sabrehagen/oberheim-dx-timeshift/PROJECT_BRIEF.md

# Oberheim DX "Snare TimeShift" modification — shared project brief

This file is the single source of truth for everyone (human or agent) working on this
project. If you discover that something here is wrong, fix it HERE first, then fix your
own deliverable, and say so in your final report.

## 1. Goal (the user's words, condensed)

Add a potentiometer to the rear panel of an Oberheim DX drum machine, next to the existing
snare tuning pot, that delays the trigger of the snare voice. Turning it up pushes the snare
later ("lays the groove back"). Range: 0 to 1 beat. 0 = unmodified behaviour.

The result is handed to an electronics technician via a GitHub repo. Documentation must be
clear enough for a high-school student to follow, while being precise enough for a skilled
technician to trust.

## 2. Why "one beat" forces a digital, tempo-aware design

A beat is a musical unit, not a time unit. One beat at 120 BPM is 500 ms; at 90 BPM it is
667 ms. A purely analog delay (RC timer / monostable) can only give a fixed number of
milliseconds, so it would be "one beat" at only one tempo. To make the pot read 0–1 beat at
any tempo the module must know the tempo. The DX exposes its tempo as a 96 PPQN
(pulses per quarter note) clock. So: delay in clock ticks = round(pot_fraction × 96).
This gives 1/96-beat resolution (5.2 ms at 120 BPM), which is finer than any human ear needs.

## 3. Chosen architecture (CHANGED BY RESEARCH, 2026-11-06; see docs/research/dx-findings.md)

> **CHANGED BY RESEARCH:** the original baseline assumed the DX had plug-in voice cards
> on card-edge slots, so the interposer would be a riser card under the snare card.
> **That is wrong.** The Oberheim DX has **no voice cards, no slots and no backplane**.
> All six voices are built on the single "DX Processor Board" (drawing 1721A). VERIFIED by
> the DX parts-layout drawing, the Electrongate DMX/DX comparison ("Removable voice cards:
> DX No") and photos of the board. The snare is triggered by **three latched logic levels**
> (`RST2`, `FFA2`, `FFB2`) coming from **U701**, a 16-pin DIP hex D flip-flop
> (MC14174B / 74C174). The interposer therefore moves from "riser under a voice card" to
> **"adapter in the U701 IC socket"**. Everything below is the corrected baseline. The
> original card-edge text was removed so that nobody builds it by mistake.

```
   DX Processor Board (one big PCB, all voices on it)
   ┌──────────────────────────────────────────────────────────────────┐
   │  Z80 ──OUT (10h)──► U701 socket (DIP-16)        snare circuit      │
   │                      pins 10/12/15 ─── traces ──► U204/U207/U208    │
   │                      (FFB2/FFA2/RST2)             (4013, 4040)      │
   └──────────────────────┬───────────────────────────────────────────┘
                          │ DIP-16 plug (Option B: 10–15 cm ribbon with DIP-16 IDC plug;
                          │              Option A: stacked machined-pin adapter, only if
                          │              the lid clearance allows, see findings Q3)
                 ┌────────┴──────────────────────────────┐
                 │ DX TIMESHIFT board                    │
                 │  [DIP-16 socket: original U701 chip]  │  13 pins straight through
                 │   pins 10,12,15 ──► MCU inputs (RST2→INT0)
                 │                └──► 74HC157 mux "A" (bypass)
                 │  [MCU: Nano] ──► 74HC157 mux "B" (delayed)
                 │  74HC157 Y ──► plug pins 10,12,15 ──► back to the DX snare circuit
                 └────────────────────────────────────────┘
   Rear panel: [DELAY pot 10k lin]──3-wire lead──► J_POT
   Clock tap:  CLOCK OUT node (Q709 collector / R791 lead) ──10 kΩ──► J_CLK (Schmitt input)
```

Design principles, in priority order:
1. **Reversible.** No cuts to original Oberheim PCBs. Unplug the TimeShift plug, put the
   original U701 chip back in its socket, unclip the clock lead, and the DX is stock. The only
   permanent change is one hole in the rear panel for the pot. **CHANGED BY RESEARCH:** this
   needs U701 to be socketed. Photos of two DX units indicate it is, but this is TO BE
   CONFIRMED (findings Q1). If it is soldered, the only option is to desolder it and fit a
   socket, which is a permanent but restorable change. Tell the owner before doing it.
2. **Transparent at zero.** With the pot at 0 the module passes the snare lines through with
   no added logic delay worth mentioning. **CHANGED BY RESEARCH:** do this with a hardware
   2:1 mux (74HC157) whose select line is pulled to "bypass" by a resistor. Pot = 0, MCU in
   reset, MCU unprogrammed → the DX behaves stock, with about 10 ns added. Level (soft/medium/loud)
   information must be preserved exactly.
3. **Technician-friendly.** Through-hole parts, 2.54 mm headers, a socketed Arduino Nano
   (ATmega328P, 5 V, 16 MHz) programmed over USB with the Arduino IDE. No SMD soldering required.
4. **Honest documentation.** Every pin number, signal name and connector type is labelled either
   VERIFIED (with a citation to the service manual page / schematic sheet) or
   TO BE CONFIRMED ON THE BENCH (with the exact measurement the technician should make).
5. **Model check first (CHANGED BY RESEARCH).** The pin numbers are for the plain **DX
   (board 1721A)**. On the **DXa** (factory MIDI, board 1906) the snare lines are on **U715
   pins 7/5/2**, not U701 pins 15/12/10. The PCB must be marked with the model it fits.

### 3.1 Signal capture/replay detail (CHANGED BY RESEARCH)

* **What the Z80 actually does (VERIFIED, schematic + firmware disassembly):** `OUT (10h),A`
  with D3 = RST2, D4 = FFA2, D5 = FFB2 (D0–D2 are the BASS voice: leave them alone). The write
  strobe GEN0* clocks U701 on its rising edge, and U701's outputs then **hold** those levels
  until the next write. A snare hit is **three writes**: (1) new FFA2/FFB2 level with RST2 = 0,
  (2) RST2 = 1, (3) RST2 = 0. RST2 high resets the snare sample address counter (level-sensitive
  CD4040 reset). The RST2 rising edge also clocks the DX's level flip-flops. **The sound starts
  on the RST2 falling edge.** RST2 is high for about **9 µs** (firmware 1.5) up to about
  **0.2 ms** (firmware 1.20). TO BE CONFIRMED with a logic analyser (findings Q2).
* **Capture:** U701 itself is the capture latch, so no 74HC574 is needed. Wire U701 pin 15
  (RST2) to the Nano's **INT0 (D2), rising edge**. The AVR latches the edge flag in hardware,
  so a 9 µs pulse is never lost. In the ISR read FFA2 (pin 12) and FFB2 (pin 10); they are
  stable for ≥ 1 ms. Push (FFA2, FFB2, timestamp) into the FIFO. A 74HC74 edge flag is
  optional.
* **Replay:** when an event is due, drive `FFA2_OUT`/`FFB2_OUT` to the captured levels, wait
  ≥ 1 µs, drive `RST2_OUT` high for ≥ 10 µs, then low. Keep FFA2/FFB2 held until the next
  replayed event (they are level-sensitive on the snare circuit for the whole sound).
* **Isolation:** U701 pins 10/12/15 on the chip side go ONLY to the TimeShift inputs. The
  matching pins of the plug that goes into the DX socket are driven ONLY by the 74HC157
  output. There is no straight-through connection for those three pins. All other 13 pins
  are straight through.
* **Bypass:** pot exactly 0, or MCU not running → 74HC157 selects the U701 outputs directly
  (hardware path, no firmware latency). Change the mux select only while RST2 is low on
  both sides.
* Edge case: a new snare hit arriving while one is queued → both are queued; FIFO depth ≥ 32.
  Hits queued before STOP still play after STOP. Optionally flush the queue if no clock pulse
  has been seen for > 125 ms (the DX's own auto-stop timeout).

### 3.2 Tempo reference

* Count rising edges of the DX clock. **VERIFIED:** the DX's internal tempo timer interrupts
  96 times per quarter note, and the firmware pulses CLOCK OUT once per interrupt (96 PPQN).
  delay_ticks = round(pot_fraction × PPQN). Fire the queued event on the tick when
  (ticks_since_capture ≥ delay_ticks), with sub-tick interpolation using the measured tick
  period so the pot feels continuous rather than stepped.
* **CHANGED BY RESEARCH:** on a DXa, Stretch DX or Electrongate-MIDI DX, CLOCK OUT can be set
  to 24, 48 or 96 PPQN (edit parameter 03; when slaved to MIDI it is forced to 24). Add a
  **PPQN jumper (96 default / 48 / 24)** read by the firmware.
* No clock present (sequencer stopped, pads played by hand): use the last measured tick period;
  if none ever seen, assume 120 BPM. Document this behaviour. (Whether the DX keeps sending
  CLOCK OUT while stopped is TO BE CONFIRMED, findings Q5.)
* **Where to tap (CHANGED BY RESEARCH):** the rear jacks are soldered onto the main board, so
  the "jumper to the jack tip" fallback would mean soldering under the board. Instead tap the
  CLOCK OUT node on the top of the board. Use the lead of **R791 (1 kΩ)** on the Q709-collector
  side: same signal as the jack tip, 0/5 V, idles low, **rising edge = tick**. Use a clip-on
  mini-grabber, or tack-solder to the resistor lead. Alternative: R792's U710 side (= COUT,
  opposite polarity). Feed it through 10 kΩ series into a Schmitt input (74HC14 or equivalent)
  on the TimeShift.

### 3.3 Power (CHANGED BY RESEARCH)

+5 V and GND from U701 socket pins 16 and 8 through the plug (no extra wires). Budget < 60 mA
total. Add 100 nF decoupling per IC and a 10 µF bulk cap. **There are no ±12 V rails on this
socket.** Never use the battery-backed "+5M" rail. If the measured drop between the "+5 TEST
PAD" and U701 pin 16 exceeds 50 mV with the module running, add a separate 2-wire lead to the
+5 test pad (findings Q7). The DX PSU is linear: µA723 + 2N3055, current limit about 2.6 A
(inferred); the unit is rated 19 W from the mains.

### 3.4 Panel pot

10 kΩ linear, 1/4" (6.35 mm) or 6 mm shaft, panel-mount, solder lugs. Wiring: CW end → +5 V,
CCW end → GND, wiper → MCU ADC input via 1 kΩ series + 100 nF to ground (RC filter). 3-pin
JST-XH on the TimeShift board. Label the panel "SNARE DELAY  0 ◄──► 1 BEAT".
**CHANGED BY RESEARCH:** the DX's six DRUM TUNING pots have short bare shafts with **no knobs**.
SNARE is second from the right when you look at the rear panel. Either match that (short shaft,
no knob) or use a small knob. Candidate hole: directly below the SNARE tuning pot, in the
blank band above the output-jack labels. The space behind the panel must be confirmed first,
because the tuning-pot PCB is mounted there (findings Q6).

### 3.5 Definitive board interface (LOCKED by orchestrator — every agent uses exactly this)

**Arduino Nano (ATmega328P, 5 V) pin assignment**

| Nano pin | Direction | Net name  | Purpose |
|---|---|---|---|
| D2 (INT0) | in  | RST2_IN  | from U701 pin 15 (chip side). Rising edge = snare hit captured |
| D3 (INT1) | in  | CLK_IN | DX clock tick after Schmitt buffer. Rising edge = 1 tick |
| D4 | in  | FFA2_IN  | from U701 pin 12 (chip side), level bit A |
| D5 | in  | FFB2_IN  | from U701 pin 10 (chip side), level bit B |
| D6 | out | RST2_OUT | replayed trigger → 74HC157 input 1B |
| D7 | out | FFA2_OUT | replayed level A → 74HC157 input 2B |
| D8 | out | FFB2_OUT | replayed level B → 74HC157 input 3B |
| D9 | out | MUX_SEL  | 74HC157 S (pin 1). LOW = A = bypass (10 kΩ pull-down to GND), HIGH = B = delayed |
| D10 | in | PPQN_J1  | jumper to GND, internal pull-up. open/open = 96, JP1 1-2 closed = 48, JP1 3-4 closed = 24 |
| D11 | in | PPQN_J2  | see above |
| D12 | out | TP_REPLAY | test point: pulses high whenever a delayed hit is replayed |
| D13 | out | LED_ACT  | on-board LED: flashes on each captured hit; steady when in bypass |
| A0 | in | POT_W | pot wiper, via 1 kΩ series + 100 nF to GND |

**74HC157 (U3, quad 2:1 mux)**: pin 1 S = MUX_SEL; pin 15 /E = GND (always enabled);
channel 1: 1A = RST2 chip side (U701 pin 15), 1B = RST2_OUT, 1Y → plug pin 15;
channel 2: 2A = FFA2 chip side (U701 pin 12), 2B = FFA2_OUT, 2Y → plug pin 12;
channel 3: 3A = FFB2 chip side (U701 pin 10), 3B = FFB2_OUT, 3Y → plug pin 10;
channel 4 unused: 4A, 4B to GND, 4Y n/c.

**74HC14 (U4, hex Schmitt inverter)**: clock conditioning. J_CLK pin 1 → 10 kΩ series (R_CLK1)
→ node with 100 kΩ pull-down (R_CLK2) and 1 nF to GND → U4 gate 1 → gate 2 → CLK_IN (two
inversions = non-inverting, so rising edge at R791 = rising edge at D3). Unused inputs to GND.

**U1**: DIP-16 socket that receives the ORIGINAL U701 chip removed from the DX (MC14174B / 74C174).
Pins 1–9, 11, 13, 14, 16 of U1 connect straight to the same-numbered pin of the plug J1.
U1 pins 10, 12, 15 connect ONLY to the Nano inputs and the 74HC157 "A" inputs. J1 pins 10, 12,
15 are driven ONLY by the 74HC157 "Y" outputs. Add 1 kΩ series resistors between U1 pins
10/12/15 and the Nano inputs D5/D4/D2 for protection; the mux A inputs connect directly.

**J1 "DX PLUG"**: 2×8 2.54 mm shrouded box header (pin 1 marked). A 16-way ribbon with a
DIP-16 IDC plug on the far end goes into the DX's U701 socket. Standard DIP IDC plug mapping
(ribbon conductor n → header pin n): header 1→DIP 1, 2→DIP 16, 3→DIP 2, 4→DIP 15, 5→DIP 3,
6→DIP 14, 7→DIP 4, 8→DIP 13, 9→DIP 5, 10→DIP 12, 11→DIP 6, 12→DIP 11, 13→DIP 7, 14→DIP 10,
15→DIP 8, 16→DIP 9. The schematic nets on J1 MUST already use DIP pin numbers after this
mapping (i.e. label the box header pins with the DIP pin they end up on). This mapping is TO BE
CONFIRMED with a continuity meter before first power-up (documented as a mandatory step).
Ribbon length 10–15 cm. Option A (stacked machined-pin header plug directly into the socket)
is a documented alternative only if lid clearance allows.

**J2 "POT"**: 3-pin JST-XH, pin 1 = GND (CCW lug), pin 2 = wiper, pin 3 = +5 V (CW lug).
**J3 "CLK"**: 2-pin JST-XH, pin 1 = CLK signal (to R791 lead, Q709 collector side), pin 2 = GND.
**JP1**: 2×2 pin header for PPQN_J1 / PPQN_J2 to GND (use a jumper shunt).
**TP1** = TP_REPLAY, **TP2** = RST2 chip side, **TP3** = RST2 plug side, **TP4** = GND, **TP5** = CLK_IN.
**Power**: C_bulk 10 µF electrolytic across +5/GND at J1; 100 nF ceramic next to U1, U3, U4 and Nano.
**Board** (as built, rev A): 2-layer, 84.0 × 63.0 mm (grew from the planned 65 × 40 mm because the through-hole parts did not fit), 4 × M3 mounting holes (3.2 mm) on 77 × 56 mm centres, all
through-hole. Silkscreen: "DX TIMESHIFT rev A — SNARE — fits Oberheim DX board 1721A (U701).
NOT for DXa (U715)". Nano on two 1×15 female headers so it is removable.
**USB warning (added after firmware review):** the Nano's 5 V pin sits on the DX logic rail, so
plugging a USB cable into the Nano while it is installed in a switched-off DX would try to power
the whole DX logic board from the USB port. Silkscreen must say "UNPLUG NANO BEFORE USB" next to
the Nano, and every document that mentions flashing must say: flash the Nano OUT of the board,
or only with the DX switched on.

### 3.6 Firmware behaviour (LOCKED)

* Boot: all outputs low, MUX_SEL low (bypass), read PPQN jumpers once, LED steady on.
* Pot read at ~100 Hz, 16-sample average, with hysteresis so the delay doesn't jitter.
  pot ≤ 1 % → BYPASS mode (MUX_SEL low). Otherwise DELAY mode: delay_beats = pot_fraction
  (1 % … 100 %), clamp to 1.00 beat.
* Entering DELAY mode: copy the current chip-side FFA2/FFB2 levels to FFA2_OUT/FFB2_OUT, set
  RST2_OUT low, then raise MUX_SEL. Leaving DELAY mode: wait until no replay is in progress,
  drop MUX_SEL. Never change MUX_SEL while either RST2 is high.
* INT0 ISR (RST2_IN rising): read FFA2_IN/FFB2_IN, push {levelA, levelB, t_us = micros(),
  ticks_at_capture} into a 32-deep ring buffer. Toggle LED.
* INT1 ISR (CLK_IN rising): tick_count++, measure tick period (µs) with a 4-tick moving average.
  Clock timeout: if no tick for > 2 s treat as "stopped" but keep the last period.
* Scheduler (main loop): a captured event is due when elapsed_us ≥ delay_beats × PPQN ×
  tick_period_us (tempo-aware, continuous). Default tick_period when never clocked =
  60e6 / (120 × PPQN) µs. Replay = set level outputs, delayMicroseconds(2), RST2_OUT high for
  20 µs, low. Pulse TP_REPLAY alongside.
* Multiple queued events are all replayed in order. Events older than 4 s are dropped.
* Serial (115200 baud) prints a one-line status every second for debugging: mode, pot %, PPQN,
  BPM estimate, queue depth, hits captured/replayed. Serial must never block or delay replay.

## 4. Repository layout (all agents write into these paths)

```
PROJECT_BRIEF.md              this file
README.md                     front page for the technician (docs agent)
docs/
  00-start-here.md            plain-language overview, what to buy, how long it takes
  01-theory-of-operation.md   how the DX triggers voices, how the mod works, timing diagrams
  02-build-the-board.md       assembly steps with photos/renders, checklist
  03-install-in-the-dx.md     step-by-step install, panel drilling, wiring, safety
  04-test-and-calibrate.md    bench tests, expected measurements, troubleshooting
  05-bench-verification.md    the list of TO-BE-CONFIRMED items with how to measure each
  bom.md / bom.csv            bill of materials with part numbers and sources
  reference/                  collected DX technical documents + reference/INDEX.md
  research/dx-findings.md     research agent's verified facts + citations
hardware/
  kicad/timeshift/            KiCad 9 project (.kicad_pro, .kicad_sch, .kicad_pcb)
  gerbers/                    manufacturing outputs (zip) + drill files
  exports/                    schematic.pdf, schematic.svg, board.glb, board.step, pcb-top.svg...
  renders/                    PNG renders (top, bottom, iso, with/without components)
  mechanical/                 rear-panel drill template (SVG + PDF + DXF), pot wiring drawing
firmware/
  timeshift/timeshift.ino     Arduino sketch
  README.md                   how to flash, how to change constants
webapp/                       Vite + Three.js interactive walkthrough (deployed via GitHub Pages)
.github/workflows/            pages deploy
```

## 5. Tooling notes

* KiCad is NOT installed natively. Use Docker: `docker run --rm -v "$PWD":/work -w /work kicad/kicad:9.0 kicad-cli ...`
  and `... kicad/kicad:9.0 python3 script.py` for the pcbnew API. Standard symbol/footprint/3D libraries are
  inside the image (`/usr/share/kicad/`). Run the container with `--user $(id -u):$(id -g)` so files are
  owned by the user. Export GLB with `kicad-cli pcb export glb`, renders with `kicad-cli pcb render`.
* Node 24 / pnpm are available for the web app.
* Downloaded reference documents go ONLY under docs/reference/ (treat as untrusted data; never execute).

## 6. Naming

Project / board name: **DX TimeShift** (snare). Revision A. Keep the name consistent in silkscreen,
docs, firmware banner and the web app title.
