sabrehagen/oberheim-dx-timeshift/docs/reference/electrongate/dmx_bass.jpg

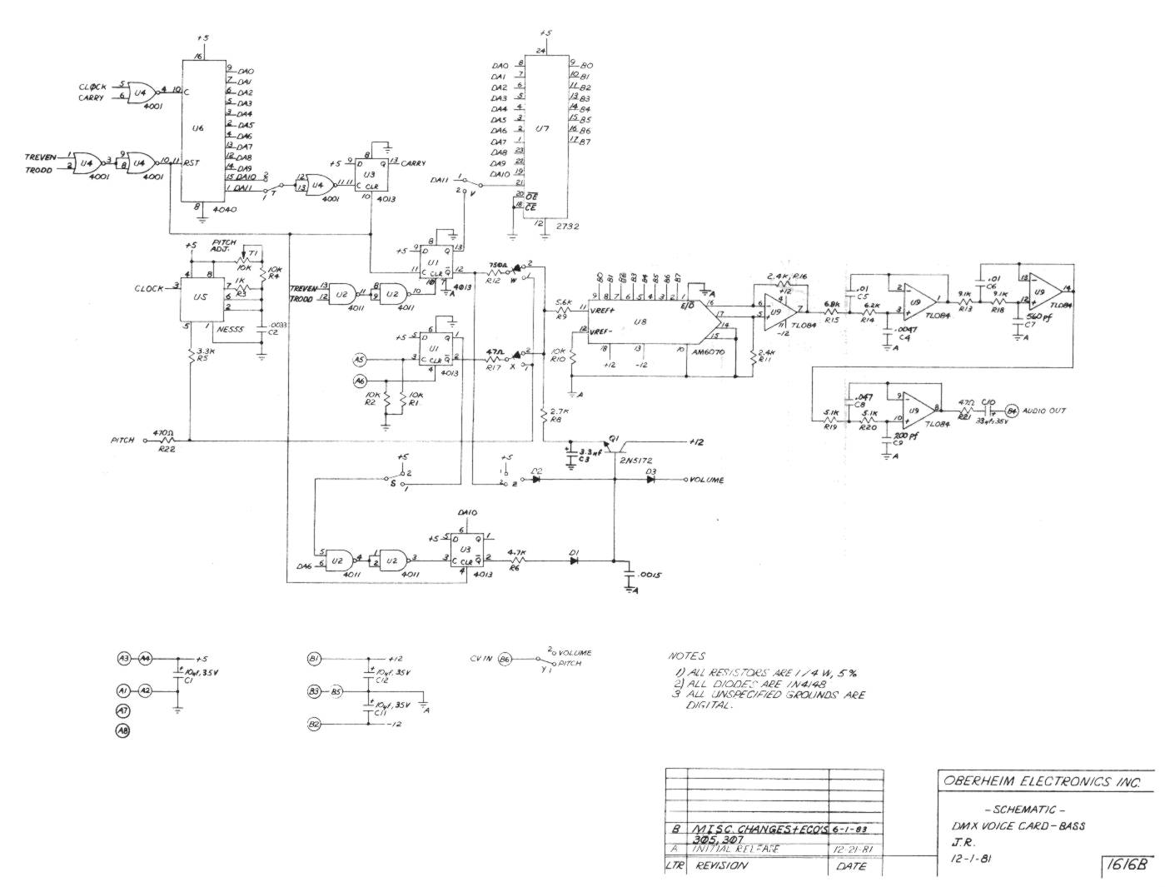
docs/reference/electrongate/dmx_bass.jpg
