sabrehagen/oberheim-dx-timeshift/docs/reference/electrongate/dmx_mkii.jpg

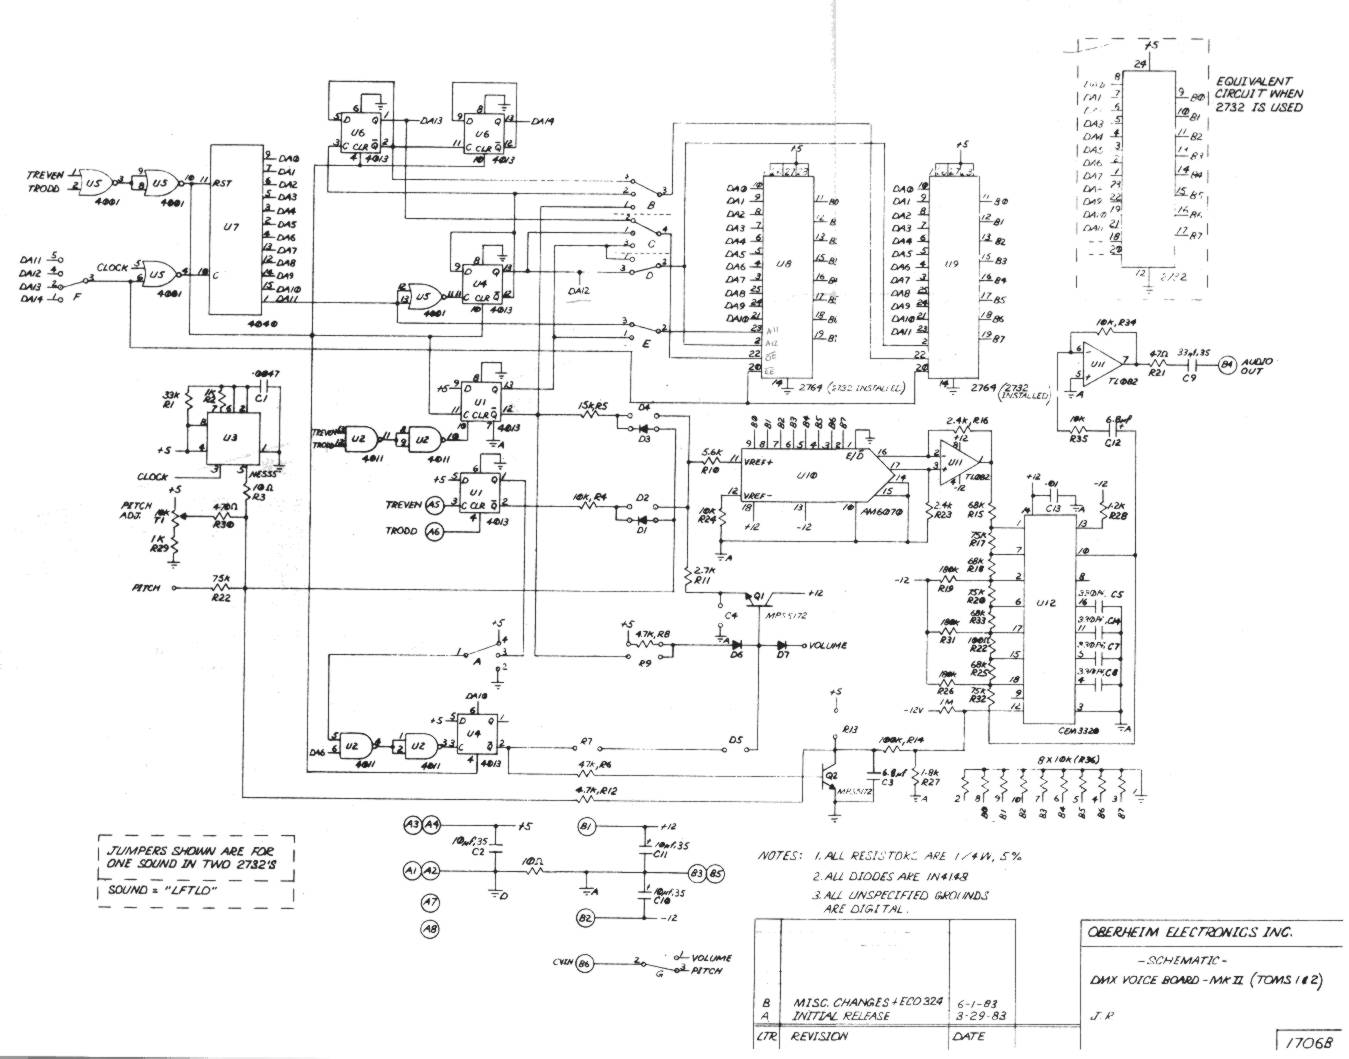
docs/reference/electrongate/dmx_mkii.jpg
