sabrehagen/oberheim-dx-timeshift/docs/reference/electrongate/dmx_proc_1of3.jpg

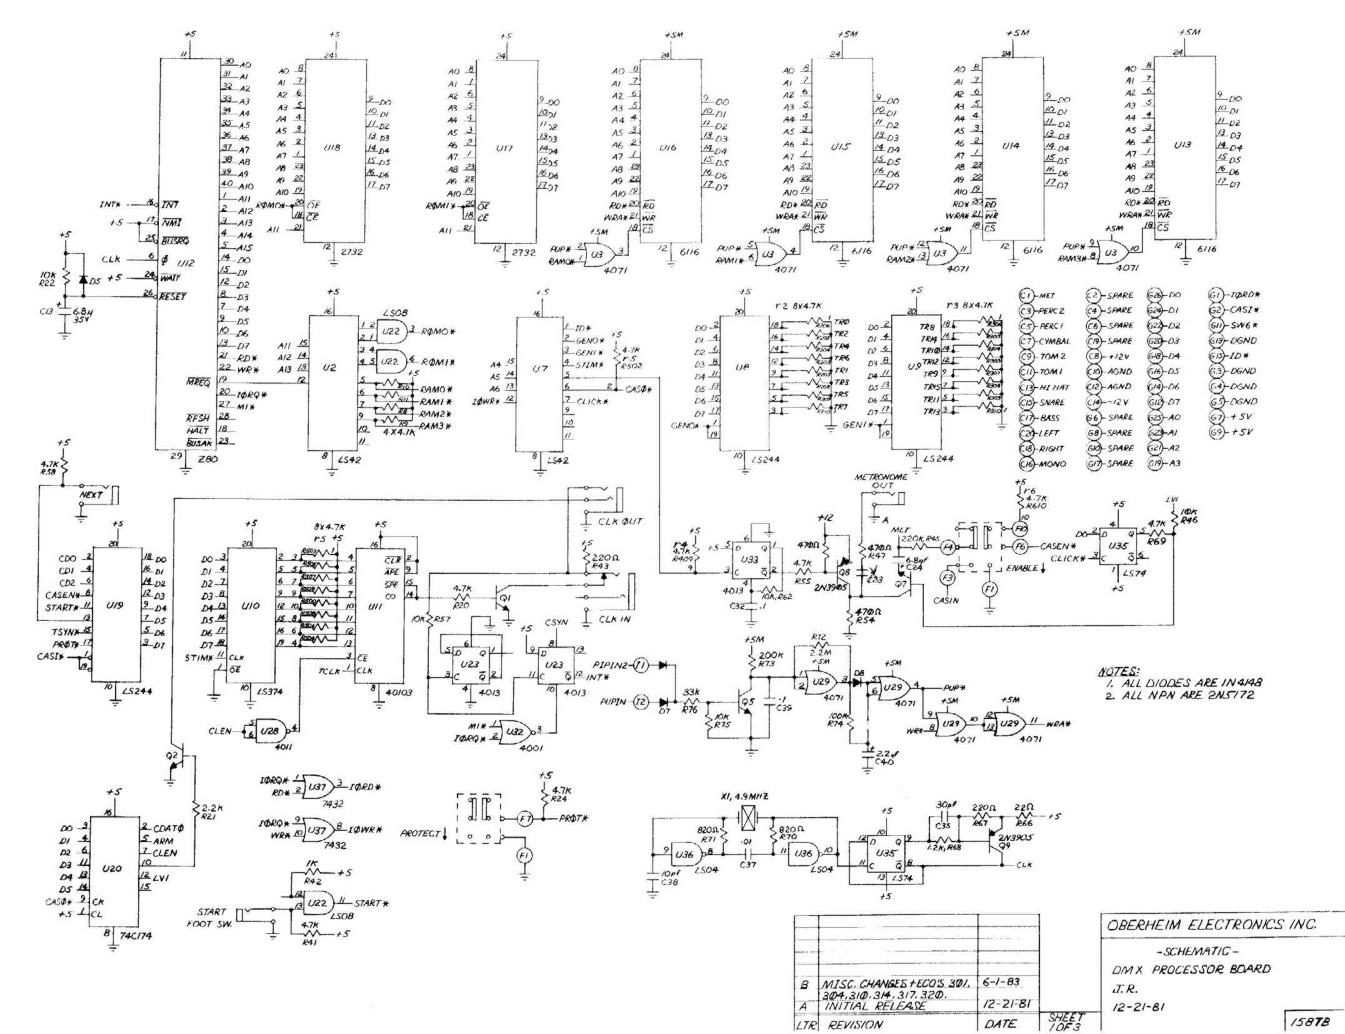
docs/reference/electrongate/dmx_proc_1of3.jpg
