sabrehagen/oberheim-dx-timeshift/docs/reference/electrongate/dmx_proc_2of3.jpg

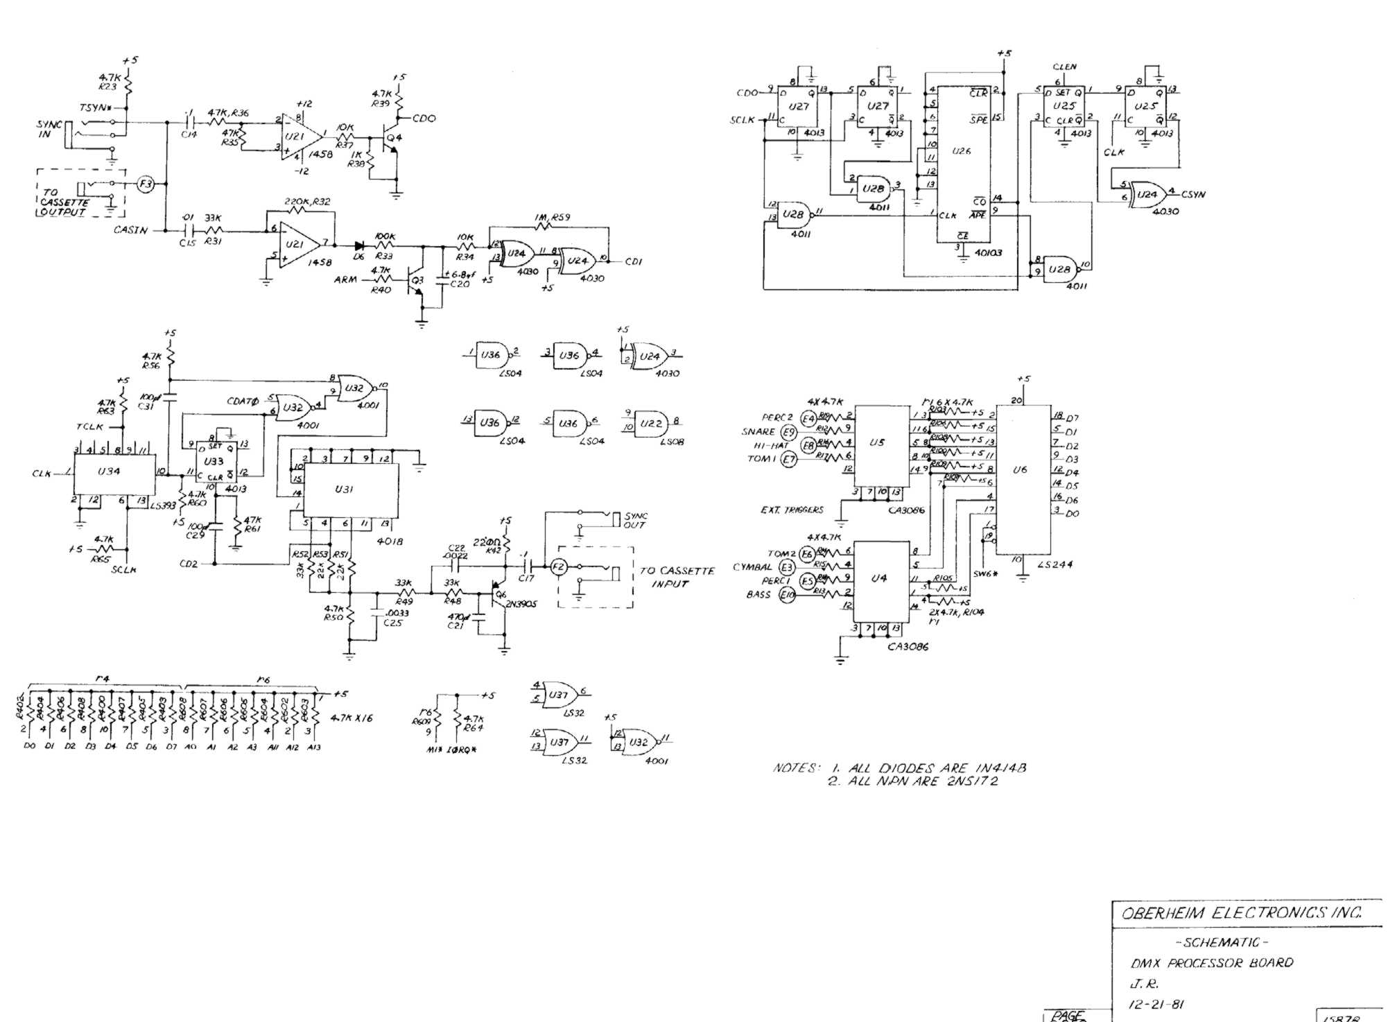
docs/reference/electrongate/dmx_proc_2of3.jpg
