sabrehagen/oberheim-dx-timeshift/docs/reference/electrongate/dmx_proc_3of3.jpg

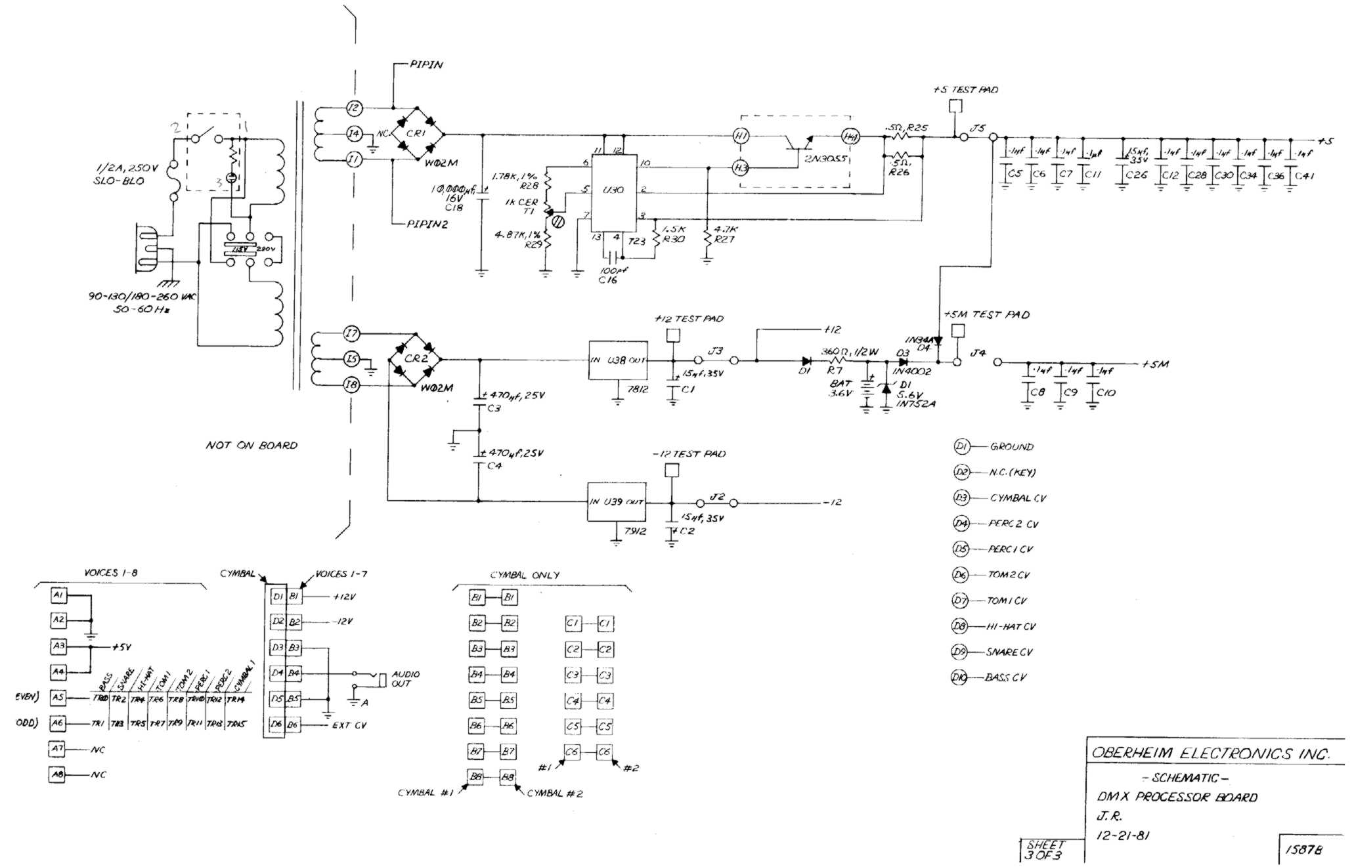
docs/reference/electrongate/dmx_proc_3of3.jpg
