sabrehagen/oberheim-dx-timeshift/docs/reference/electrongate/dmx_proc_fab.jpg

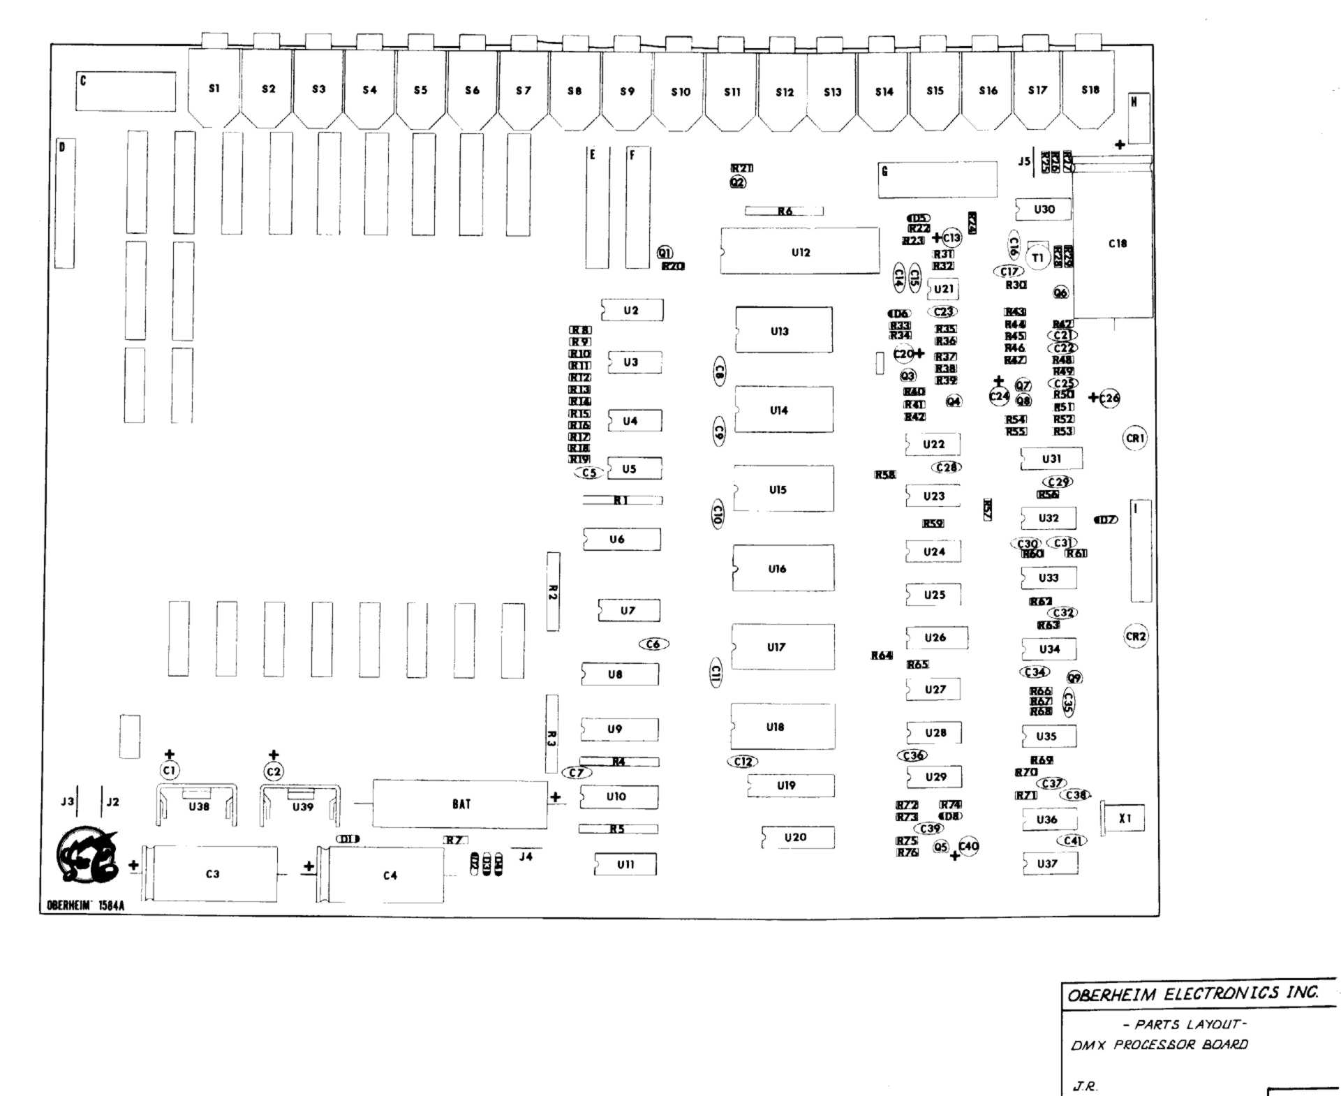
docs/reference/electrongate/dmx_proc_fab.jpg
