sabrehagen/oberheim-dx-timeshift/docs/reference/electrongate/dsx_sch4.png

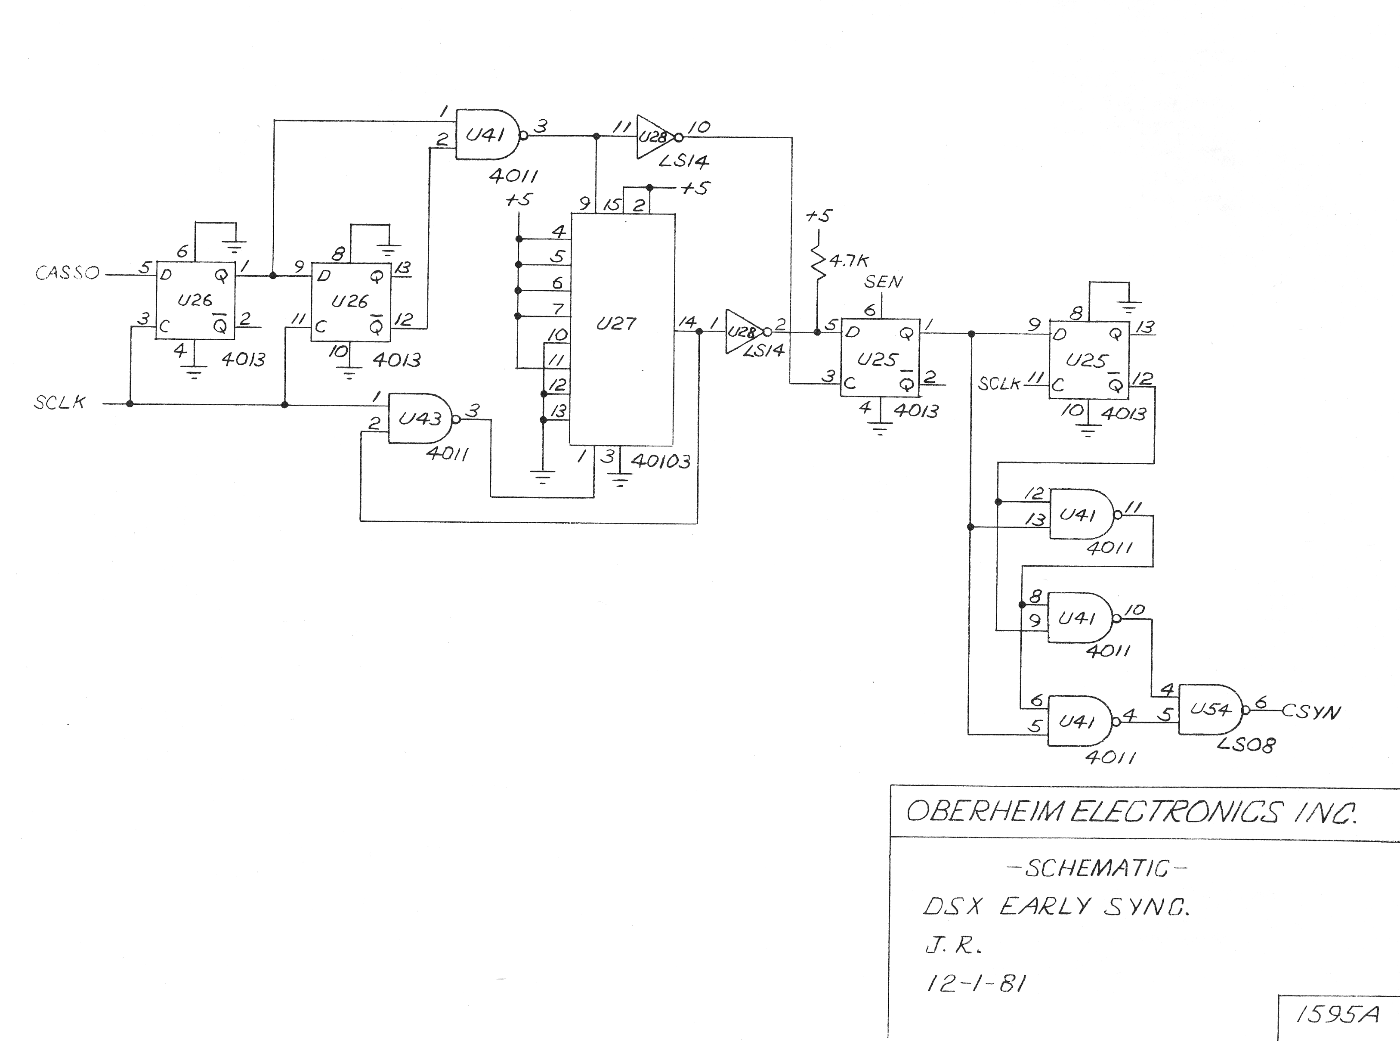
docs/reference/electrongate/dsx_sch4.png
