sabrehagen/oberheim-dx-timeshift/docs/reference/electrongate/dsx_sch6.png

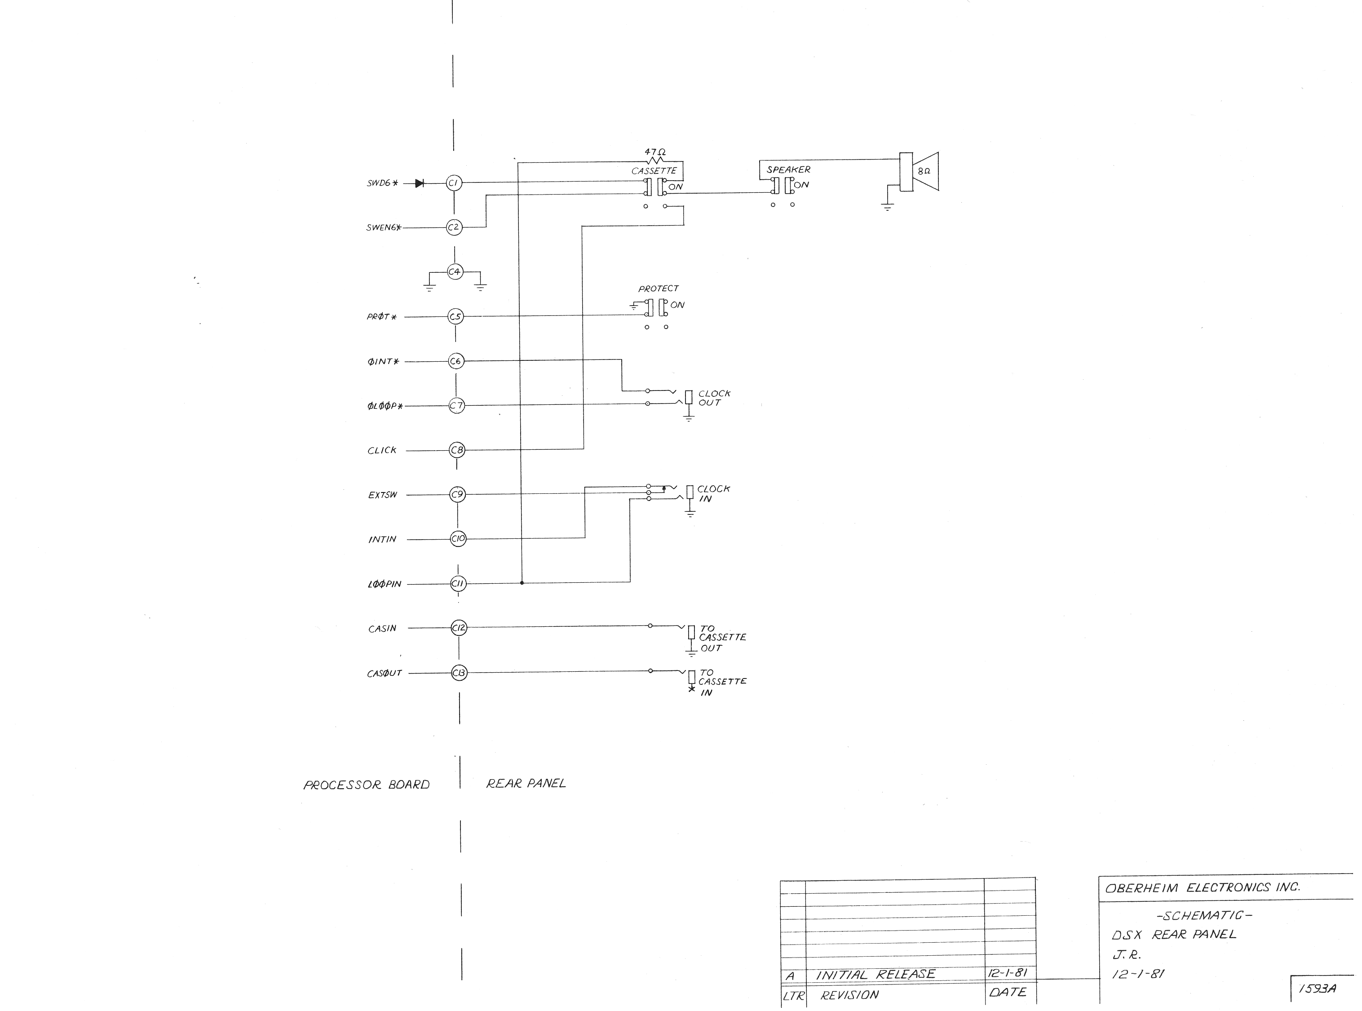
docs/reference/electrongate/dsx_sch6.png
