sabrehagen/oberheim-dx-timeshift/docs/reference/electrongate/dx_pot_board.jpg

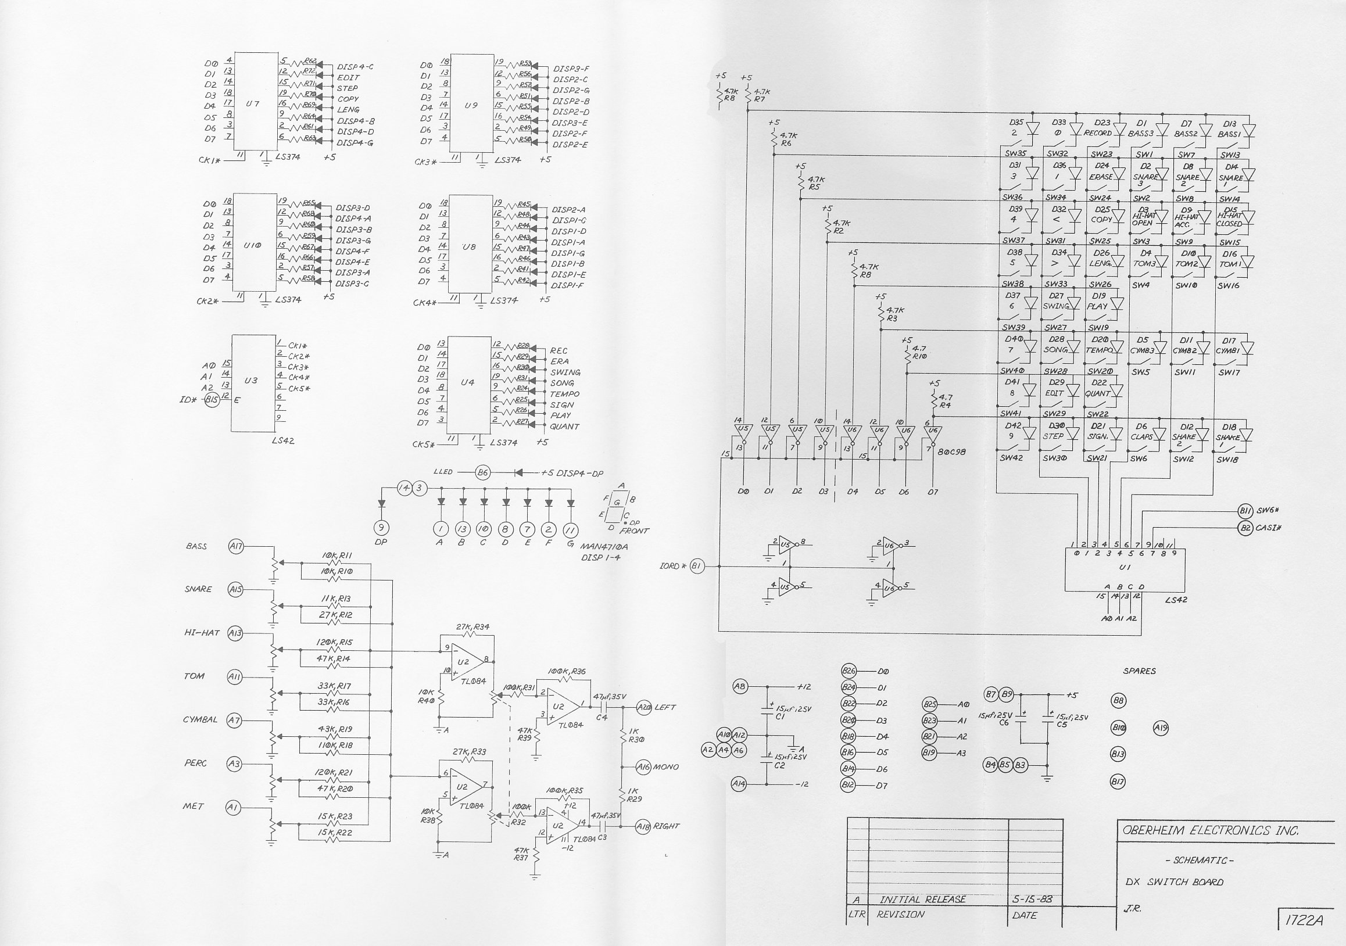
docs/reference/electrongate/dx_pot_board.jpg
