sabrehagen/oberheim-dx-timeshift/docs/reference/electrongate/dx_pot_board_layout.jpg

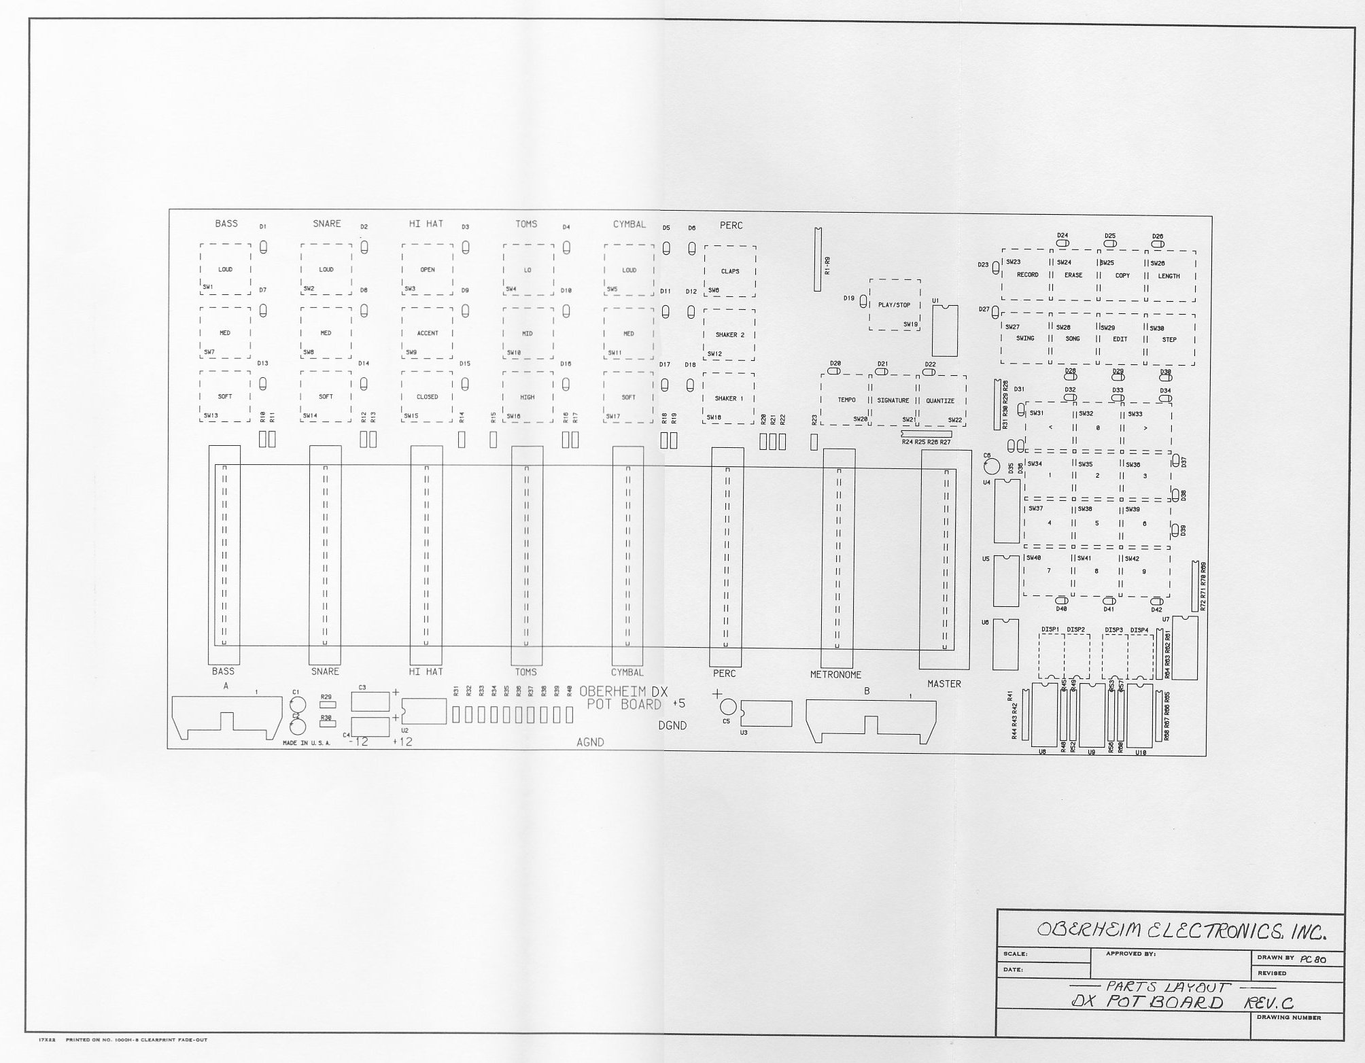
docs/reference/electrongate/dx_pot_board_layout.jpg
