sabrehagen/oberheim-dx-timeshift/docs/reference/electrongate/dx_proc_6_of_7.jpg

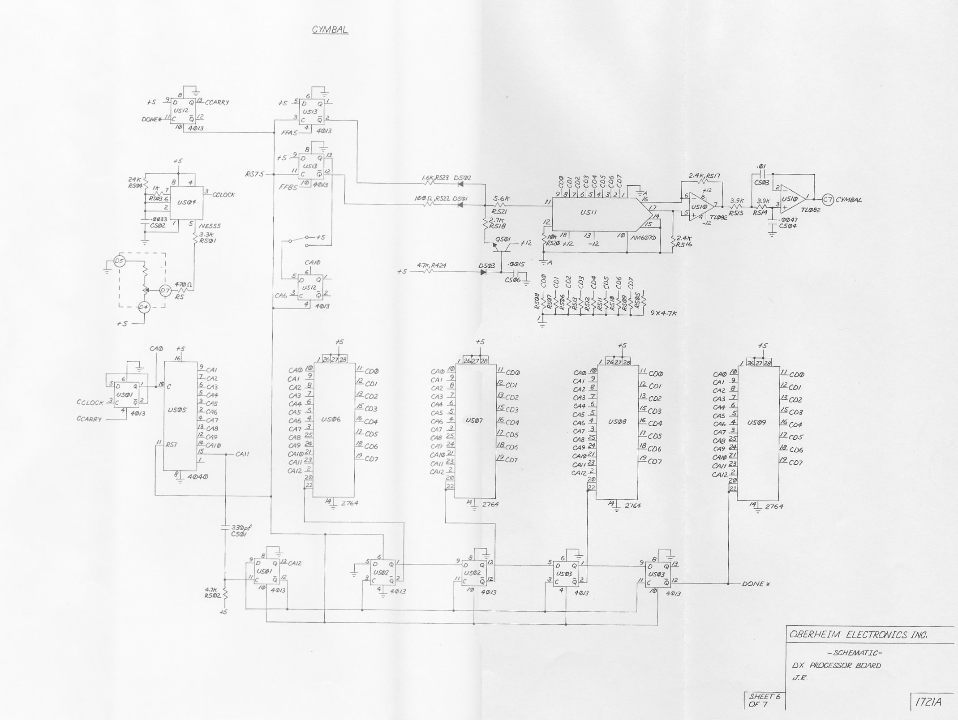
docs/reference/electrongate/dx_proc_6_of_7.jpg
