sabrehagen/oberheim-dx-timeshift/docs/reference/electrongate/dx_proc_board_layout.jpg

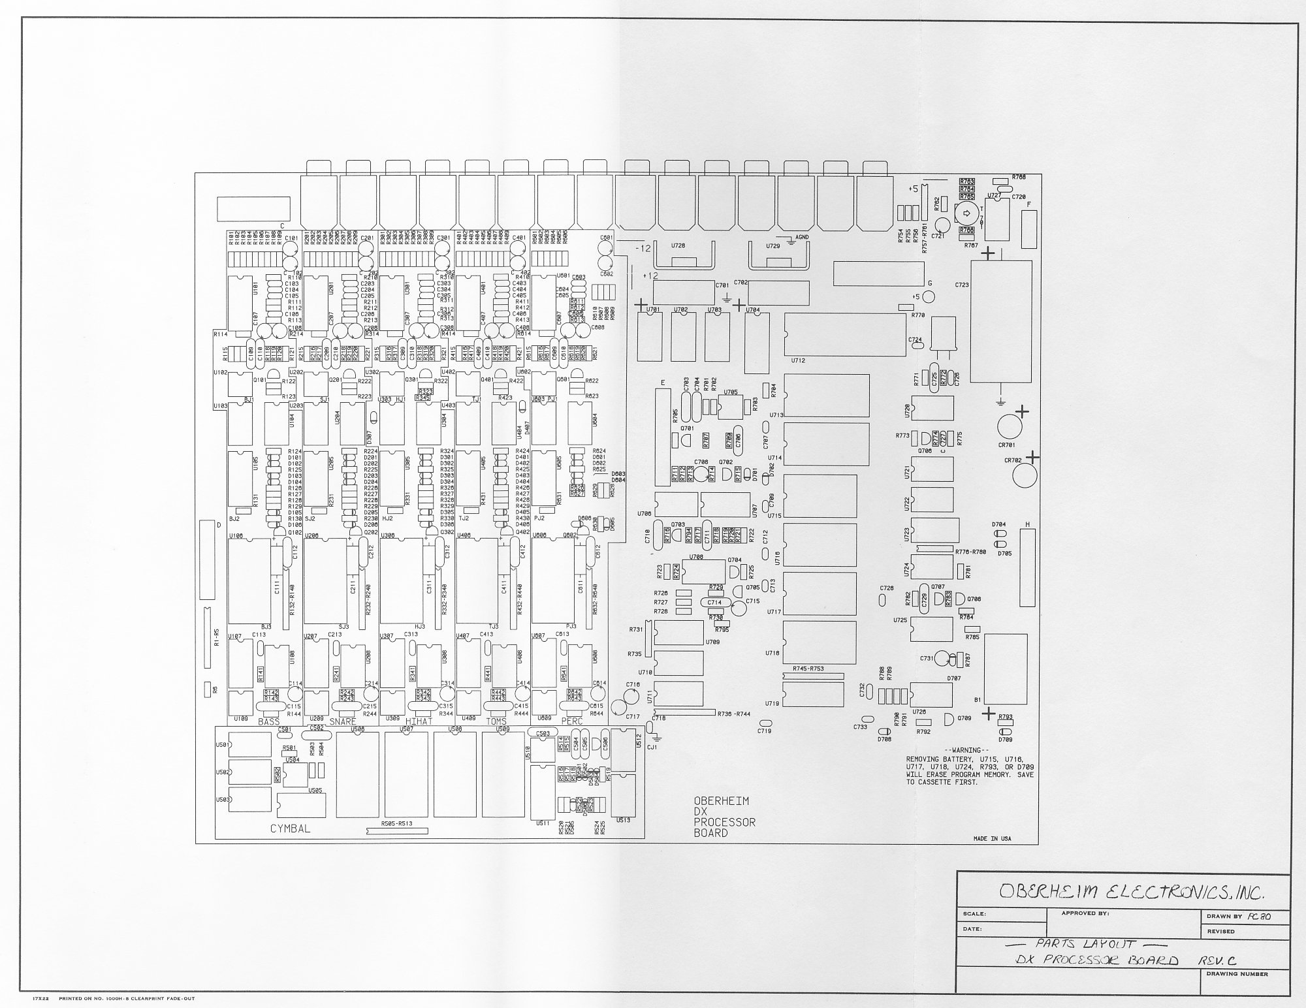
docs/reference/electrongate/dx_proc_board_layout.jpg
