sabrehagen/oberheim-dx-timeshift/docs/reference/electrongate/dxa_p1.jpg

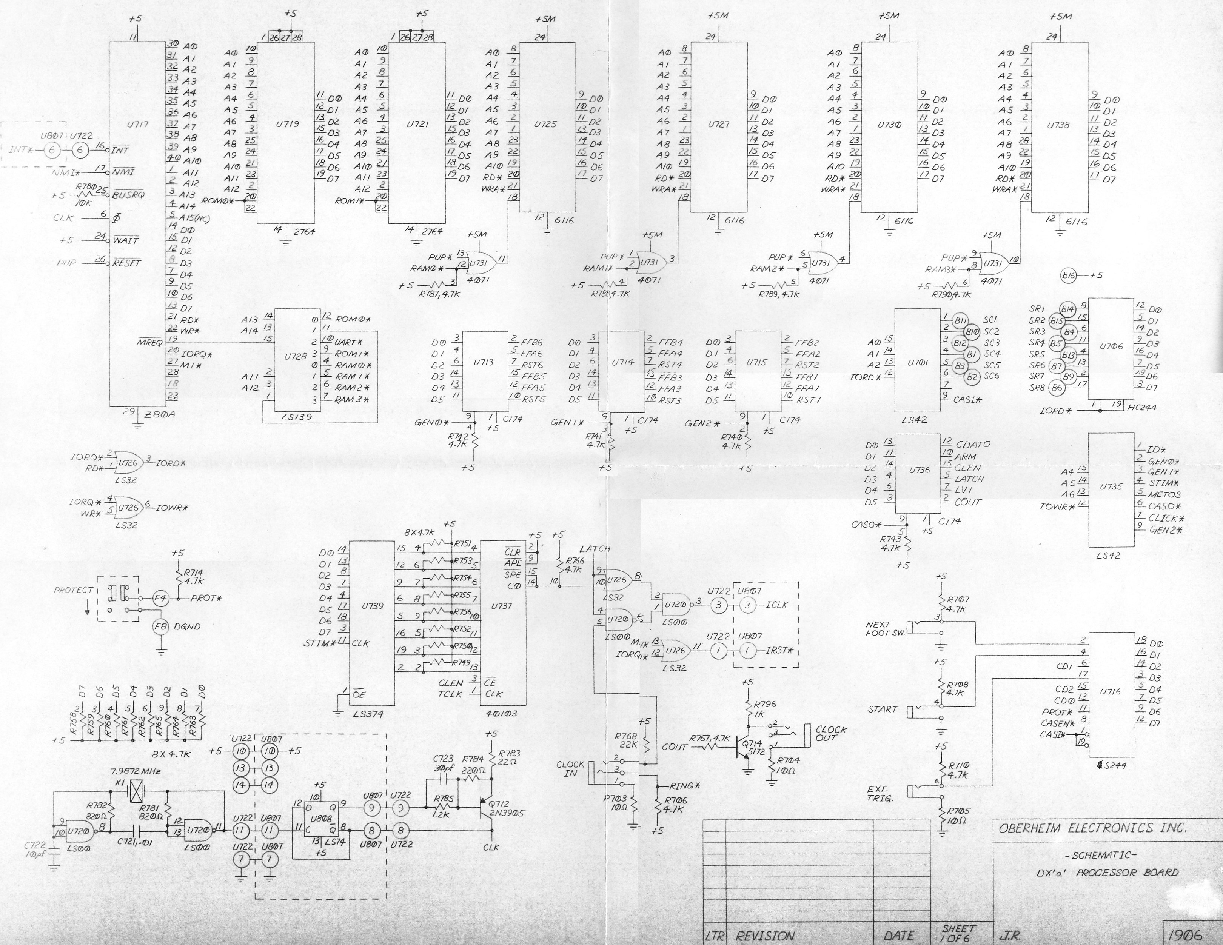
docs/reference/electrongate/dxa_p1.jpg
