sabrehagen/oberheim-dx-timeshift/docs/reference/electrongate/dxa_p2.jpg

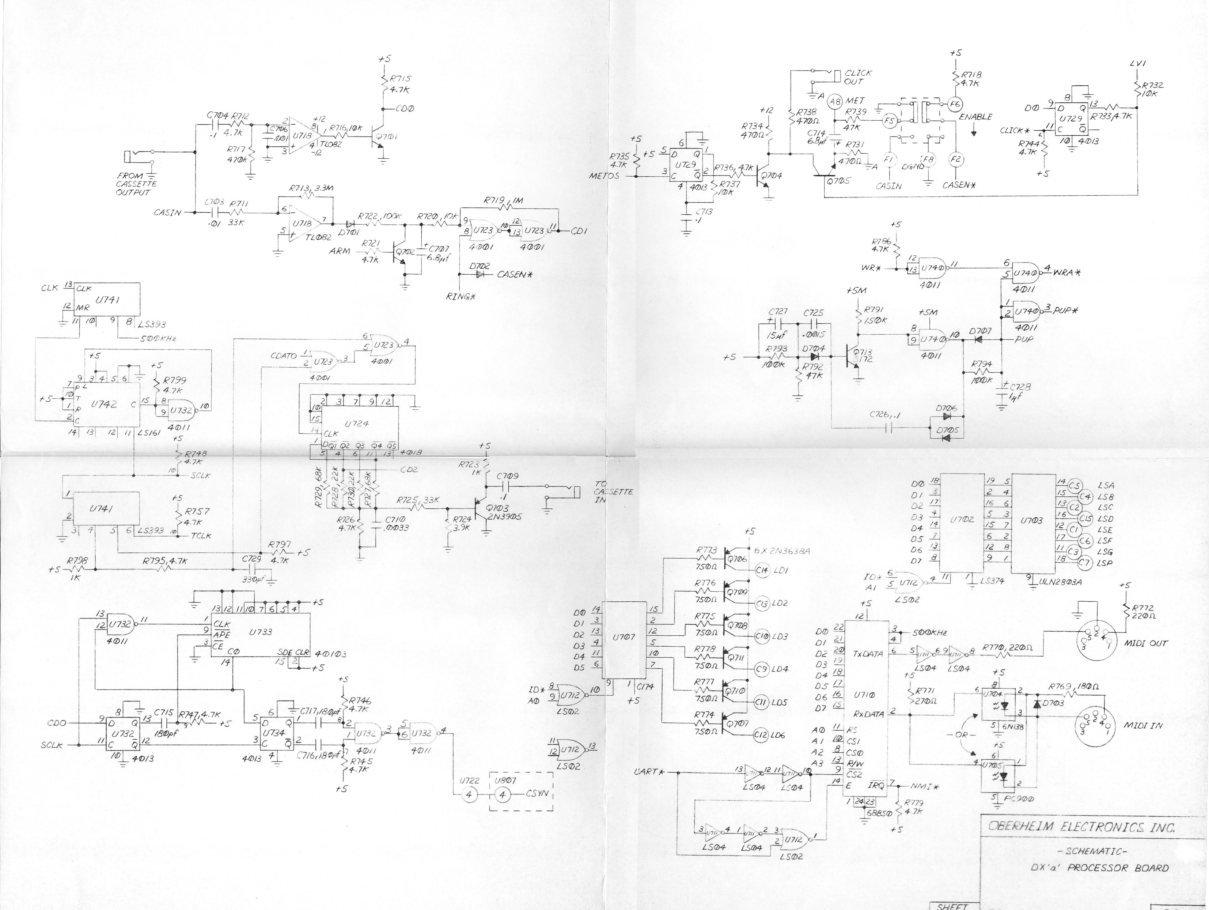
docs/reference/electrongate/dxa_p2.jpg
