sabrehagen/oberheim-dx-timeshift/docs/reference/electrongate/dxa_p3.jpg

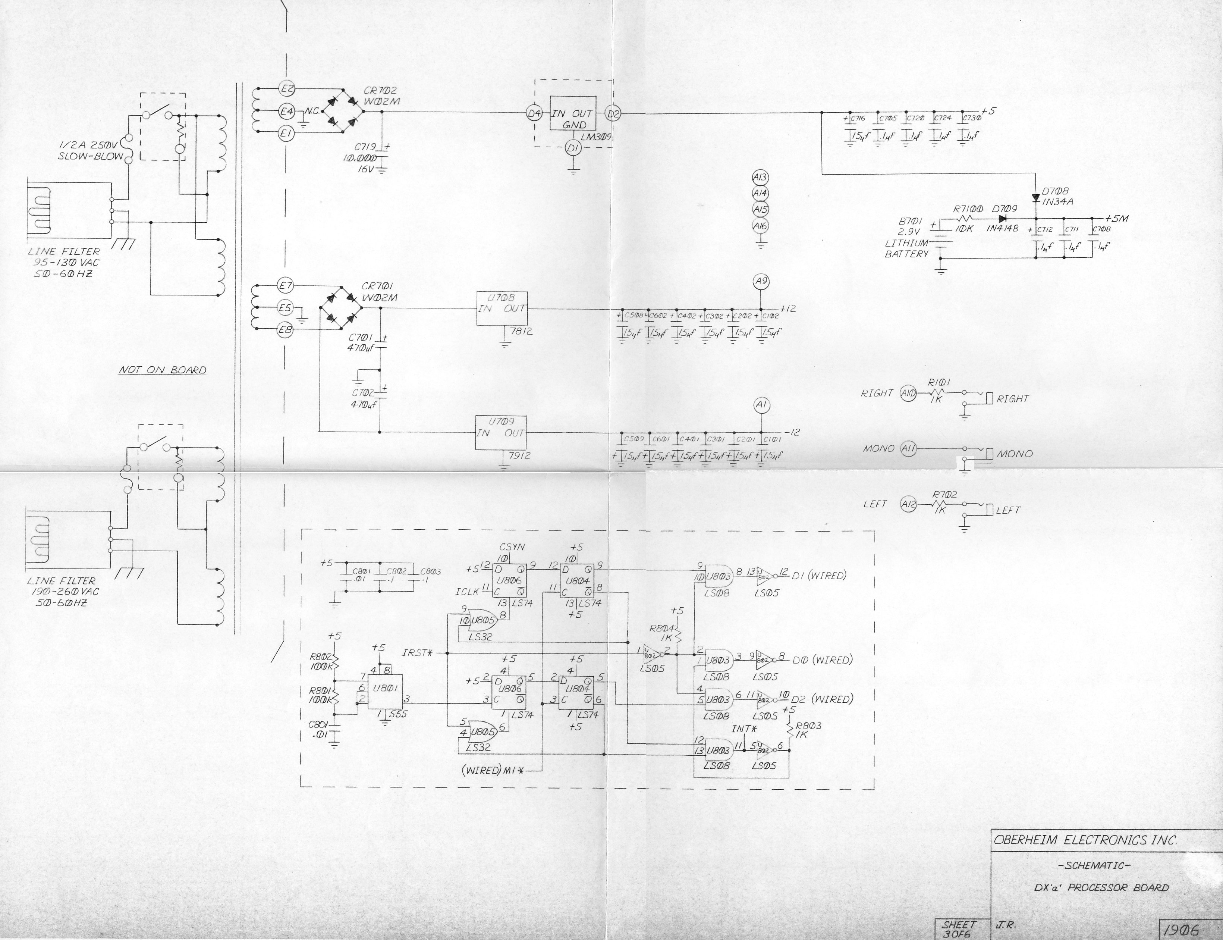
docs/reference/electrongate/dxa_p3.jpg
