sabrehagen/oberheim-dx-timeshift/docs/reference/electrongate/dxa_p4.jpg

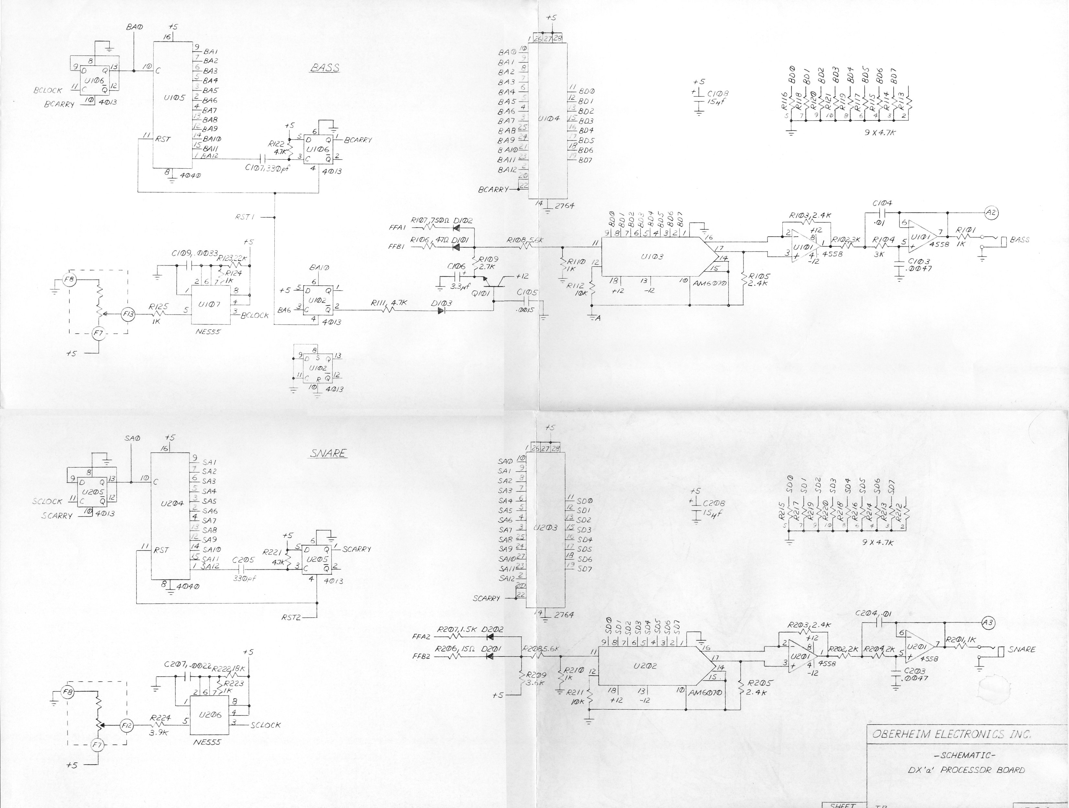
docs/reference/electrongate/dxa_p4.jpg
