sabrehagen/oberheim-dx-timeshift/docs/reference/electrongate/dxa_p5.jpg

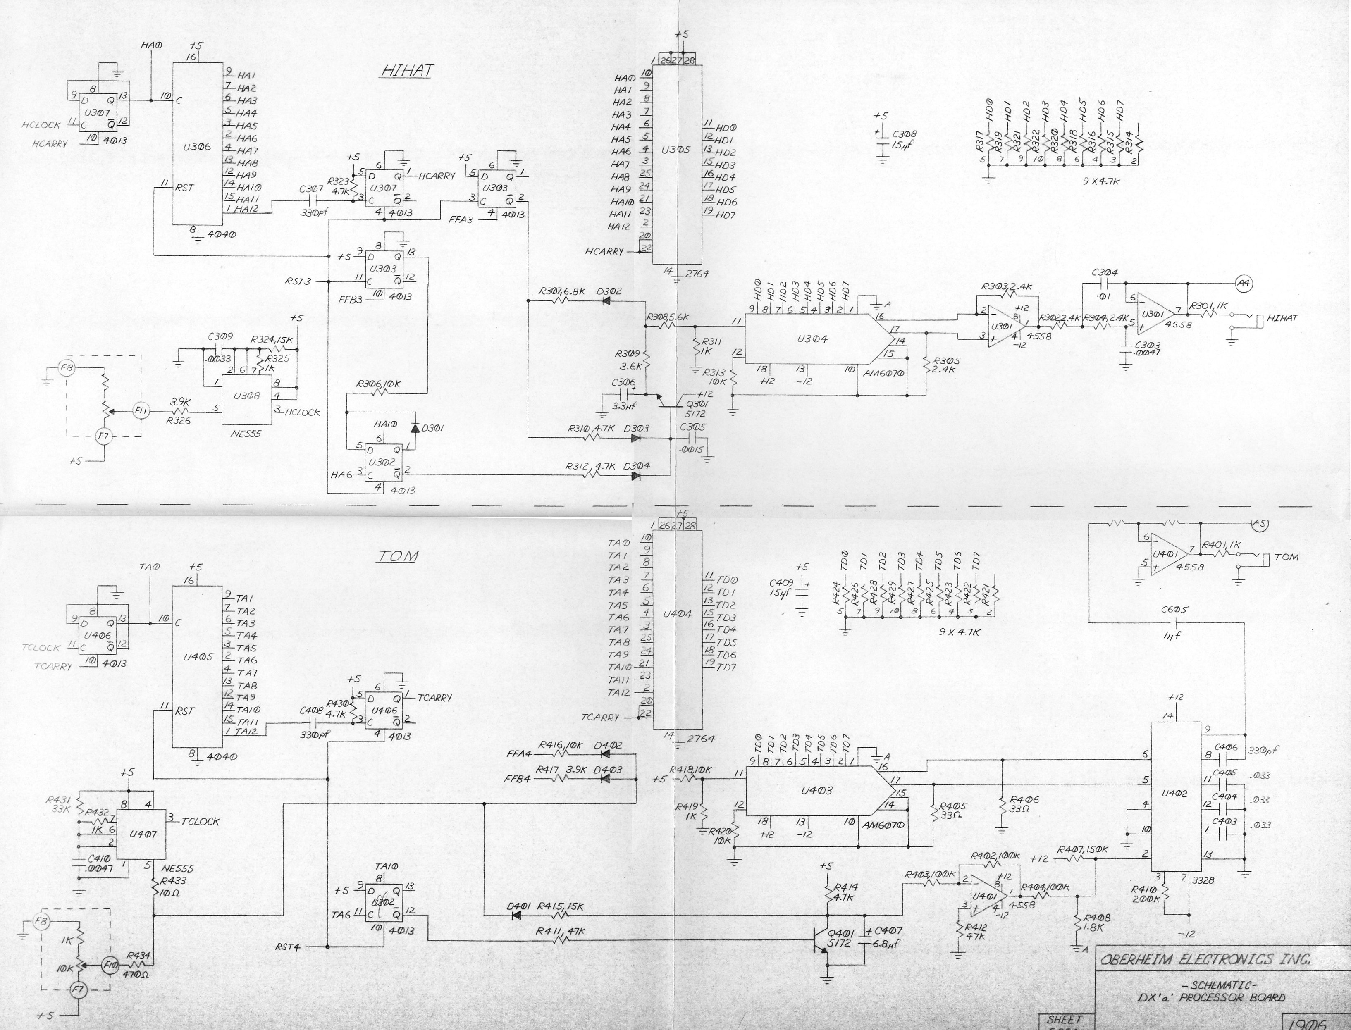
docs/reference/electrongate/dxa_p5.jpg
