sabrehagen/oberheim-dx-timeshift/docs/reference/electrongate/dxa_p6.jpg

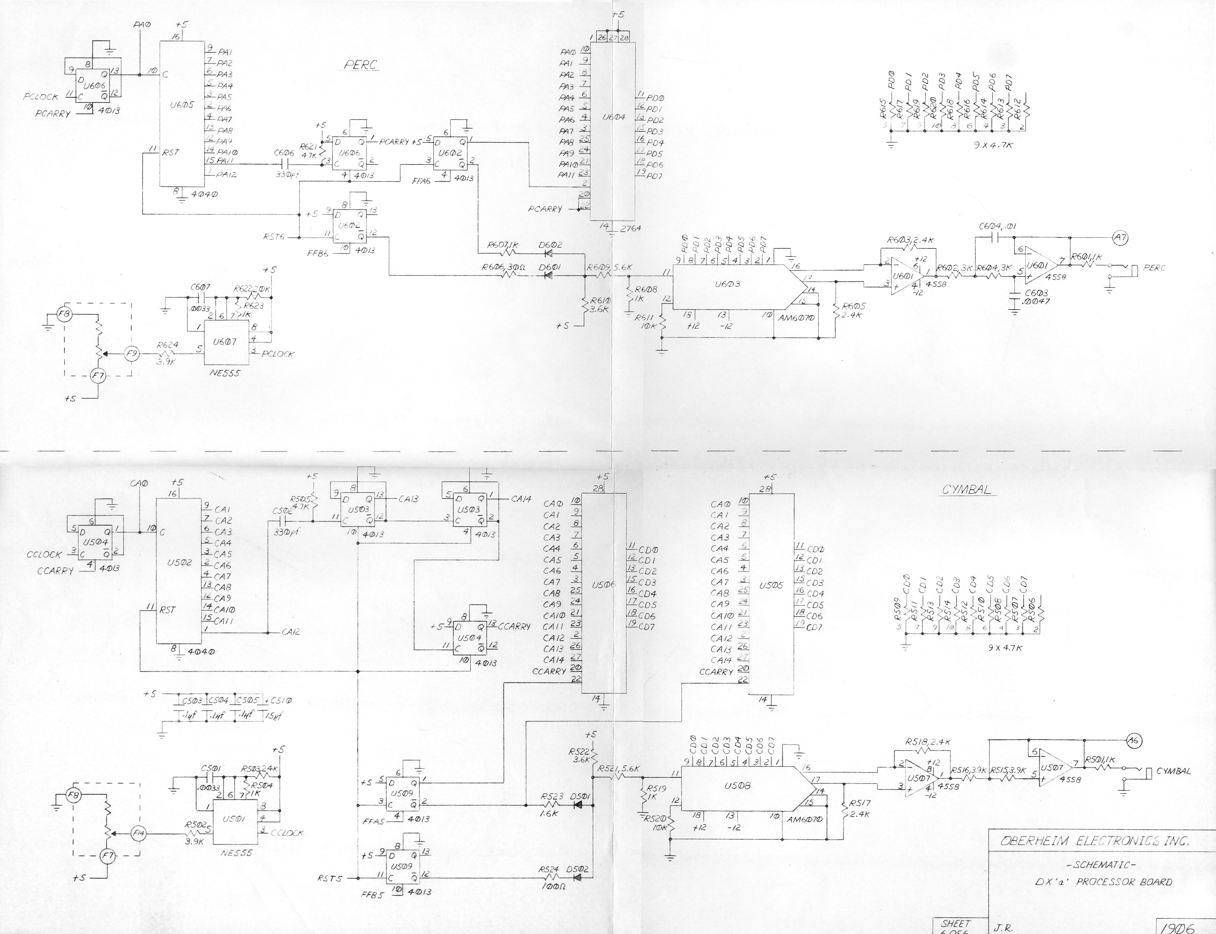
docs/reference/electrongate/dxa_p6.jpg
