sabrehagen/oberheim-dx-timeshift/docs/reference/electrongate/dxa_p7.jpg

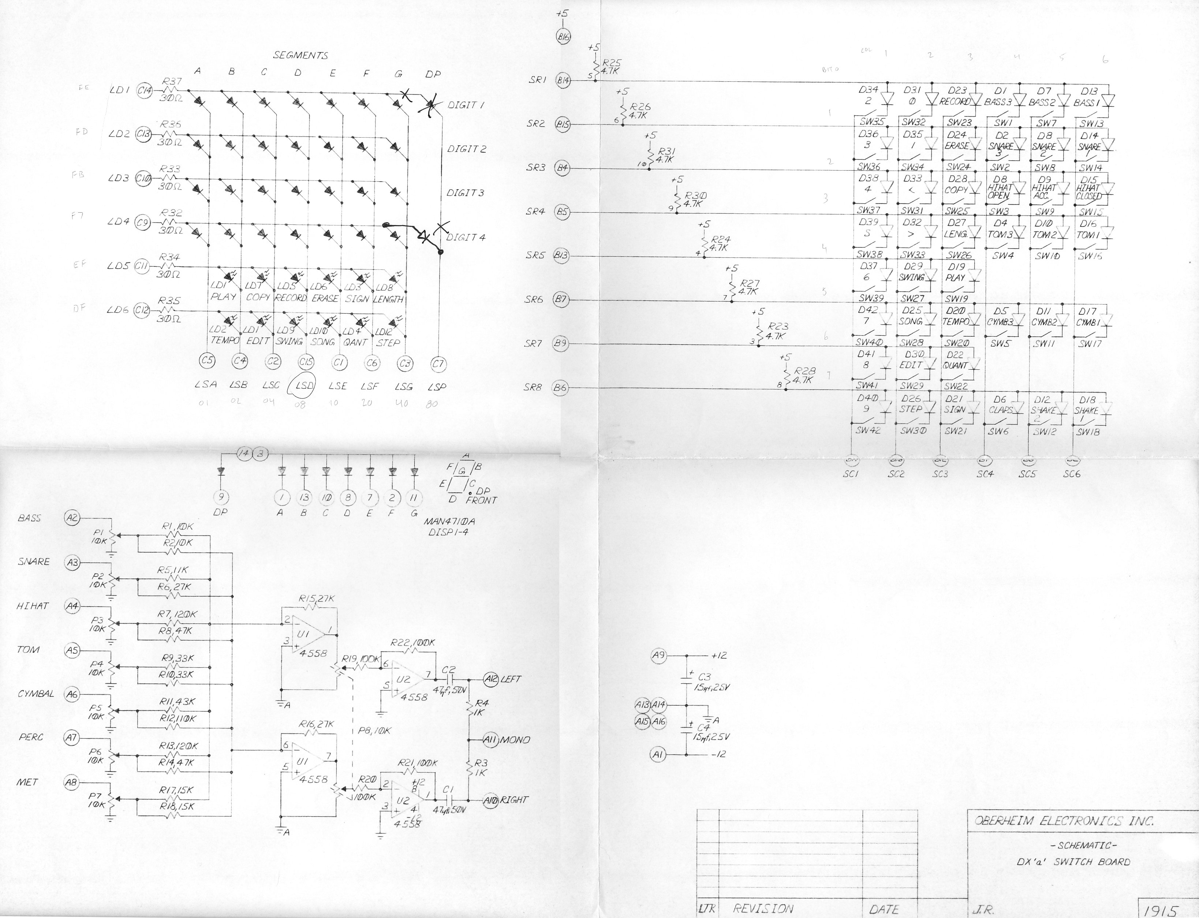
docs/reference/electrongate/dxa_p7.jpg
