sabrehagen/oberheim-dx-timeshift/docs/reference/electrongate/str1.jpg

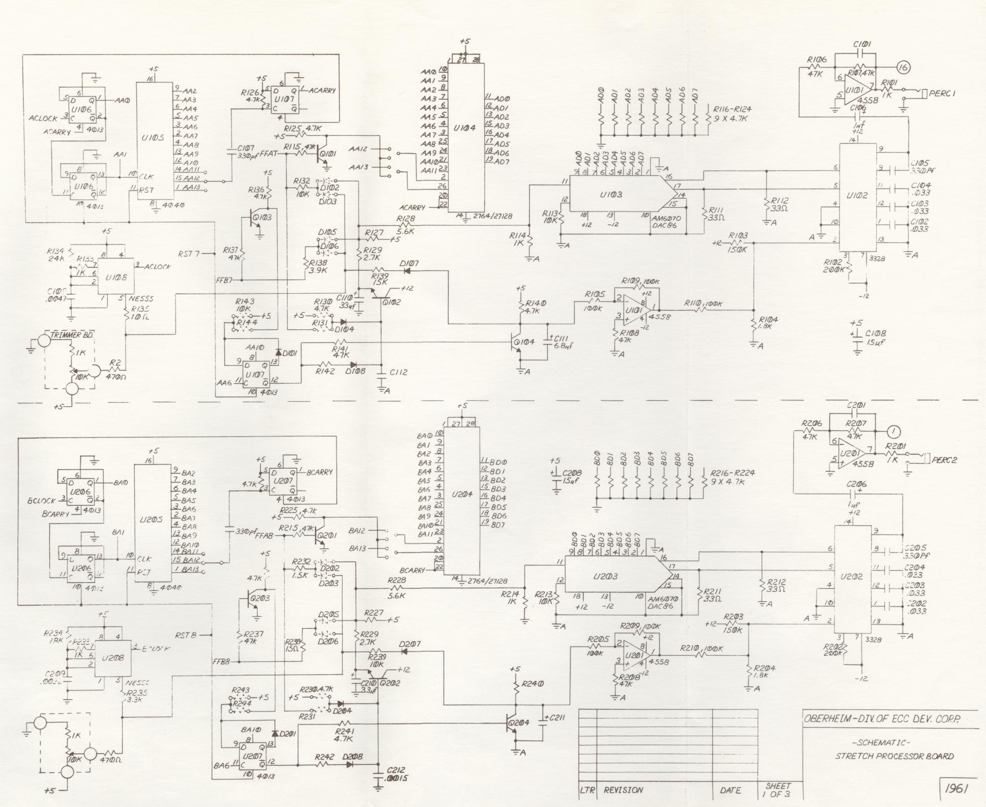
docs/reference/electrongate/str1.jpg
