sabrehagen/oberheim-dx-timeshift/docs/reference/electrongate/str2.jpg

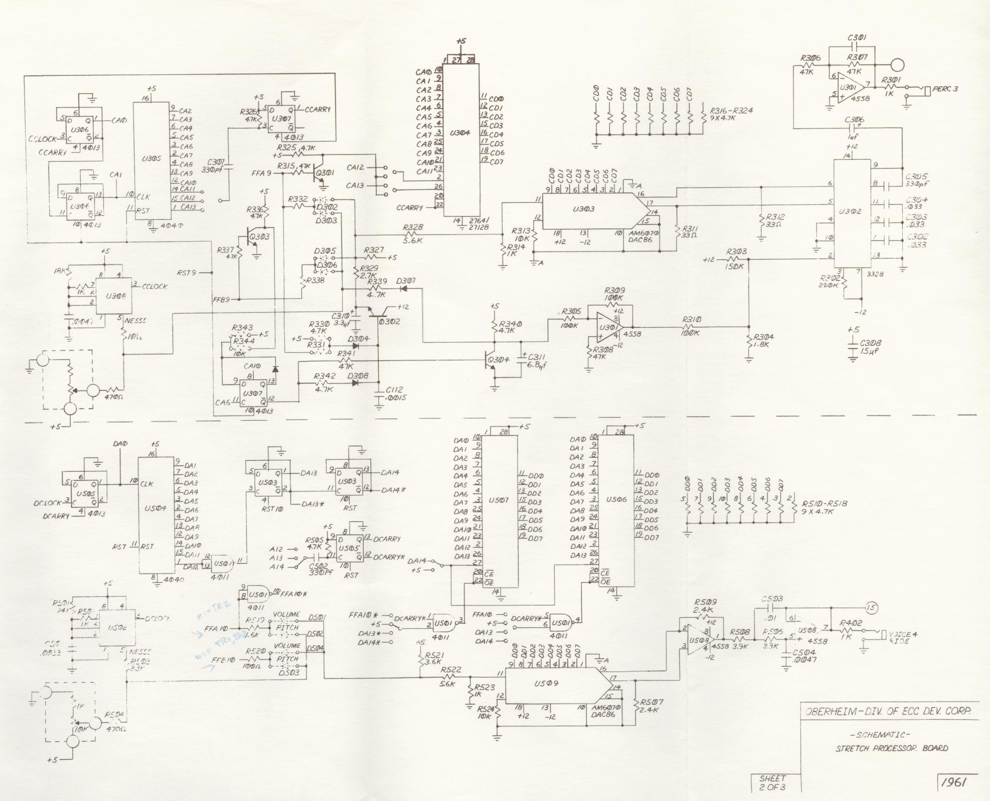
docs/reference/electrongate/str2.jpg
