sabrehagen/oberheim-dx-timeshift/docs/reference/electrongate/str3.jpg

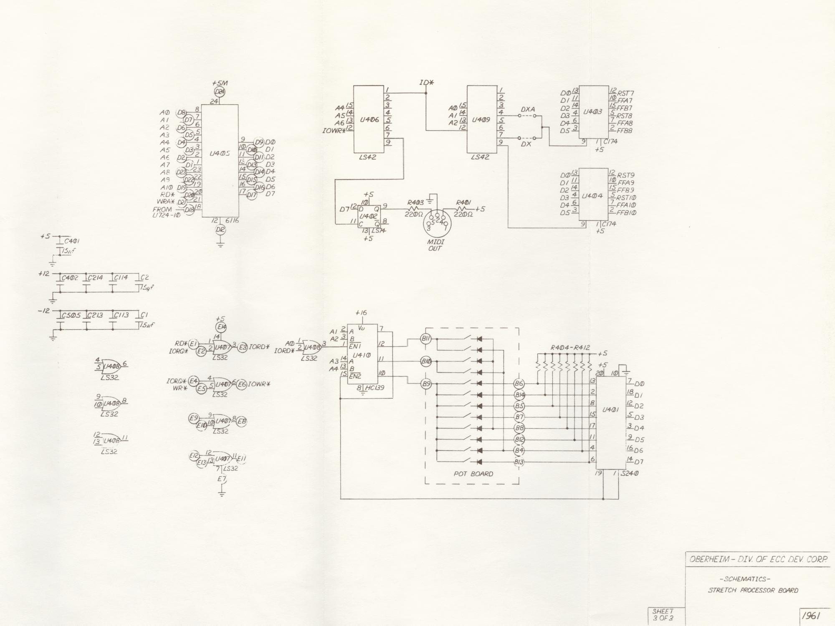
docs/reference/electrongate/str3.jpg
