sabrehagen/oberheim-dx-timeshift/docs/reference/electrongate/strparts.jpg

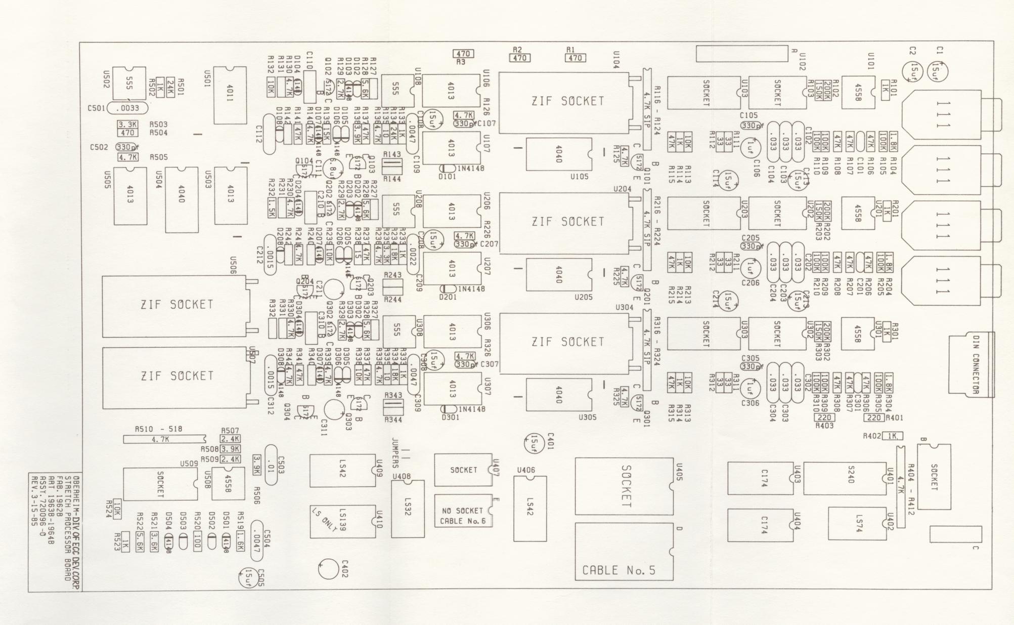
docs/reference/electrongate/strparts.jpg
