sabrehagen/oberheim-dx-timeshift/docs/reference/photos/electrongate_dx_back_1a.jpg

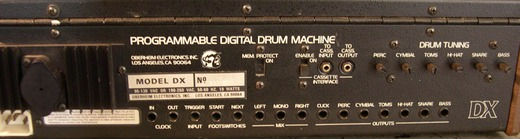
docs/reference/photos/electrongate_dx_back_1a.jpg
