sabrehagen/oberheim-dx-timeshift/docs/reference/photos/electrongate_dx_eprom_removal_1.jpg

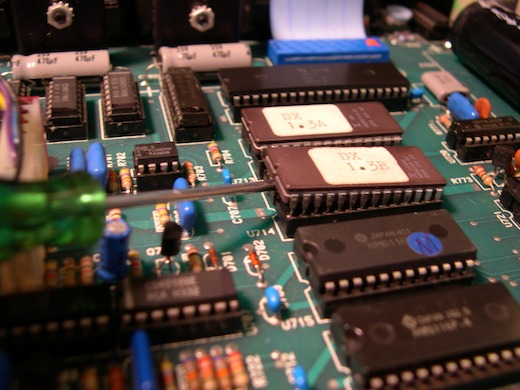
docs/reference/photos/electrongate_dx_eprom_removal_1.jpg
