sabrehagen/oberheim-dx-timeshift/docs/reference/photos/electrongate_dx_eprom_removal_2.jpg

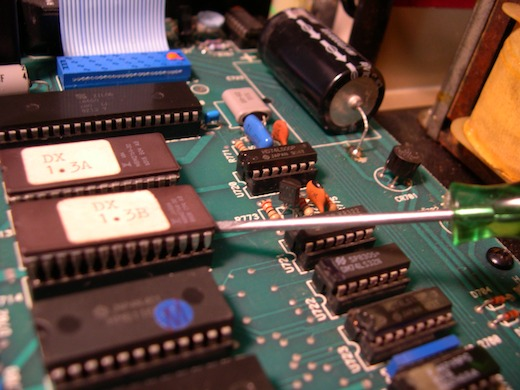
docs/reference/photos/electrongate_dx_eprom_removal_2.jpg
