sabrehagen/oberheim-dx-timeshift/docs/reference/photos/electrongate_dx_front_1a.jpg

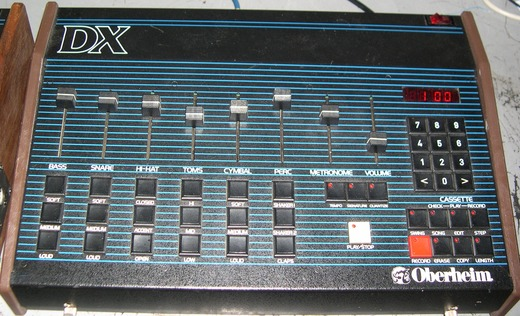
docs/reference/photos/electrongate_dx_front_1a.jpg
