sabrehagen/oberheim-dx-timeshift/docs/reference/photos/electrongate_dx_midi_board.jpg

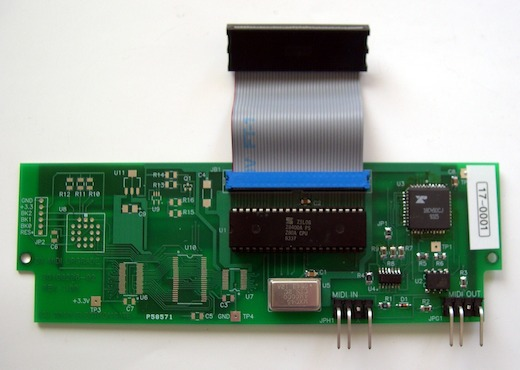
docs/reference/photos/electrongate_dx_midi_board.jpg
