sabrehagen/oberheim-dx-timeshift/docs/reference/photos/electrongate_dx_new_eproms_in.jpg

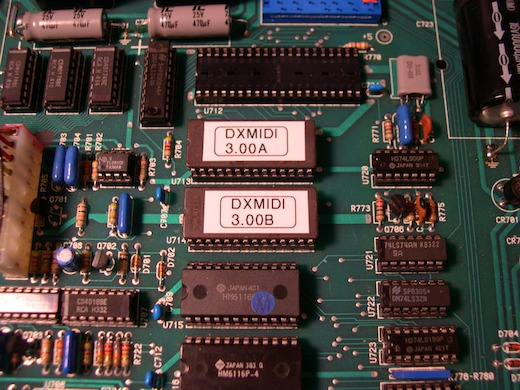
docs/reference/photos/electrongate_dx_new_eproms_in.jpg
