sabrehagen/oberheim-dx-timeshift/docs/reference/photos/electrongate_dx_new_standoffs_1.jpg

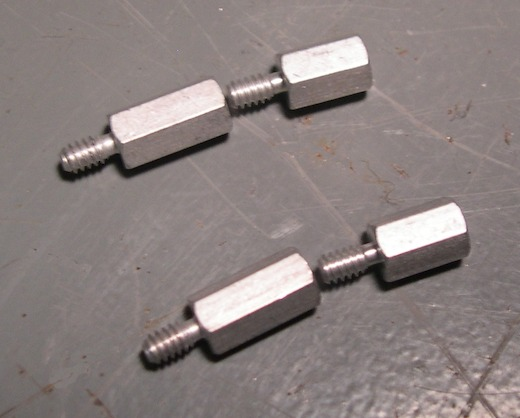
docs/reference/photos/electrongate_dx_new_standoffs_1.jpg
