sabrehagen/oberheim-dx-timeshift/docs/reference/photos/electrongate_dx_screws_to_remove.jpg

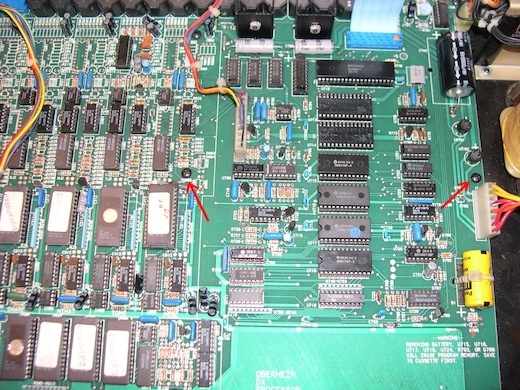
docs/reference/photos/electrongate_dx_screws_to_remove.jpg
