sabrehagen/oberheim-dx-timeshift/docs/reference/photos/electrongate_dx_z80_eproms_out.jpg

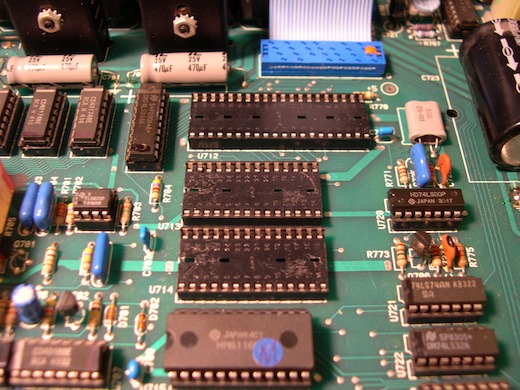
docs/reference/photos/electrongate_dx_z80_eproms_out.jpg
