sabrehagen/oberheim-dx-timeshift/docs/reference/photos/electrongate_dxa_bass_mod.jpg

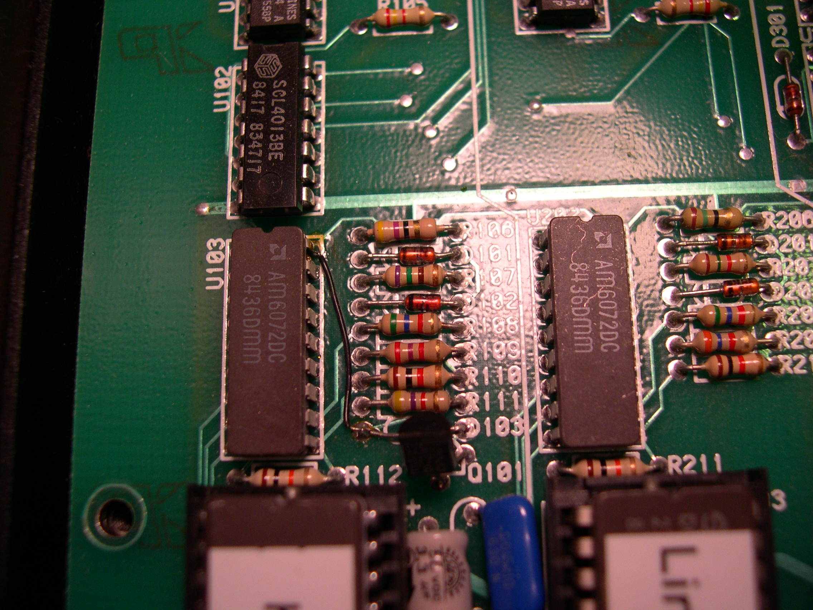
docs/reference/photos/electrongate_dxa_bass_mod.jpg
