sabrehagen/oberheim-dx-timeshift/docs/reference/photos/electrongate_DXX2_in_place_sm.jpg

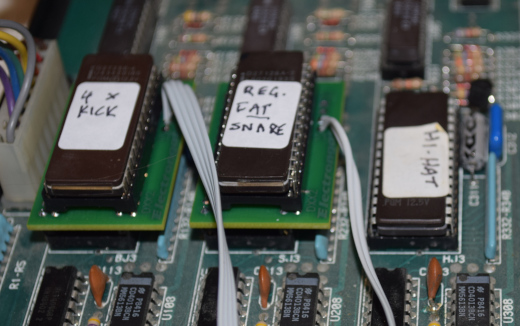
docs/reference/photos/electrongate_DXX2_in_place_sm.jpg
