sabrehagen/oberheim-dx-timeshift/docs/reference/photos/electrongate_stretch_audio_cable_overview.jpg

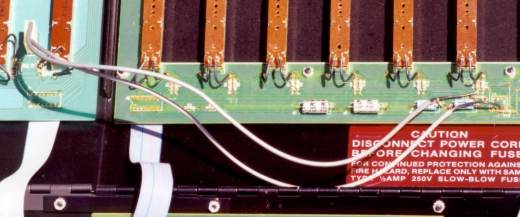
docs/reference/photos/electrongate_stretch_audio_cable_overview.jpg
