sabrehagen/oberheim-dx-timeshift/docs/reference/photos/electrongate_stretch_inside_overview.jpg

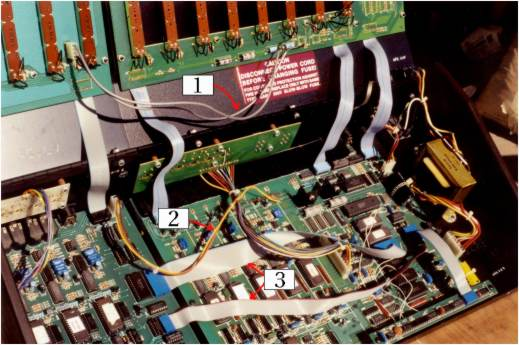
docs/reference/photos/electrongate_stretch_inside_overview.jpg
