sabrehagen/oberheim-dx-timeshift/docs/reference/photos/electrongate_stretch_power_cable_detail.jpg

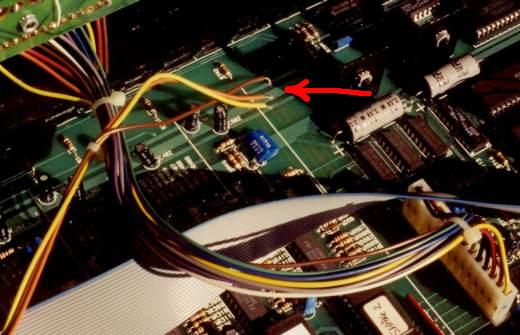
docs/reference/photos/electrongate_stretch_power_cable_detail.jpg
