sabrehagen/oberheim-dx-timeshift/docs/reference/photos/electrongate_stretch_power_cable_overview.jpg

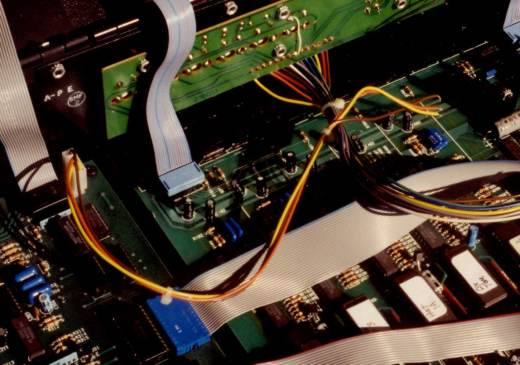
docs/reference/photos/electrongate_stretch_power_cable_overview.jpg
