sabrehagen/oberheim-dx-timeshift/docs/reference/photos/electrongate_stretch_ribbon1.jpg

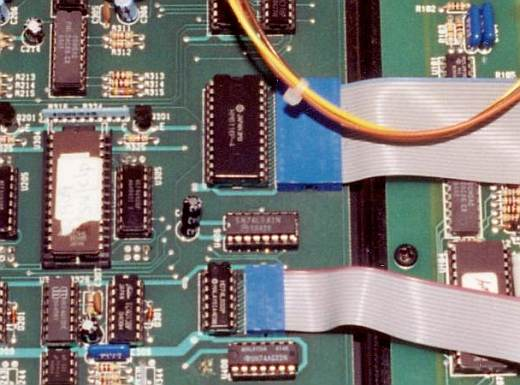
docs/reference/photos/electrongate_stretch_ribbon1.jpg
