sabrehagen/oberheim-dx-timeshift/docs/reference/photos/electrongate_stretch_ribbon2.jpg

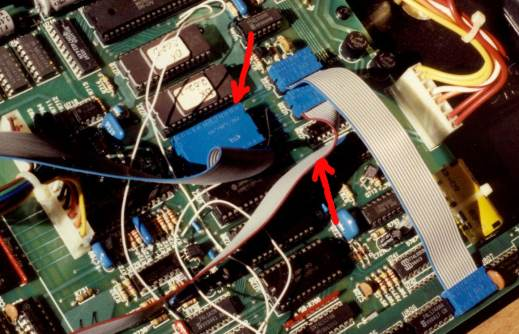
docs/reference/photos/electrongate_stretch_ribbon2.jpg
