sabrehagen/oberheim-dx-timeshift/docs/reference/photos/electrongate_stretch_stretch_cover_closed.jpg

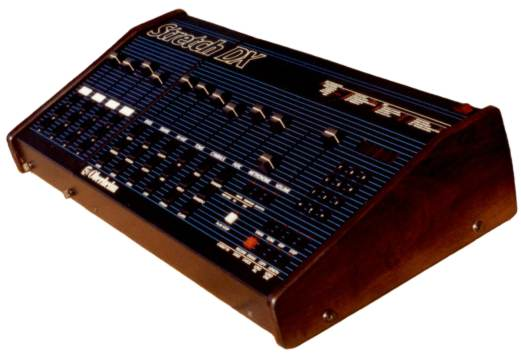
docs/reference/photos/electrongate_stretch_stretch_cover_closed.jpg
