sabrehagen/oberheim-dx-timeshift/docs/reference/photos/wikimedia_Oberheim_Stretch_DX.jpg

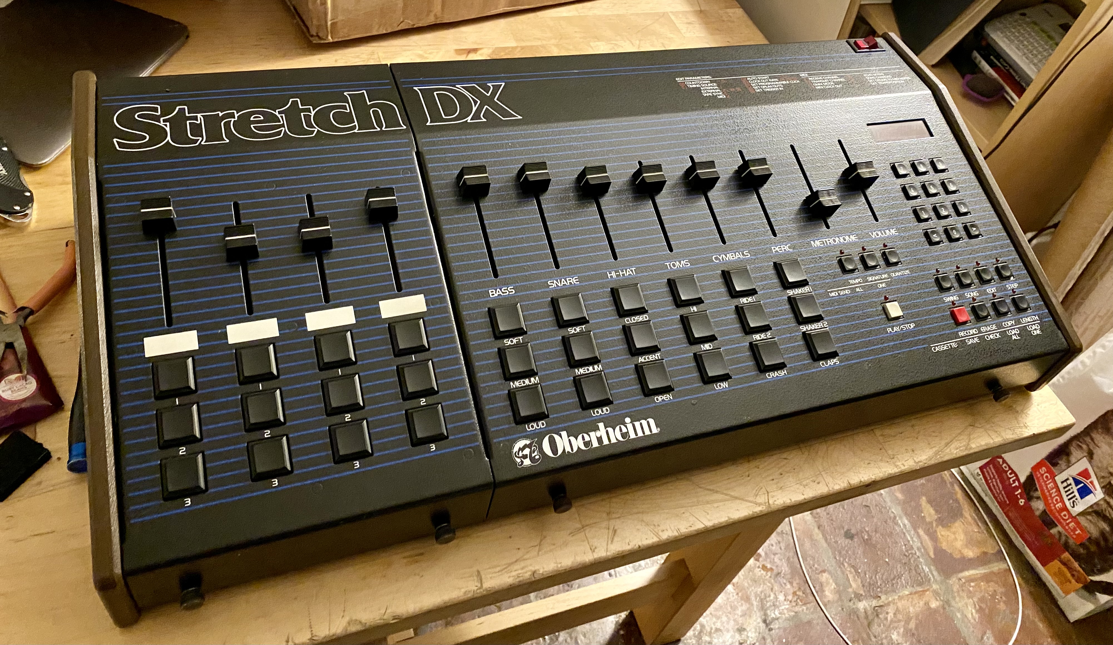
docs/reference/photos/wikimedia_Oberheim_Stretch_DX.jpg
