sabrehagen/oberheim-dx-timeshift/hardware/renders/bottom.png

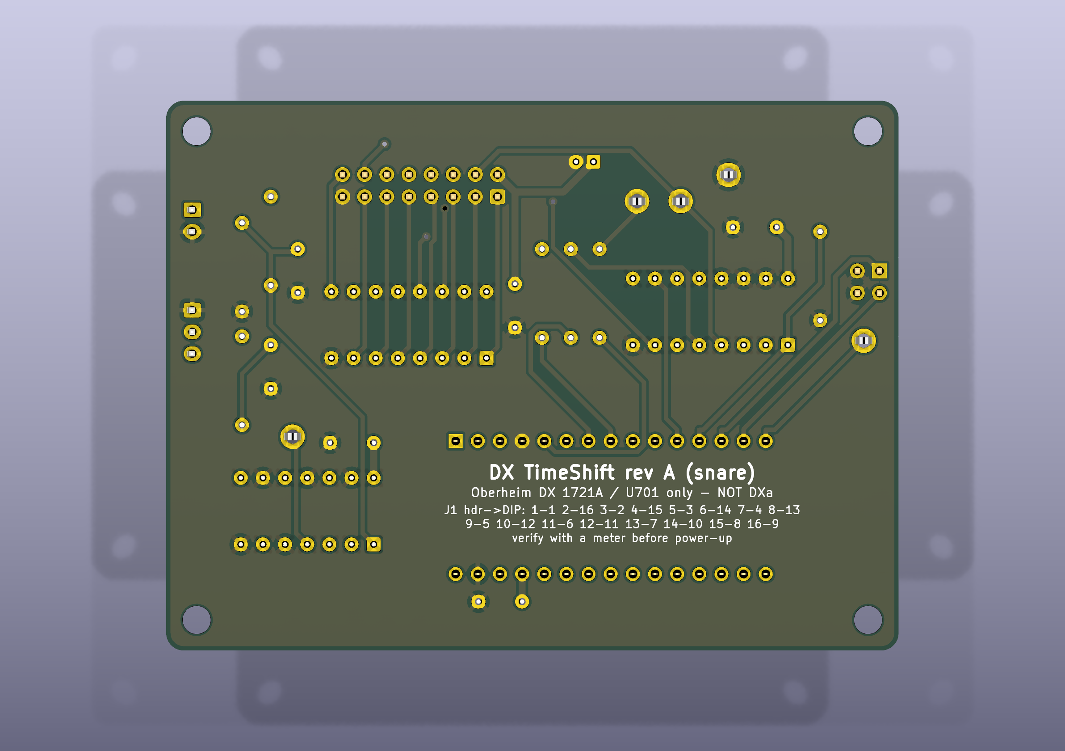
hardware/renders/bottom.png
