sabrehagen/oberheim-dx-timeshift/hardware/renders/perspective-2.png

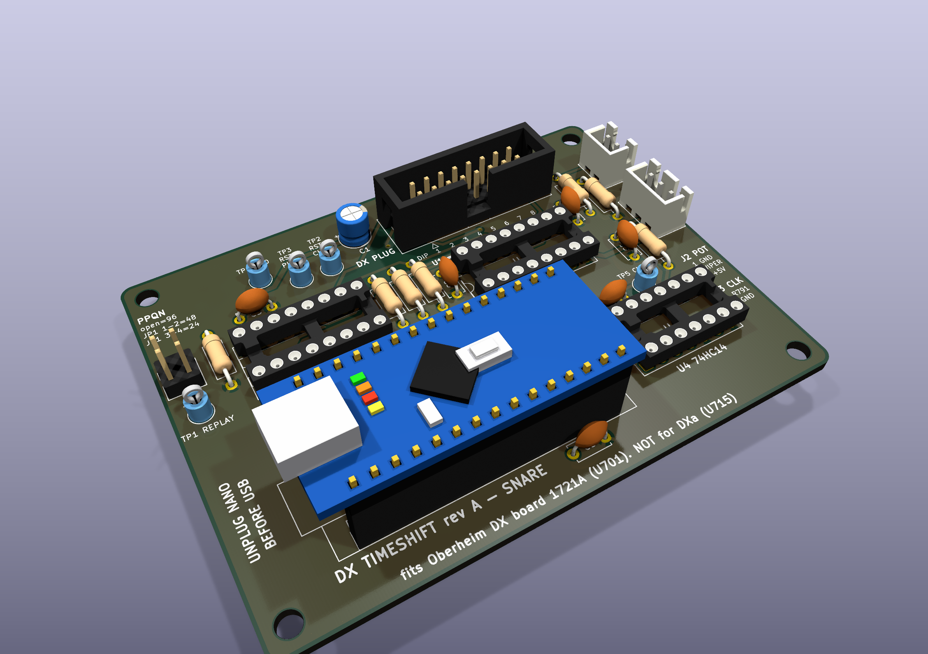
hardware/renders/perspective-2.png
