sabrehagen/oberheim-dx-timeshift/hardware/renders/top-bare-board.png

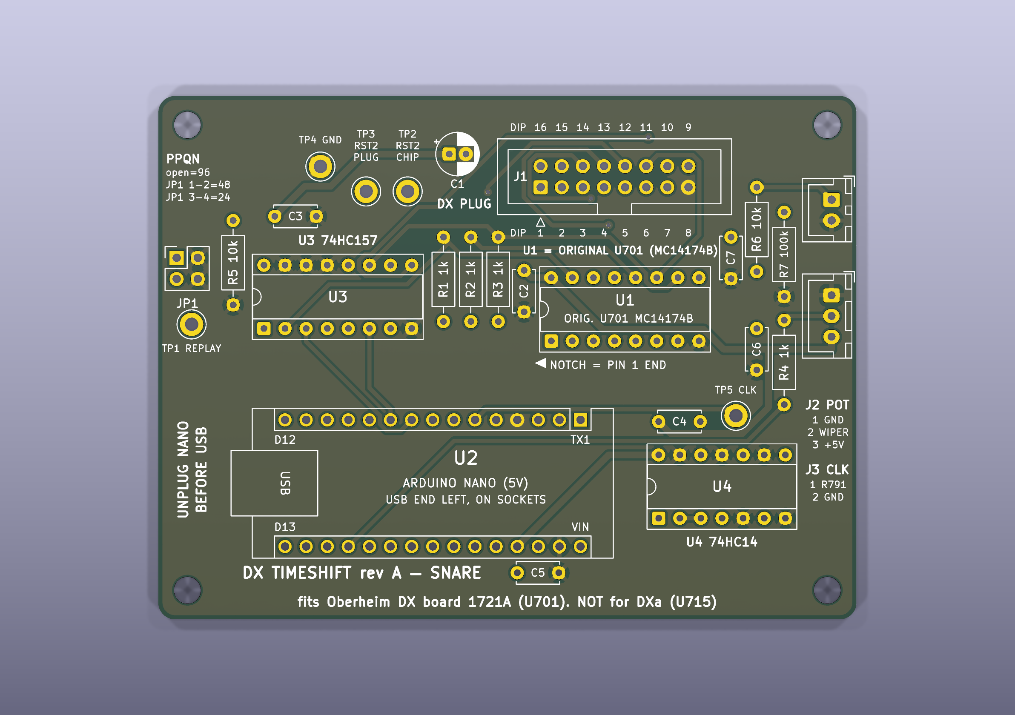
hardware/renders/top-bare-board.png
