sabrehagen/oberheim-dx-timeshift/webapp/screenshots/01-welcome.png

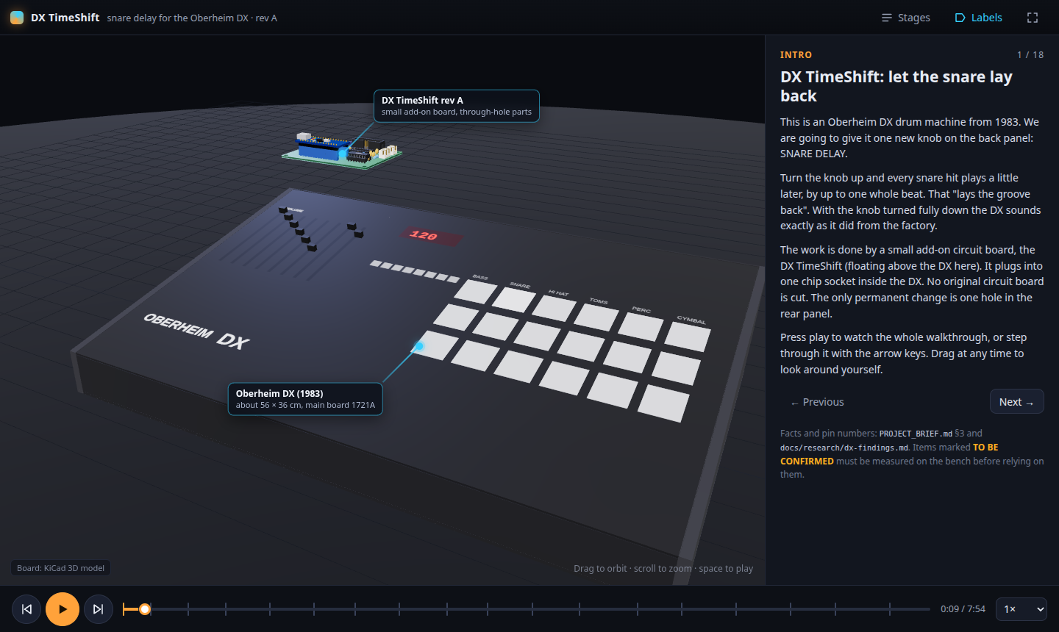
webapp/screenshots/01-welcome.png
