sabrehagen/oberheim-dx-timeshift/webapp/screenshots/02-beat.png

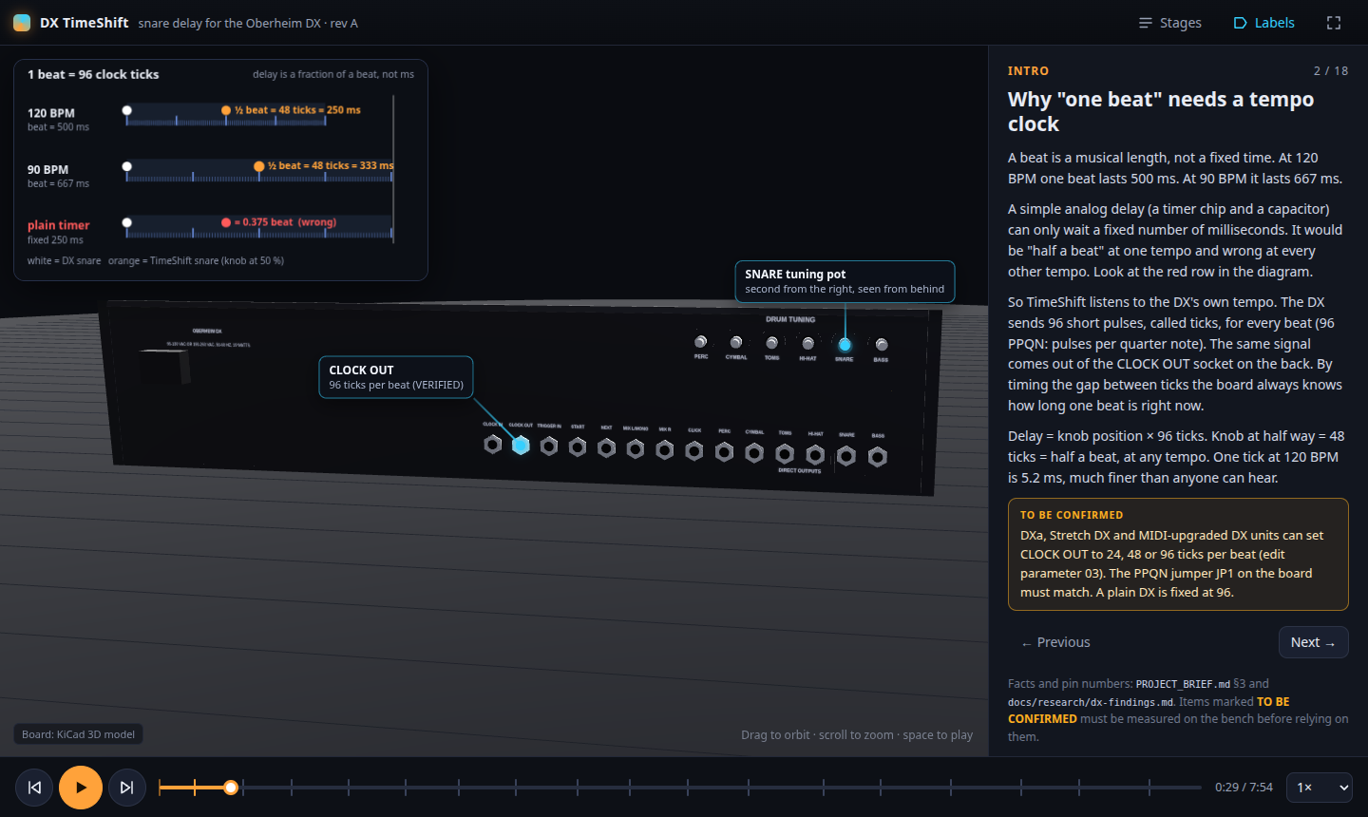
webapp/screenshots/02-beat.png
