sabrehagen/oberheim-dx-timeshift/webapp/screenshots/04-trigger.png

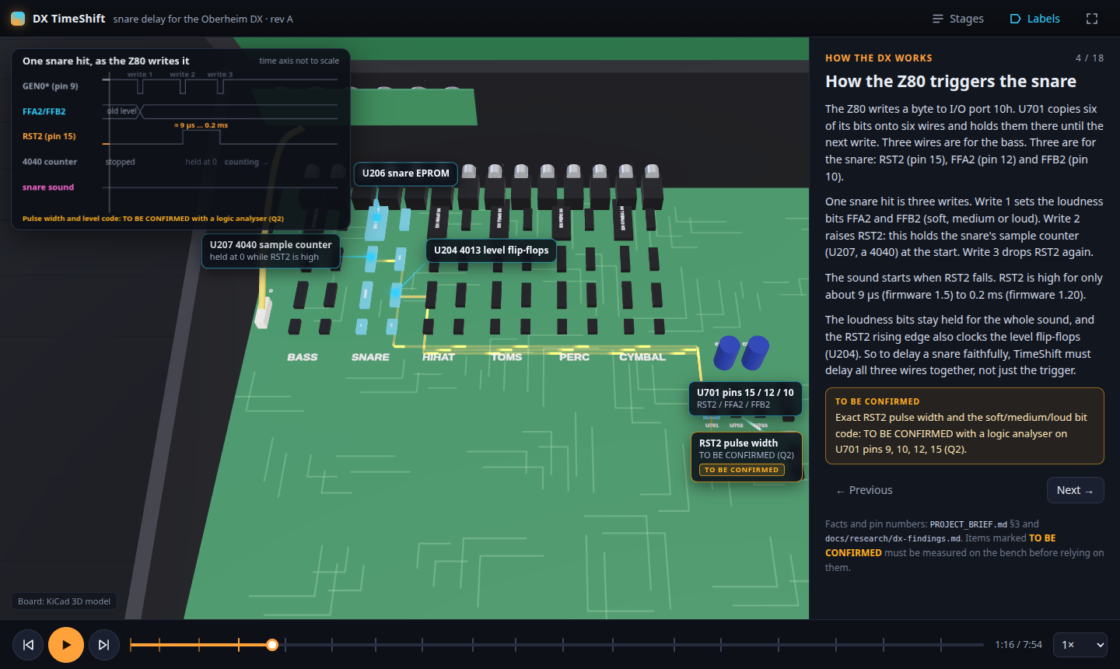
webapp/screenshots/04-trigger.png
