sabrehagen/oberheim-dx-timeshift/webapp/screenshots/06-capture.png

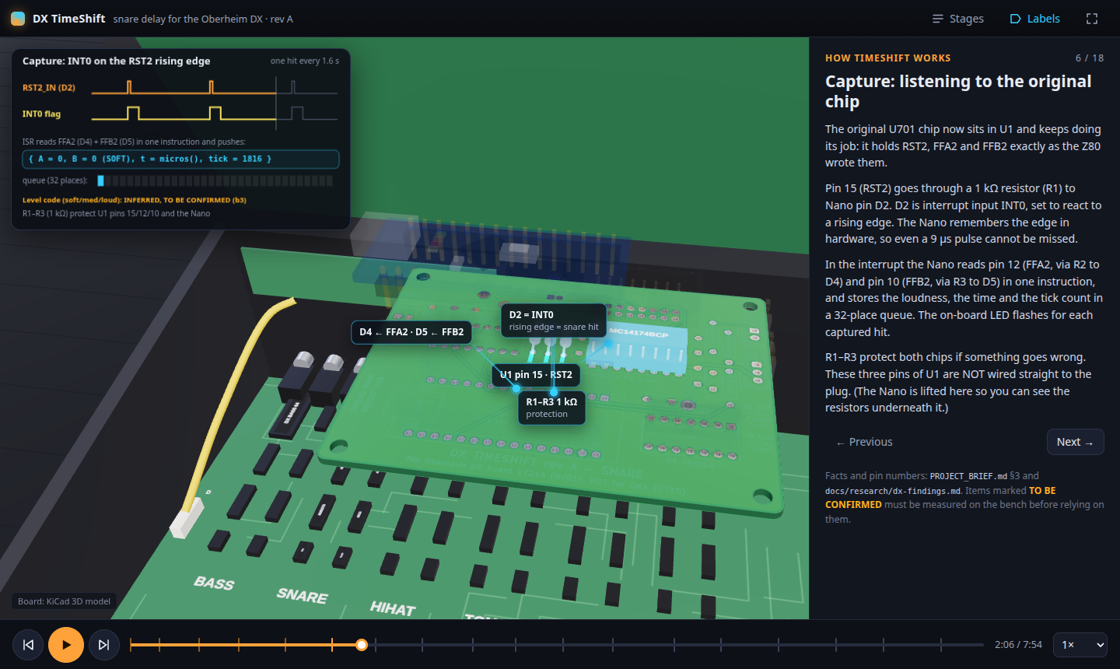
webapp/screenshots/06-capture.png
