sabrehagen/oberheim-dx-timeshift/webapp/screenshots/07-mux.png

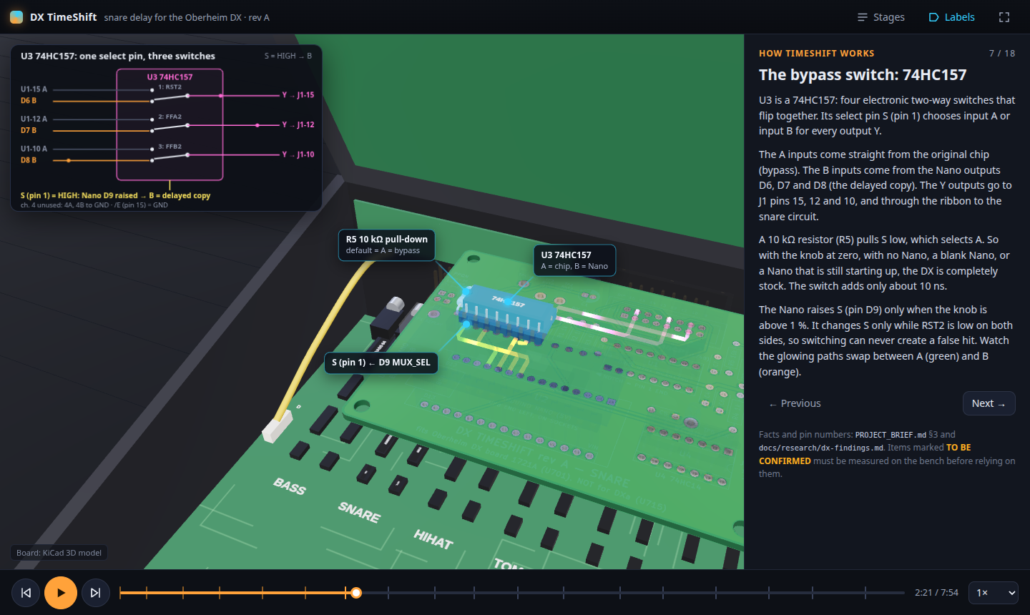
webapp/screenshots/07-mux.png
