sabrehagen/oberheim-dx-timeshift/webapp/screenshots/08-clock.png

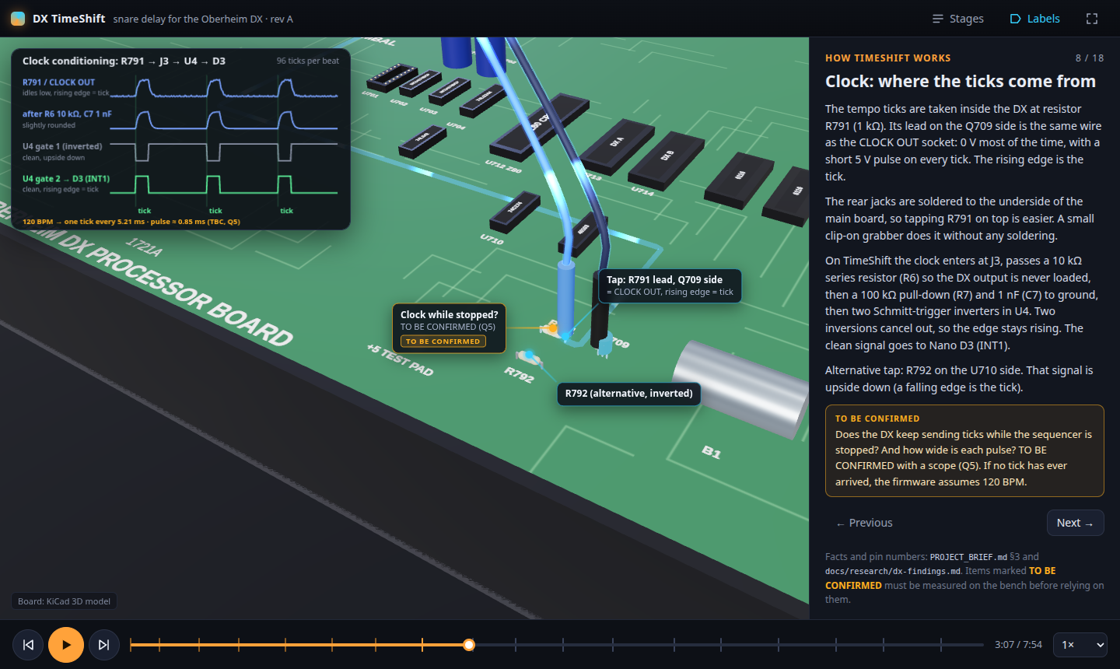
webapp/screenshots/08-clock.png
