sabrehagen/oberheim-dx-timeshift/webapp/screenshots/10-power.png

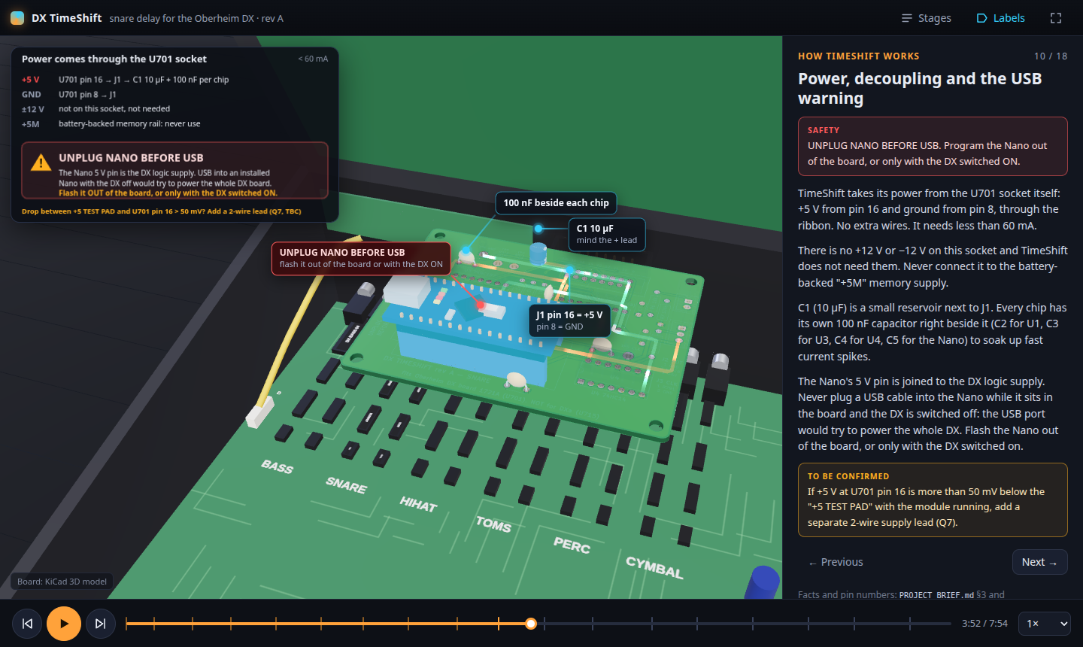
webapp/screenshots/10-power.png
