sabrehagen/oberheim-dx-timeshift/webapp/screenshots/11-replay.png

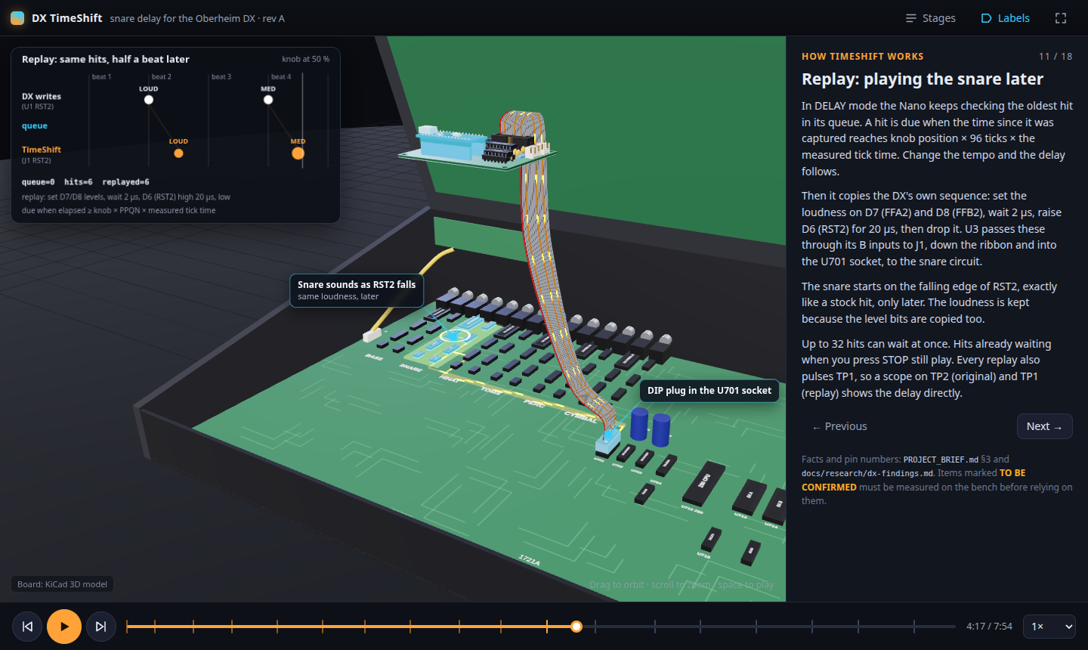
webapp/screenshots/11-replay.png
