sabrehagen/oberheim-dx-timeshift/webapp/screenshots/18-done.png

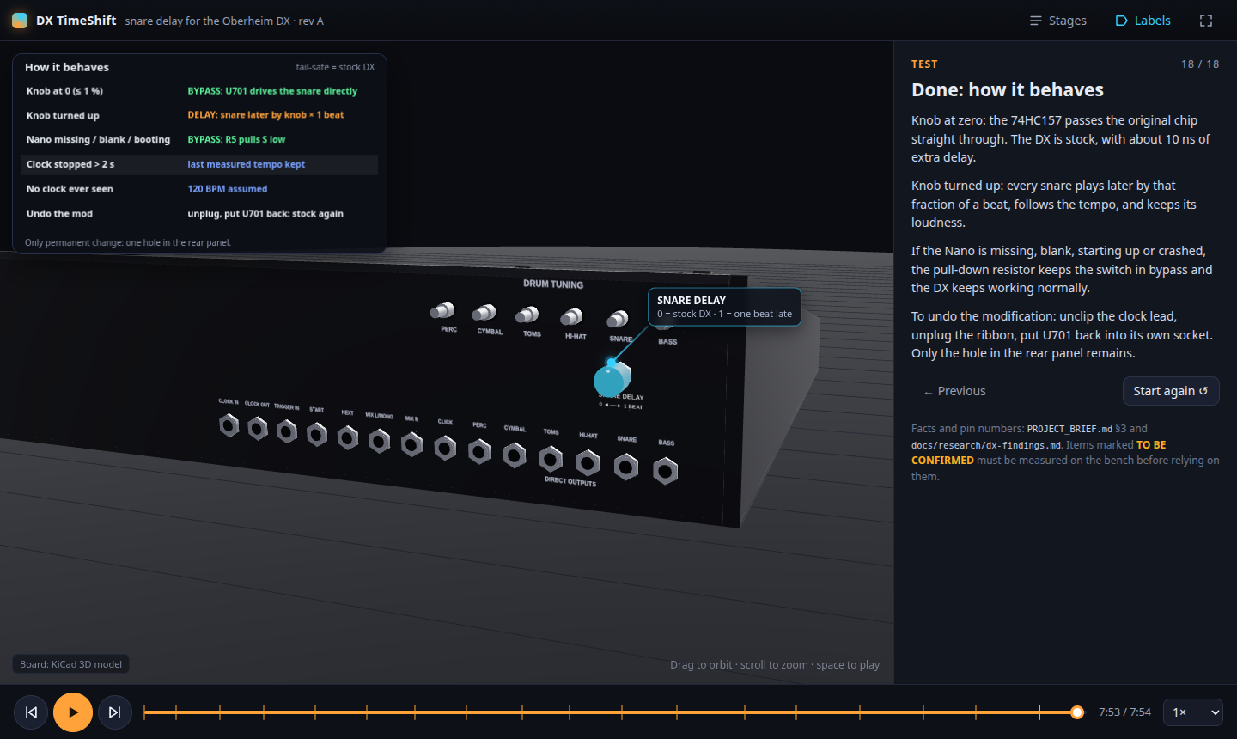
webapp/screenshots/18-done.png
