sabrehagen/oberheim-dx-timeshift/webapp/screenshots/m-05-overview.png

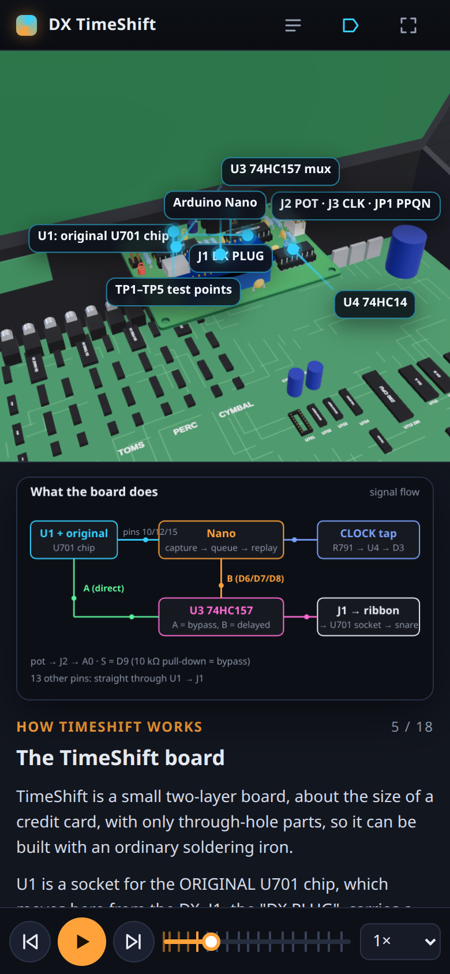
webapp/screenshots/m-05-overview.png
