sabrehagen/oberheim-dx-timeshift/webapp/screenshots/m-11-replay.png

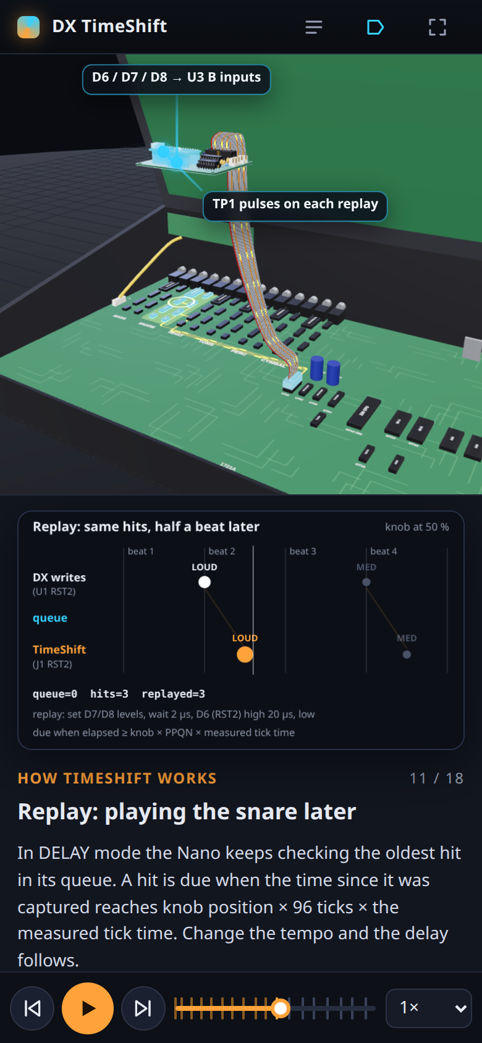
webapp/screenshots/m-11-replay.png
