sabrehagen/oberheim-dx-timeshift/webapp/screenshots/v1-00-dx-hero.png

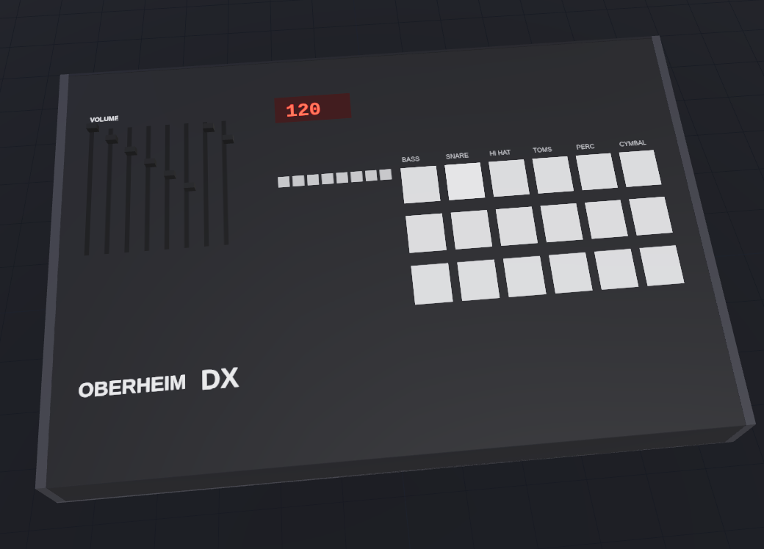
webapp/screenshots/v1-00-dx-hero.png
