sabrehagen/oberheim-dx-timeshift/webapp/screenshots/v1-03-inside.png

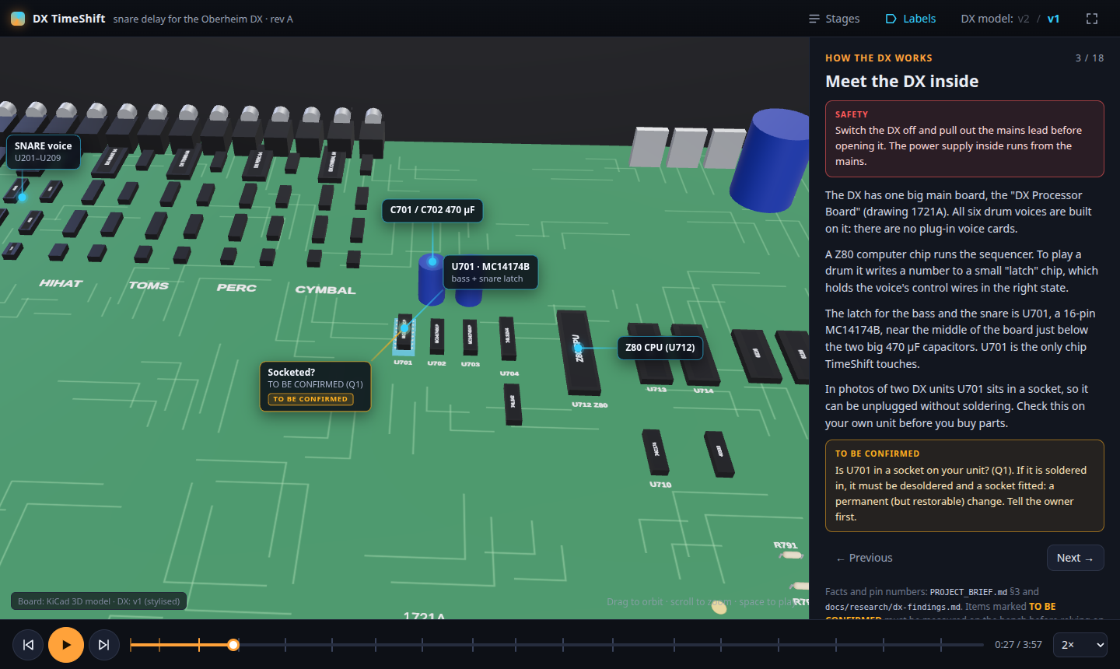
webapp/screenshots/v1-03-inside.png
