sabrehagen/oberheim-dx-timeshift/webapp/screenshots/v2-01-welcome.png

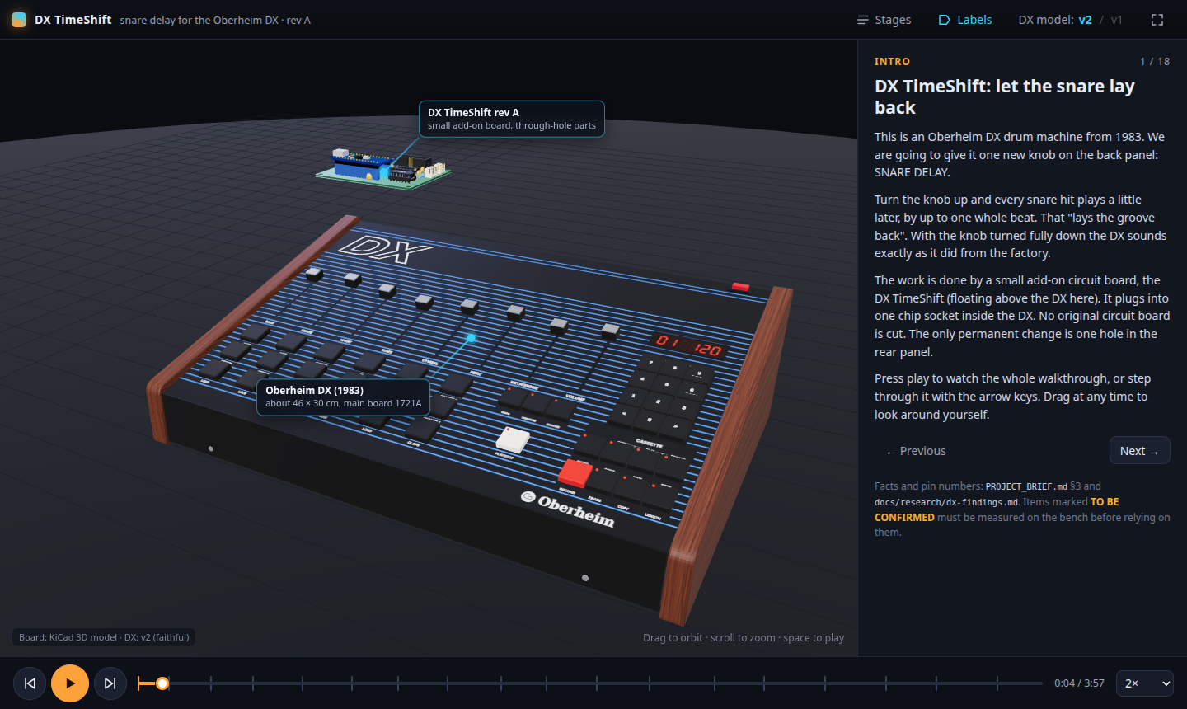
webapp/screenshots/v2-01-welcome.png
