sabrehagen/oberheim-dx-timeshift/webapp/screenshots/v2-02-beat.png

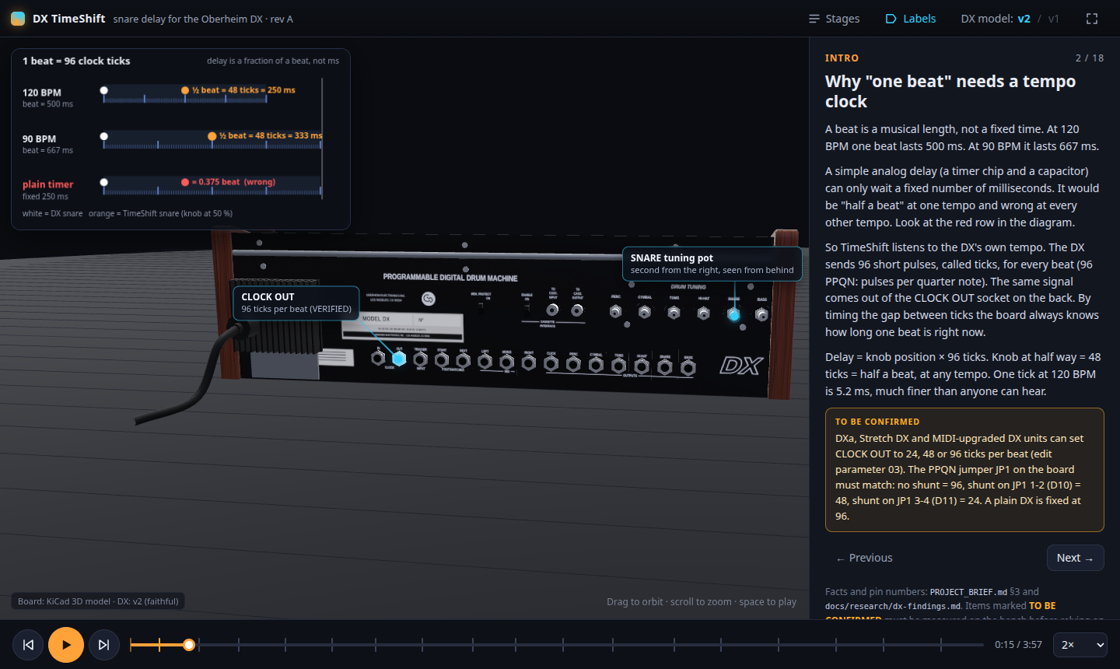
webapp/screenshots/v2-02-beat.png
