sabrehagen/oberheim-dx-timeshift/webapp/screenshots/v2-03-inside.png

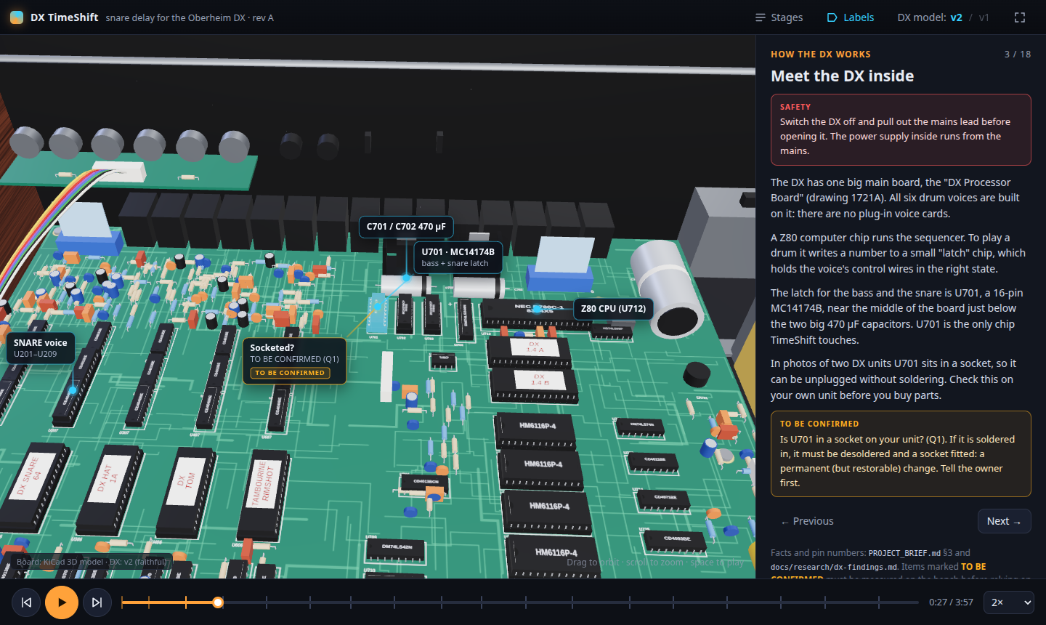
webapp/screenshots/v2-03-inside.png
