sabrehagen/oberheim-dx-timeshift/webapp/screenshots/v2-04-trigger.png

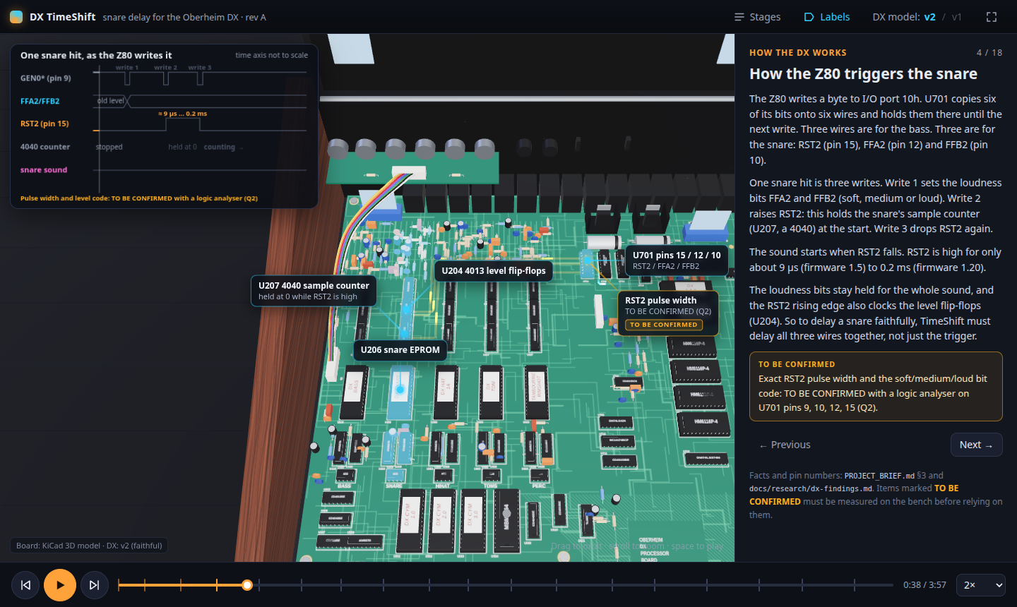
webapp/screenshots/v2-04-trigger.png
