sabrehagen/oberheim-dx-timeshift/webapp/screenshots/v2-05-overview.png

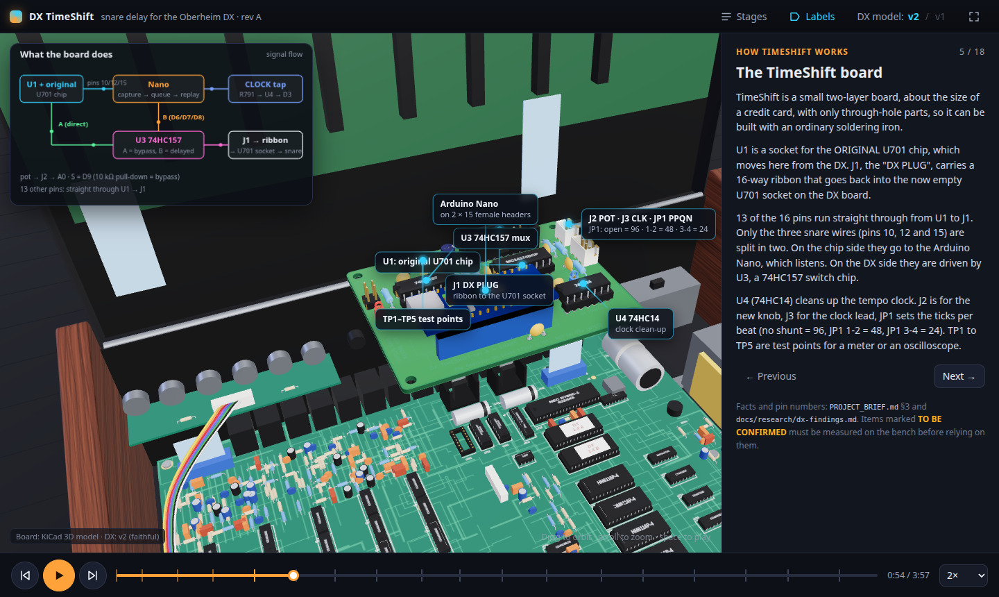
webapp/screenshots/v2-05-overview.png
