sabrehagen/oberheim-dx-timeshift/docs/bom.csv

section | ref_des | qty | description | manufacturer | mpn | mouser_pn | mouser_status | digikey_pn | digikey_status | unit_price_usd_est | ext_price_usd_est | link | notes | in_total
A. TimeShift board | U2 | 1 | Arduino Nano v3, ATmega328P, 5 V / 16 MHz, Mini-B USB | Arduino | A000005 | 782-A000005 | VERIFIED (aggregator) | 1050-1001-ND | VERIFIED | 25.70 | 25.70 | https://www.digikey.com/en/products/detail/arduino/A000005/2638989 | A 5 V / 16 MHz ATmega328P Nano clone (about $5) works the same. Fitted in 2 x 1x15 female headers. | yes
A. TimeShift board | U3 | 1 | 74HC157 quad 2:1 multiplexer, DIP-16 | Texas Instruments | SN74HC157N | 595-SN74HC157N | VERIFIED (aggregator) | 296-1578-5-ND | VERIFIED | 1.54 | 1.54 | https://www.digikey.com/en/products/detail/texas-instruments/SN74HC157N/277224 |  | yes
A. TimeShift board | U4 | 1 | 74HC14 hex Schmitt-trigger inverter, DIP-14 | Texas Instruments | SN74HC14N | 595-SN74HC14N | VERIFIED (aggregator) | 296-1577-5-ND | VERIFIED | 1.15 | 1.15 | https://www.digikey.com/en/products/detail/texas-instruments/SN74HC14N/277223 |  | yes
A. TimeShift board | U1 (socket), U3 (socket) | 2 | IC socket DIP-16, 7.62 mm, through-hole | TE Connectivity | 1-2199298-4 | 571-1-2199298-4 | UNVERIFIED | A120349-ND | VERIFIED | 0.30 | 0.60 | https://www.digikey.com/en/products/detail/te-connectivity-amp-connectors/1-2199298-4/5022041 | U1 receives the ORIGINAL U701 chip (MC14174B) from the DX: no new chip is bought for U1. | yes
A. TimeShift board | U4 (socket) | 1 | IC socket DIP-14, 7.62 mm, through-hole | TE Connectivity | 1-2199298-3 | 571-1-2199298-3 | VERIFIED (aggregator) | A120348-ND | VERIFIED | 0.28 | 0.28 | https://www.digikey.com/en/products/detail/te-connectivity-amp-connectors/1-2199298-3/5022040 |  | yes
A. TimeShift board | U2 (sockets) | 2 | Female header 1x15, 2.54 mm, through-hole (Nano socket) | Sullins Connector Solutions | PPTC151LFBN-RC | 200-SSW11501TS | UNVERIFIED | S7013-ND | VERIFIED | 0.92 | 1.84 | https://www.digikey.com/en/products/detail/sullins-connector-solutions/PPTC151LFBN-RC/810153 | Mouser: Sullins part not found; the Mouser number is for the equivalent Samtec SSW-115-01-T-S (DK 612-SSW-115-01-T-S-ND). | yes
A. TimeShift board | J1 | 1 | Box header 2x8 (16 pin), 2.54 mm, shrouded, straight, through-hole | Wurth Elektronik | 61201621621 | 710-61201621621 | VERIFIED (aggregator) | 732-2095-ND | VERIFIED | 0.60 | 0.60 | https://www.digikey.com/en/products/result?keywords=61201621621 | Pin 1 marked on the PCB. Polarised: the IDC socket fits one way only. | yes
A. TimeShift board | J2 | 1 | JST XH header 3-pin, 2.50 mm, vertical | JST | B3B-XH-A(LF)(SN) | 306-B3B-XH-ALFSN | UNVERIFIED | 455-2248-ND | VERIFIED | 0.13 | 0.13 | https://www.digikey.com/en/products/result?keywords=B3B-XH-A | POT: 1 = GND, 2 = wiper, 3 = +5 V | yes
A. TimeShift board | J3 | 1 | JST XH header 2-pin, 2.50 mm, vertical | JST | B2B-XH-A(LF)(SN) | 306-B2B-XH-ALFSN | UNVERIFIED | 455-B2B-XH-A-ND | VERIFIED | 0.10 | 0.10 | https://www.digikey.com/en/products/detail/jst-sales-america-inc/B2B-XH-A/1651045 | CLK: 1 = clock tap, 2 = GND | yes
A. TimeShift board | JP1 | 1 | Pin header 2x2, 2.54 mm, vertical, gold | Samtec | TSW-102-07-G-D | 200-TSW10207GD | UNVERIFIED | 612-TSW-102-07-G-D-ND | VERIFIED | 0.38 | 0.38 | https://www.digikey.com/en/products/detail/samtec-inc/TSW-102-07-G-D/1101275 | PPQN select: no shunt = 96, shunt on JP1 1-2 = 48 (D10), shunt on JP1 3-4 = 24 (D11) | yes
A. TimeShift board | JP1 (shunt) | 1 | Jumper shunt 2.54 mm, closed top | Sullins Connector Solutions | QPC02SXGN-RC | 571-881545-2 | UNVERIFIED | S9337-ND | VERIFIED | 0.10 | 0.10 | https://www.digikey.com/en/products/detail/sullins-connector-solutions/QPC02SXGN-RC/2618262 | For 96 PPQN park it on one pin only (no pair bridged). Mouser: Sullins not found; number is for the equivalent TE 881545-2 (DK A26242-ND). | yes
A. TimeShift board | R1, R2, R3, R4 | 4 | Resistor 1 kOhm 1 % 1/4 W metal film, axial | YAGEO | MFR-25FBF52-1K | 603-MFR-25FBF52-1K | UNVERIFIED | 1.00KXBK-ND | VERIFIED | 0.10 | 0.40 | https://www.digikey.com/en/products/result?keywords=MFR-25FBF52-1K | R1-R3 protect Nano D2/D4/D5; R4 pot-wiper RC filter | yes
A. TimeShift board | R5, R6 | 2 | Resistor 10 kOhm 1 % 1/4 W metal film, axial | YAGEO | MFR-25FBF52-10K | 603-MFR-25FBF52-10K | VERIFIED (aggregator) | 10.0KXBK-ND | VERIFIED | 0.10 | 0.20 | https://www.digikey.com/en/products/detail/yageo/MFR-25FBF52-10K/13219 | R5 MUX_SEL pull-down (bypass), R6 clock series | yes
A. TimeShift board | R7 | 1 | Resistor 100 kOhm 1 % 1/4 W metal film, axial | YAGEO | MFR-25FBF52-100K | 603-MFR-25FBF52-100K | UNVERIFIED | 100KXBK-ND | VERIFIED | 0.10 | 0.10 | https://www.digikey.com/en/products/result?keywords=MFR-25FBF52-100K | Clock input pull-down | yes
A. TimeShift board | C2, C3, C4, C5, C6 | 5 | Capacitor 100 nF 50 V X7R ceramic, radial, 5.08 mm lead spacing | KEMET | C322C104K5R5TA | 80-C322C104K5R | VERIFIED (aggregator) | 399-4329-ND | VERIFIED | 1.49 | 7.45 | https://www.digikey.com/en/products/detail/kemet/C322C104K5R5TA/818105 | Decoupling U1/U3/U4/Nano + pot filter. Any 100 nF X7R with 5 mm spacing is fine (cheaper generics exist). | yes
A. TimeShift board | C7 | 1 | Capacitor 1 nF 100 V C0G ceramic, radial, 5.08 mm lead spacing | KEMET | C322C102J1G5TA |  | NOT FOUND | 399-4321-ND | VERIFIED | 0.73 | 0.73 | https://www.digikey.com/en/products/detail/kemet/C322C102J1G5TA/818097 | Clock RC filter. Mouser: search the MPN. | yes
A. TimeShift board | C1 | 1 | Capacitor 10 uF 35 V aluminium electrolytic, radial 5 mm dia, 2.0 mm lead spacing | Panasonic | EEA-GA1V100 | 667-EEA-GA1V100 | UNVERIFIED | P14494-ND | VERIFIED | 0.32 | 0.32 | https://www.digikey.com/en/products/detail/panasonic-industry/EEA-GA1V100/2504583 | Bulk cap at J1. Any 10 uF >= 16 V, 5 mm dia, 2.0 mm pitch. (ECA-1EM100 was out of stock at DK on 2026-11-06.) | yes
A. TimeShift board | TP1, TP2, TP3, TP5 | 4 | Test point, compact, red | Keystone Electronics | 5005 | 534-5005 | UNVERIFIED | 36-5005-ND | VERIFIED | 0.35 | 1.40 | https://www.digikey.com/en/products/result?keywords=Keystone 5005 |  | yes
A. TimeShift board | TP4 | 1 | Test point, compact, black (GND) | Keystone Electronics | 5006 | 534-5006 | UNVERIFIED | 36-5006-ND | VERIFIED | 0.33 | 0.33 | https://www.digikey.com/en/products/detail/keystone-electronics/5006/255330 |  | yes
A. TimeShift board | H1-H4 | 4 | Self-adhesive snap-lock PCB support for a 3.2 mm hole, 12.7 mm (1/2 in) high | Essentra Components | LCBSBM-8-01A-RT |  | NOT FOUND | RPC4230-ND | VERIFIED | 1.32 | 5.28 | https://www.digikey.com/en/products/result?keywords=LCBSBM-8-01A-RT | Board holes: 4 x 3.2 mm, 3.5 mm in from each corner (centres 77.0 x 56.0 mm). Board snaps on, feet stick to a clean, component-free spot (reversible). Alternative: the M3 standoffs below. | yes
A. TimeShift board | (PCB) | 1 | DX TimeShift rev A bare PCB, 2-layer, 84.0 x 63.0 mm, r 2 mm corners (see hardware/gerbers) | any PCB fab | DXTS rev A |  | n/a |  | n/a | 2.00 | 2.00 |  | Typical 5-board minimum order of about $10 plus shipping: $2 per board. | yes
B. DX plug cable (J1 to U701 socket) | J1 cable, board end | 1 | IDC ribbon socket 2x8, 2.54 mm, for 1.27 mm ribbon | 3M | 89116-0101 | 517-D89116-0131HK | VERIFIED (aggregator) | MKC16A-ND | VERIFIED | 1.84 | 1.84 | https://www.digikey.com/en/products/detail/3m/89116-0101/229692 | Mouser number is the equivalent 3M D89116-0131HK. RS lists 89116-0101 as being discontinued. | yes
B. DX plug cable (J1 to U701 socket) | J1 cable, strain relief | 1 | Strain relief clip for the 16-way IDC socket | 3M | 3448-89116 |  | NOT FOUND | MKSR16-ND | VERIFIED | 0.62 | 0.62 | https://www.digikey.com/en/products/result?keywords=3448-89116 | Optional but recommended | yes
B. DX plug cable (J1 to U701 socket) | DX plug | 1 | DIP-16 IDC plug (header plug), 0.300 in row spacing, for 1.27 mm ribbon | Adam Tech | FDP-316-T |  | NOT FOUND | 2057-FDP-316-T-ND | VERIFIED | 1.59 | 1.59 | https://www.digikey.com/en/products/result?keywords=FDP-316-T | Goes into the DX U701 socket. Alternative: HARTING 09181169622 (DK 1195-1653-ND), confirm 7.62 mm row spacing first. | yes
B. DX plug cable (J1 to U701 socket) | ribbon | 1 | Flat ribbon cable 16-way, 1.27 mm pitch, grey, per foot (use 10-15 cm) | 3M | 3365/16 | 517-3365/16-100 | VERIFIED (aggregator) | 19-3365/16-DS-ND | VERIFIED | 1.05 | 1.05 | https://www.digikey.com/en/products/result?keywords=3365/16 | DK sells per foot (buy 2 ft for one spare try). The Mouser number is a 100 ft roll: buy per foot at DK, or any 16-way 1.27 mm grey ribbon. | yes
C. Panel pot and wiring | RV1 (panel) | 1 | Panel pot 16 mm, 10 kOhm LINEAR, solder lugs, 6 mm SLOTTED shaft 15 mm, M7x0.75 bushing; nut + washer included | TT Electronics/BI | P160KNP-0EC15B10K |  | NOT FOUND | 987-1724-ND | VERIFIED | 2.64 | 2.64 | https://www.digikey.com/en/products/detail/tt-electronics-bi/P160KNP-0EC15B10K/5957468 | Matches the DX's bare short tuning shafts (no knob, adjust by hand or screwdriver). Panel hole 7.5-8.0 mm (datasheet 7.5 +0.2/-0; 8.0 is acceptable, the nut and 12 mm washer cover it). Tab hole 3.0 mm at 7.8 mm (datasheet p10). | yes
C. Panel pot and wiring | panel washer + nut | 0 | M7x0.75 hex nut (9.9 mm A/F) + flat washer 12 mm OD | TT Electronics/BI | (supplied with RV1) |  | n/a |  | n/a | 0.00 | 0.00 |  | Supplied with the pot. If you snap the anti-rotation tab off, add an M7 internal-tooth lock washer (not stocked at Mouser/DK; audio-parts suppliers sell them). | yes
C. Panel pot and wiring | J2 housing | 1 | JST XH housing 3-way | JST | XHP-3 | 306-XHP-3 | UNVERIFIED | 455-2219-ND | VERIFIED | 0.10 | 0.10 | https://www.digikey.com/en/products/detail/jst-sales-america-inc/XHP-3/1651017 | Pot lead | yes
C. Panel pot and wiring | J3 housing | 1 | JST XH housing 2-way | JST | XHP-2 | 306-XHP-2 | UNVERIFIED | 455-2266-ND | VERIFIED | 0.10 | 0.10 | https://www.digikey.com/en/products/result?keywords=XHP-2 | Clock lead | yes
C. Panel pot and wiring | J2/J3 contacts | 10 | JST XH crimp contact, 22-28 AWG | JST | SXH-001T-P0.6 | 306-SXH-001T-P0.6 | VERIFIED (aggregator) | 455-1135-1000-ND | VERIFIED | 0.10 | 1.00 | https://www.mouser.com/ProductDetail/306-SXH-001T-P0.6 | 5 needed + 5 spares. Mouser sells single pieces. Digi-Key only sells a strip of 1000 ($40.05). If you have no XH crimp tool use the pre-crimped leads below instead. | yes
C. Panel pot and wiring | J2/J3 leads (no-crimp option) | 5 | JST pre-crimped lead, SXH contact both ends, 22 AWG, 305 mm (12 in) | JST | ASXHSXH22K305 |  | NOT FOUND | 455-3241-ND | VERIFIED | 1.13 | 5.65 | https://www.digikey.com/en/products/result?keywords=ASXHSXH22K305 | OPTION instead of crimping: cut one end off each lead (gives 5 x 300 mm leads, all black: mark them with coloured heat-shrink). Not in the total. | no
C. Panel pot and wiring | hook-up wire | 1 | Hook-up wire 22 AWG stranded, 6 colours x 25 ft | Adafruit | 3111 | 485-3111 | VERIFIED (aggregator) | 1528-1744-ND | VERIFIED | 19.95 | 19.95 | https://www.digikey.com/en/products/result?keywords=Adafruit 3111 | Red +5 V, black GND, yellow wiper, blue clock. About 0.3 m of each colour used. Any 22-26 AWG stranded wire is fine (SXH contact: 22-28 AWG). | yes
C. Panel pot and wiring | heat-shrink | 1 | Heat-shrink tubing assortment, 2:1, 280 pieces | Adafruit | 4559 |  | NOT FOUND | 1528-4559-ND | VERIFIED | 9.95 | 9.95 | https://www.digikey.com/en/products/result?keywords=Adafruit 4559 | Cover the three pot lugs and the grabber joint | yes
C. Panel pot and wiring | clock tap clip | 2 | Mini-grabber test clip with solder terminal (0.090 in wire hole) | Pomona Electronics | 3925-0 | 565-3925-0 | UNVERIFIED | 501-1244-ND | VERIFIED | 3.19 | 6.38 | https://www.digikey.com/en/products/detail/pomona-electronics/3925-0/736721 | One on R791 (clock), one optional for the GND wire. Other colours: 3925-2 red, 3925-6 blue. | yes
C. Panel pot and wiring | cable ties | 5 | Cable tie 3.9 in (99 mm), nylon, natural | Panduit | PLT1M-C | 644-PLT1M-C | UNVERIFIED | 298-1020-ND | VERIFIED | 0.25 | 1.25 | https://www.digikey.com/en/products/detail/panduit-corp/PLT1M-C/280033 | Dress the pot and clock leads away from the transformer | yes
C. Panel pot and wiring | panel label | 1 | Laminated label tape 9 mm white on black, for 'SNARE DELAY 0 <-> 1 BEAT' | Brother | TZe-325 |  | NOT FOUND |  | NOT FOUND | 15.00 | 15.00 |  | Not stocked at Mouser or Digi-Key: office-supply store. TZe-335 (12 mm) also fine. | yes
D. Options and contingency (not in the total) | RV1 alternative | 1 | Same pot with 6 mm KNURLED 18-tooth shaft 15 mm, solder lugs | TT Electronics/BI | P160KNP-0QC15B10K |  | NOT FOUND | 987-1731-ND | VERIFIED | 1.86 | 1.86 | https://www.digikey.com/en/products/result?keywords=P160KNP-0QC15B10K | Use with a knob. Mouser 858-P160KN-0QC15B10K is the PC-PIN version: do not order it by mistake. | no
D. Options and contingency (not in the total) | knob (optional) | 1 | Knob, black, 15.9 mm, set screw, for 6 mm shaft | Kilo International | OEJNI-63-4-7 |  | NOT FOUND | 226-4227-ND | VERIFIED | 12.15 | 12.15 | https://www.digikey.com/en/products/result?keywords=OEJNI-63-4-7 | Check the bore (6 mm) on the datasheet before ordering. Any small knob for a 6 mm shaft will do. | no
D. Options and contingency (not in the total) | H1-H4 alternative | 4 | Hex standoff M3, 10 mm, nylon, female-female | Essentra Components | MTS-10S | 144-MTS-10S | VERIFIED (aggregator) | RPC3120-ND | VERIFIED | 0.80 | 3.20 | https://www.digikey.com/en/products/detail/essentra-components/MTS-10S/392817 | Only if you mount to a bracket or existing threaded points instead of the adhesive supports | no
D. Options and contingency (not in the total) | H1-H4 alternative screws | 8 | Screw M3 x 6 mm, nylon, pan head Phillips | Wurth Elektronik | 97790603111 | 710-97790603111 | UNVERIFIED | 732-13704-ND | VERIFIED | 0.26 | 2.08 | https://www.digikey.com/en/products/result?keywords=97790603111 | For the standoffs above | no
D. Options and contingency (not in the total) | U1 socket upgrade | 1 | Machined-pin IC socket DIP-16 (gentler on the 1983 chip's legs) | Mill-Max | 110-43-316-41-001000 | 575-110433161 | VERIFIED (aggregator) | ED90034-ND | VERIFIED | 3.50 | 3.50 | https://www.digikey.com/en/products/result?keywords=110-43-316-41-001000 | Optional replacement for the stamped U1 socket | no
D. Options and contingency (not in the total) | DX U701 socket (contingency) | 1 | IC socket DIP-16, 7.62 mm, to fit in the DX if U701 turns out to be SOLDERED (findings Q1) | TE Connectivity | 1-2199298-4 | 571-1-2199298-4 | UNVERIFIED | A120349-ND | VERIFIED | 0.30 | 0.30 | https://www.digikey.com/en/products/detail/te-connectivity-amp-connectors/1-2199298-4/5022041 | Only if Q1 fails. Desoldering U701 is a permanent change: ask the owner first. | no
E. Tools (not in the total) | tool | 1 | DIP-16 test clip (logic-analyser probing of U701, findings Q2) | Pomona Electronics | 3916A |  | NOT FOUND | 3916A-ND | VERIFIED | 28.86 | 28.86 | https://www.digikey.com/en/products/detail/pomona-electronics/3916A/736720 | Only 4 in stock at DK on 2026-11-06 | no
E. Tools (not in the total) | tool | 1 | Logic analyser 8 ch (or a 24 MHz FX2 clone + PulseView, about $15) | Saleae | SAL-00111 | 903-SAL-00111 | VERIFIED (aggregator) | 6648-SAL-00111-ND | VERIFIED | 499.00 | 499.00 | https://www.mouser.com/ProductDetail/903-SAL-00111 | Any >= 4 MHz analyser is enough | no
E. Tools (not in the total) | tool | 1 | USB-A to Mini-B cable 3 ft (to flash the Nano OUT of the board) | Qualtek | 3021003-03 |  | UNVERIFIED | Q362-ND | VERIFIED | 3.35 | 3.35 | https://www.digikey.com/en/products/detail/qualtek/3021003-03/1531289 |  | no
E. Tools (not in the total) | tool | 1 | JST XH crimp tool (Engineer PA-09 or IWISS SN-28B; JST WC-110 is the official one) | JST | WC-110 |  | NOT FOUND | 455-1136-ND | VERIFIED | 536.51 | 536.51 | https://www.digikey.com/en/products/result?keywords=WC-110 | PA-09 (about $40) or SN-28B (about $20-30) from online tool shops do the job. Not needed with pre-crimped leads. | no
