sabrehagen/oberheim-dx-timeshift/hardware/exports/bom.csv

References | Value | Footprint | Qty | Part / MPN | Socket | Cable | Description
C1 | 10uF | Capacitor_THT:CP_Radial_D5.0mm_P2.00mm | 1 |  |  |  | Bulk, at J1. Electrolytic >= 16 V
C2,C3,C4,C5,C6 | 100nF | Capacitor_THT:C_Disc_D5.0mm_W2.5mm_P5.00mm | 5 |  |  |  | Decoupling Nano,Decoupling U1,Decoupling U3,Decoupling U4,Pot RC filter
C7 | 1nF | Capacitor_THT:C_Disc_D5.0mm_W2.5mm_P5.00mm | 1 |  |  |  | Clock RC filter
J1 | DX PLUG | Connector_IDC:IDC-Header_2x08_P2.54mm_Vertical | 1 | 2x8 shrouded box header 2.54 mm, e.g. Wurth 61201621621 |  | 16-way 1.27 mm ribbon 10-15 cm + 2x8 IDC socket (3M 89116-0101) + DIP-16 IDC plug Adam Tech FDP-316-T (alt. HARTING 09181169622) | 2x8 shrouded box header. 16-way ribbon -> DIP-16 IDC plug -> DX U701 socket. Pin names = DIP pin numbers at the plug end.
J2 | POT | Connector_JST:JST_XH_B3B-XH-A_1x03_P2.50mm_Vertical | 1 | JST B3B-XH-A (housing XHP-3, crimps SXH-001T-P0.6) |  |  | To rear-panel 10k lin pot: 1 = GND (CCW lug), 2 = wiper, 3 = +5V (CW lug)
J3 | CLK | Connector_JST:JST_XH_B2B-XH-A_1x02_P2.50mm_Vertical | 1 | JST B2B-XH-A (housing XHP-2, crimps SXH-001T-P0.6) |  |  | 1 = DX CLOCK OUT node (R791 lead, Q709 collector side), 2 = GND
JP1 | PPQN | Connector_PinHeader_2.54mm:PinHeader_2x02_P2.54mm_Vertical | 1 | 2x2 pin header 2.54 mm + 1 jumper shunt |  |  | PPQN select (internal pull-ups): JP1 both open = 96, JP1 1-2 closed (D10) = 48, JP1 3-4 closed (D11) = 24
R1,R2,R3,R4 | 1k | Resistor_THT:R_Axial_DIN0207_L6.3mm_D2.5mm_P10.16mm_Horizontal | 4 |  |  |  | Pot wiper series resistor (RC filter with C6),Series protection U1 pin 10 -> Nano D5,Series protection U1 pin 12 -> Nano D4,Series protection U1 pin 15 -> Nano D2
R5,R6 | 10k | Resistor_THT:R_Axial_DIN0207_L6.3mm_D2.5mm_P10.16mm_Horizontal | 2 |  |  |  | MUX_SEL pull-down: MCU off/reset/blank -> bypass,R_CLK1: 10k series from the DX clock tap
R7 | 100k | Resistor_THT:R_Axial_DIN0207_L6.3mm_D2.5mm_P10.16mm_Horizontal | 1 |  |  |  | R_CLK2: 100k pull-down (clock lead unplugged -> low)
TP1 | REPLAY | TestPoint:TestPoint_Keystone_5005-5009_Compact | 1 | Keystone 5005 (red) |  |  | TP_REPLAY (Nano D12): pulses high on every replayed hit
TP2 | RST2 CHIP | TestPoint:TestPoint_Keystone_5005-5009_Compact | 1 | Keystone 5005 (red) |  |  | RST2 chip side (U1 pin 15)
TP3 | RST2 PLUG | TestPoint:TestPoint_Keystone_5005-5009_Compact | 1 | Keystone 5005 (red) |  |  | RST2 plug side (mux 1Y -> J1 DIP 15)
TP4 | GND | TestPoint:TestPoint_Keystone_5005-5009_Compact | 1 | Keystone 5006 (black) |  |  | Ground for scope probe
TP5 | CLK_IN | TestPoint:TestPoint_Keystone_5005-5009_Compact | 1 | Keystone 5005 (red) |  |  | Conditioned clock at Nano D3
U1 | MC14174B (orig. U701) | Package_DIP:DIP-16_W7.62mm_Socket | 1 | DIP-16 IC socket, 7.62 mm (e.g. TE 1-2199298-4); chip = original U701 |  |  | DIP-16 socket that receives the ORIGINAL U701 chip removed from the DX (MC14174B / 74C174 hex D flip-flop). Only the socket is fitted at assembly.
U2 | Arduino Nano v3 (5V) | timeshift:Arduino_Nano_Socketed | 1 | Arduino Nano v3 (A000005) or ATmega328P clone | 2 x female header 1x15 P2.54 mm (e.g. Samtec SSW-115-01-T-S) |  | Arduino Nano v3 (or clone), plugged into 2 x 1x15 female headers 2.54 mm. D13 = LED_ACT uses the Nano's own 'L' LED. Footprint = Module:Arduino_Nano (identical pads) plus 3D models of the Nano and the two female headers.
U3 | 74HC157 | Package_DIP:DIP-16_W7.62mm_Socket | 1 | 74HC157N (DIP-16), e.g. TI SN74HC157N | DIP-16 IC socket 7.62 mm |  | Quad 2:1 mux. S low = A = bypass (U701 direct), S high = B = delayed (Nano)
U4 | 74HC14 | Package_DIP:DIP-14_W7.62mm_Socket | 1 | 74HC14N (DIP-14), e.g. TI SN74HC14N | DIP-14 IC socket 7.62 mm |  | Hex Schmitt inverter, clock conditioning (2 gates in series = non-inverting)
