sabrehagen/oberheim-dx-timeshift/hardware/exports/board.step

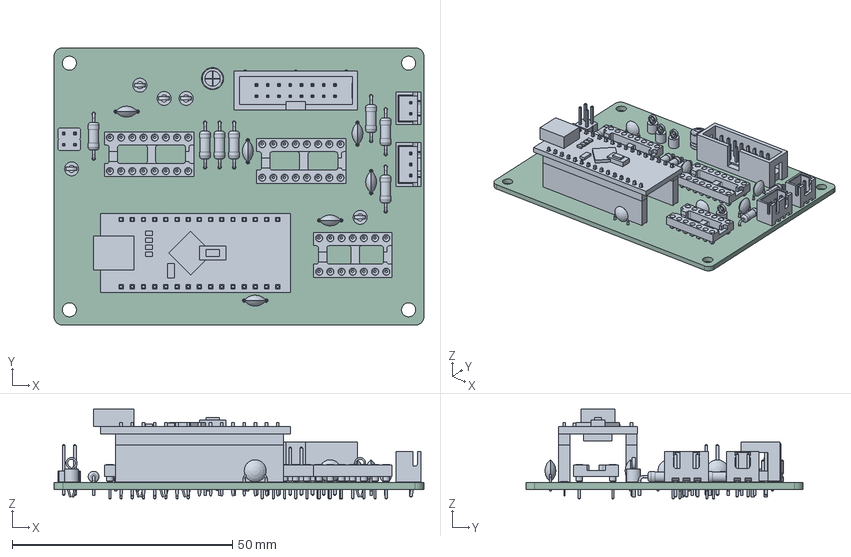
[picture p78: CAD file, 2026-11-06]
hardware/exports/board.step
84.0 x 63.0 x 20.4 mm
TestPoint_Keystone_5005-5009_Compact x 5
PinSocket_1x15_P2.54mm_Vertical x 2
pcb
spacer_0
spacer_15
pins
atmega328p
usb_uart
usb_miniB
reset_body
reset_cap
resonator
led0
led1
led2
led3
regulator
DIP-16_W7.62mm_Socket x 2
R_Axial_DIN0207_L6.3mm_D2.5mm_P10.16mm_Horizontal x 7
IDC-Header_2x08_P2.54mm_Vertical
PinHeader_2x02_P2.54mm_Vertical
C_Disc_D5.0mm_W2.5mm_P5.00mm x 6
JST_XH_B2B-XH-A_1x02_P2.50mm_Vertical
DIP-14_W7.62mm_Socket
CP_Radial_D5.0mm_P2.00mm
JST_XH_B3B-XH-A_1x03_P2.50mm_Vertical
timeshift_PCB
