sabrehagen/oberheim-dx-timeshift/hardware/kicad/timeshift/3d/Arduino_Nano_v3_on_sockets.step

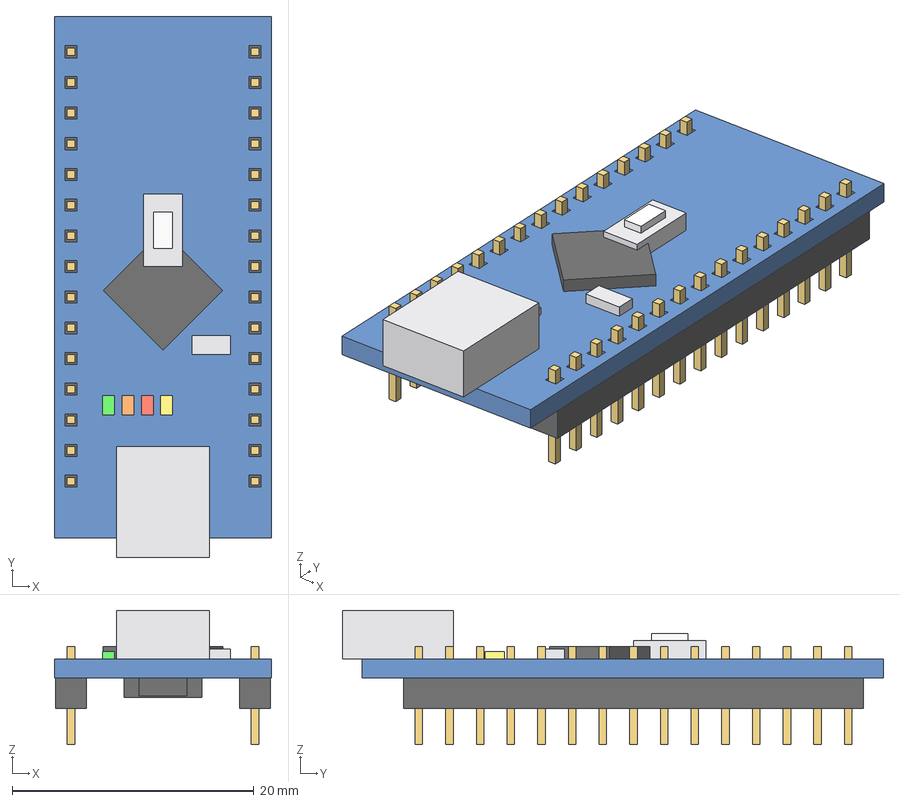
[picture p79: CAD file, 2026-11-06]
hardware/kicad/timeshift/3d/Arduino_Nano_v3_on_sockets.step
18.0 x 44.8 x 11.1 mm
pcb
spacer_0
spacer_15
pins
atmega328p
usb_uart
usb_miniB
reset_body
reset_cap
resonator
led0
led1
led2
led3
regulator
