sabrehagen/oberheim-dx-timeshift/hardware/mechanical/rear-panel-drill-template.dxf

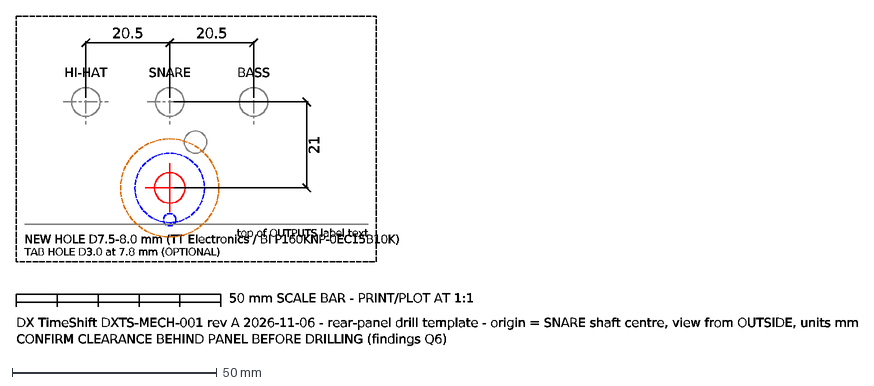
[picture p80: CAD file, 2026-11-06]
hardware/mechanical/rear-panel-drill-template.dxf
HI-HAT
SNARE
BASS
NEW HOLE D7.5-8.0 mm (TT Electronics / BI P160KNP-0EC15B10K)
TAB HOLE D3.0 at 7.8 mm (OPTIONAL)
top of OUTPUTS label text
20.5
21
50 mm SCALE BAR - PRINT/PLOT AT 1:1
DX TimeShift DXTS-MECH-001 rev A 2026-11-06 - rear-panel drill template - origin = SNARE shaft centre, view from OUTSIDE, units mm
CONFIRM CLEARANCE BEHIND PANEL BEFORE DRILLING (findings Q6)
