sabrehagen/oberheim-dx-timeshift/hardware/mechanical/wiring-diagram.pdf

# WIRING DIAGRAM — DX TimeShift in an Oberheim DX (board 1721A, U701)

Not to scale. DX board positions scaled from the Oberheim parts layout (±3 mm). Colours = suggested wire colours. Every pin number is also on the PCB silkscreen.

### REAR PANEL (inside view, from above)

OBERHEIM DX PROCESSOR BOARD 1721A (top view, front of the DX at the bottom)

SNARE | board-mounted output / clock jacks | CLK OUT

DRUM TUNING pots on their own PCB (harness → header D)

D

BASS | SNARE | HI-HAT | TOMS | PERC

CYMBAL

snare
voice

U701 U702 U703
U704

U712 Z80

U713

U714

U715

U716

U717

U718

C723

B1

R791 | Q709

1760B sync board (if fitted)

ZONE A (preferred)
TimeShift 84 × 63 mm
on 12.7 mm supports

ZONE B (alternative)

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
TP3 TP2

TP4

TP5

U1 ← ORIGINAL U701

U3 74HC157

U4 74HC14

U2 Arduino Nano

J1 DX PLUG

UNPLUG NANO BEFORE USB

◄ USB end faces the left board edge

JP1 PPQN

▲ pin 1

J2

J3

DX TIMESHIFT rev A, top view

from positions.csv · 84 × 63 mm · 4 × M3 at 77 × 56 mm

DIP-16 IDC plug in the
empty U701 socket
(red stripe / pin 1 to the notch)

### 16-way ribbon, 10–15 cm

red stripe = conductor 1 = J1 pin 1 = DIP pin 1 (table below; check with dip-plug-mapping.pdf)

### 2 SNARE DELAY pot (rear panel, below SNARE)

10 k lin, TT P160KNP-0EC15B10K, seen from INSIDE (solder side)

body Ø17

lug 3 (CW) | lug 1 (CCW)

2

Fully anticlockwise (from outside) = 0 = no delay (bypass); fully clockwise = 1 beat.
Find lug 1 with a meter: shaft fully anticlockwise (from outside) → lug 1 to lug 2 reads ≈ 0 Ω. Lug 2 = middle. From INSIDE, lug 1 is on the RIGHT when the lugs point down (mirrored). Twist the 3 wires; length ≈ 300 mm.

GND (lug 1 → J2-1) WIPER (lug 2 → J2-2) +5 V (lug 3 → J2-3)

### 3 Clock tap at R791 (CLOCK OUT node)

front-right of the DX board, next to battery B1

+5 V

R791 1 kΩ
→ CLOCK OUT jack tip

Q709 (emitter to GND;
leg order UNCONFIRMED)

mini-grabber
on this lead

Clip on the R791 lead at the Q709-COLLECTOR side (not the +5 V side).
Check: DX on and stopped, this lead ≈ 0 V (other lead 5.0 V); DX off: 0 Ω to CLOCK OUT tip. 96 PPQN, rising edge = tick. Or tack-solder the wire to the lead.
GND wire (J3-2) is OPTIONAL: to a DX ground point with 0 Ω to U701 pin 8,
or leave it unconnected with its end insulated. Don't use a Q709 leg:
which Q709 leg is the emitter is UNCONFIRMED. Twist CLK + GND; ≈ 250 mm.

J3 pin 1 = CLK (blue)
J3 pin 2 = GND (black)

J2 pin 1 = GND (black, lug 1, CCW) J2 pin 2 = WIPER (yellow, lug 2) J2 pin 3 = +5 V (red, lug 3, CW)

## J1 ↔ RIBBON ↔ DIP-16 PLUG MAPPING (brief 3.5; source: hardware/kicad/tools/netlist.py)

J1 pin | cond. | DIP pin | U701 signal at that DIP pin | TimeShift path
1 | 1 | 1 | CLR (tied +5V) | straight through to U1 pin 1
2 | 2 | 16 | VDD = +5V | +5 V supply (≤ 60 mA)
3 | 3 | 2 | Q1 = RST1 (bass) | straight through to U1 pin 2
4 | 4 | 15 | Q6 = RST2 (SNARE) | INTERCEPTED via U3 mux (not U1)
5 | 5 | 3 | D1 = bus D0 | straight through to U1 pin 3
6 | 6 | 14 | D6 = bus D3 | straight through to U1 pin 14
7 | 7 | 4 | D2 = bus D1 | straight through to U1 pin 4
8 | 8 | 13 | D5 = bus D4 | straight through to U1 pin 13
J1 pin | cond. | DIP pin | U701 signal at that DIP pin | TimeShift path
9 | 9 | 5 | Q2 = FFA1 (bass) | straight through to U1 pin 5
10 | 10 | 12 | Q5 = FFA2 (SNARE) | INTERCEPTED via U3 mux (not U1)
11 | 11 | 6 | D3 = bus D2 | straight through to U1 pin 6
12 | 12 | 11 | D4 = bus D5 | straight through to U1 pin 11
13 | 13 | 7 | Q3 = FFB1 (bass) | straight through to U1 pin 7
14 | 14 | 10 | Q4 = FFB2 (SNARE) | INTERCEPTED via U3 mux (not U1)
15 | 15 | 8 | VSS = GND | GND
16 | 16 | 9 | CLK = GEN0* | straight through to U1 pin 9

Conductor n of the ribbon lands on J1 pin n; the DIP plug puts conductor n on the DIP pin shown. Orange = the three snare lines the TimeShift intercepts.

LEGEND
+5 V (pot lug 3 / CW)
GND (pot lug 1 / CCW, clock GND) pot wiper (lug 2)
clock tap (R791 → J3-1)
16-way ribbon, red stripe = 1 intercepted snare lines (10/12/15) suggested board zones

① U701 socket: lift the original MC14174B out (note the notch), fit it in U1 on the TimeShift, then push the DIP plug into the empty DX socket, pin 1 to the notch end. (Findings Q1: confirm U701 is socketed first.) ② New pot hole: rear-panel-drill-template.pdf. Do not touch the tuning-pot harness (header D).
③ Clock tap: mini-grabber on R791 (Q709-collector side). 10 kΩ + Schmitt input on the TimeShift side.
④ Board (84 × 63 mm) in ZONE A on 4 self-adhesive snap-lock supports (12.7 mm), J1 towards U701, ribbon ≤ 15 cm. Check lid clearance first (findings Q3: ≥ 32 mm incl. the Nano) and any 1760B sync board or Electrongate MIDI board in the area. ZONE B needs a 20–25 cm ribbon: use it only after the GEN0* scope check (findings Q4). Power comes through the ribbon (U701 pins 16/8): no extra wires; never use the +5M battery rail. Flash the Nano OUT of the board, or only with the DX switched on. JP1 (PPQN): no shunt = 96 (plain DX); shunt on JP1 1-2 = 48 (D10); shunt on JP1 3-4 = 24 (D11).

PROJECT

## DX TimeShift (snare) for Oberheim DX, board 1721A

DRAWING

# Wiring diagram (pot, clock tap, ribbon)

DWG NO.

## DXTS-MECH-002

SCALE

## NTS

REV

A

DATE

2026-11-06

SHEET 1 / 1 UNITS mm

A3 landscape
