sabrehagen/oberheim-dx-timeshift/docs/reference/photos/electrongate_dx_board_installed_3.jpg

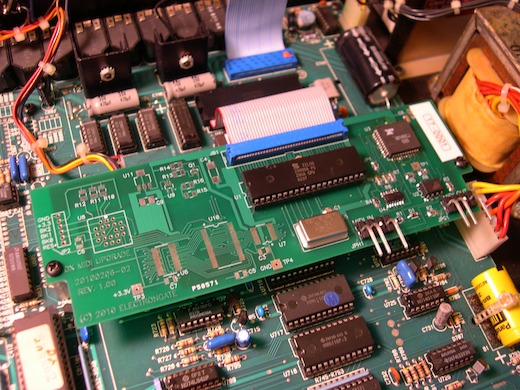
docs/reference/photos/electrongate_dx_board_installed_3.jpg
