sabrehagen/oberheim-dx-timeshift/docs/reference/photos/electrongate_dx_install_pcb_1.jpg

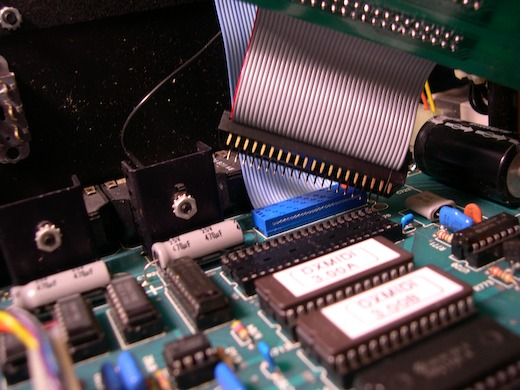
docs/reference/photos/electrongate_dx_install_pcb_1.jpg
