sabrehagen/oberheim-dx-timeshift/docs/reference/photos/electrongate_stretch_w_midi_installed.JPG

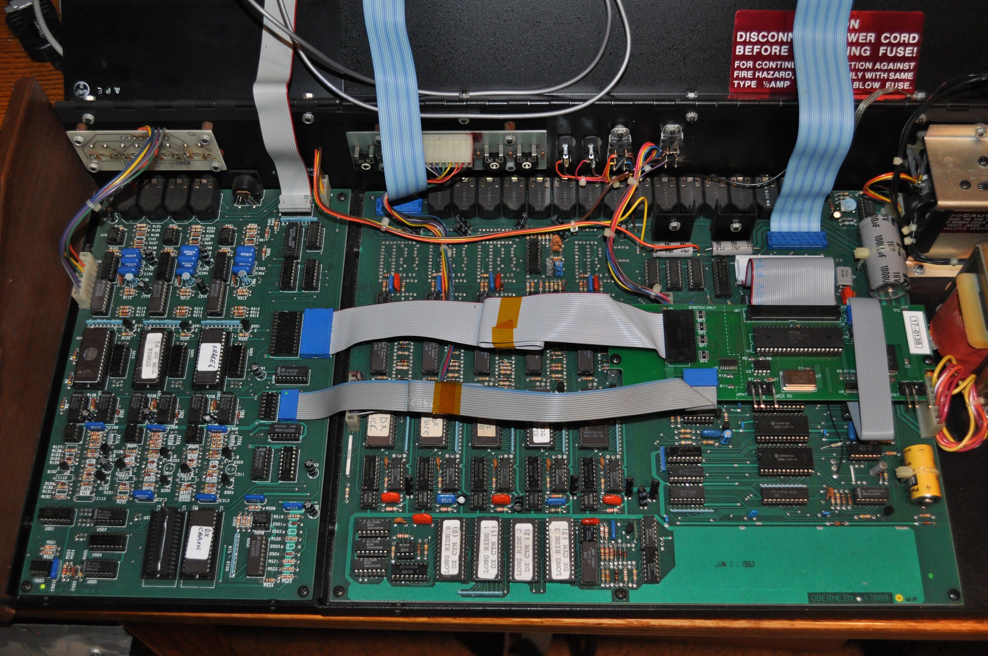
docs/reference/photos/electrongate_stretch_w_midi_installed.JPG
