sabrehagen/oberheim-dx-timeshift/webapp/screenshots/12-build.png

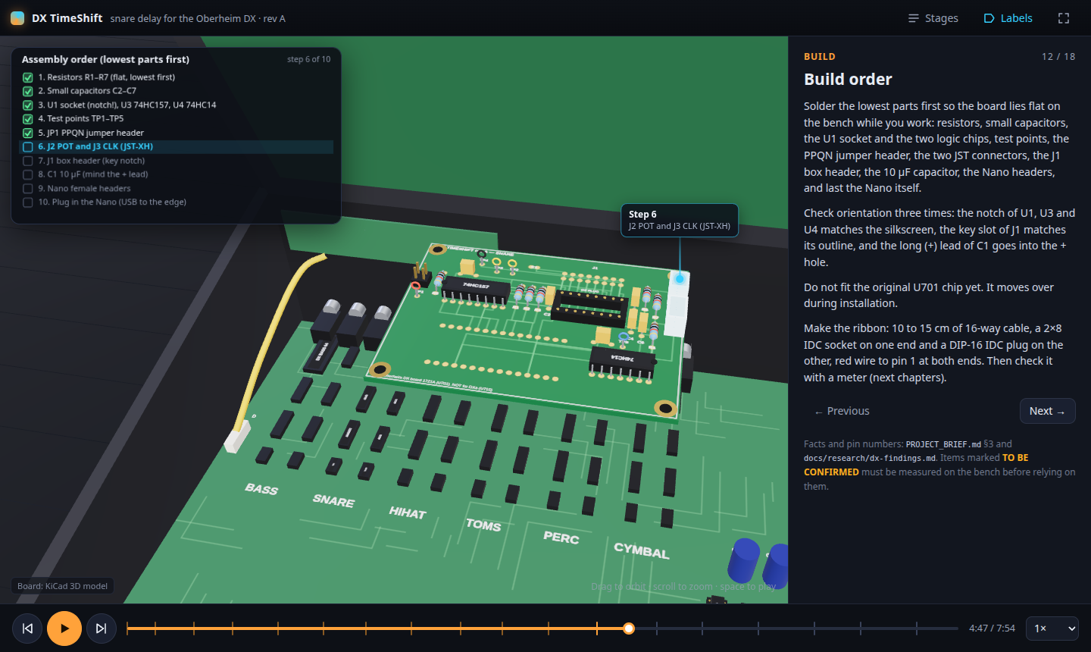
webapp/screenshots/12-build.png
