sabrehagen/oberheim-dx-timeshift/webapp/screenshots/13-install-model.png

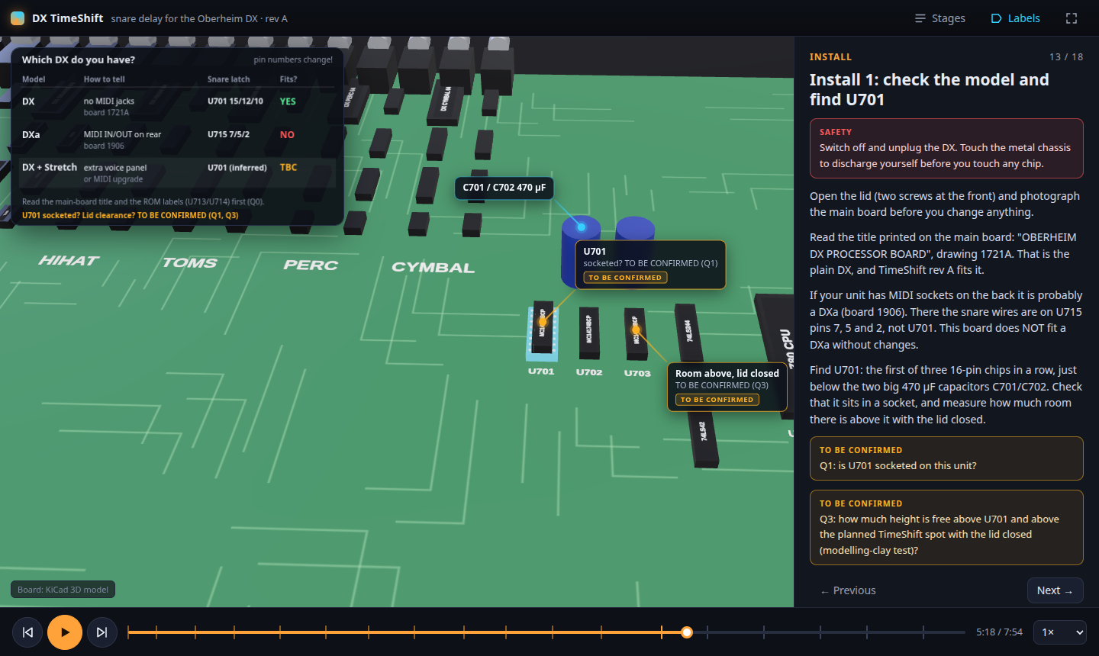
webapp/screenshots/13-install-model.png
