sabrehagen/oberheim-dx-timeshift/webapp/screenshots/14-install-socket.png

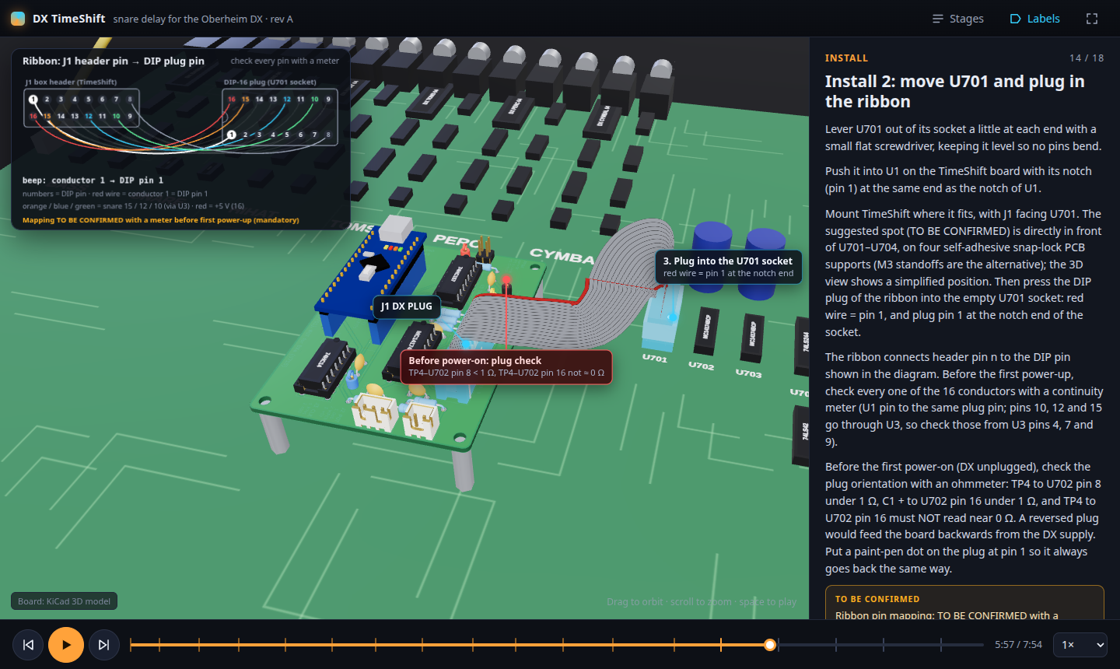
webapp/screenshots/14-install-socket.png
