sabrehagen/oberheim-dx-timeshift/webapp/screenshots/15-install-pot.png

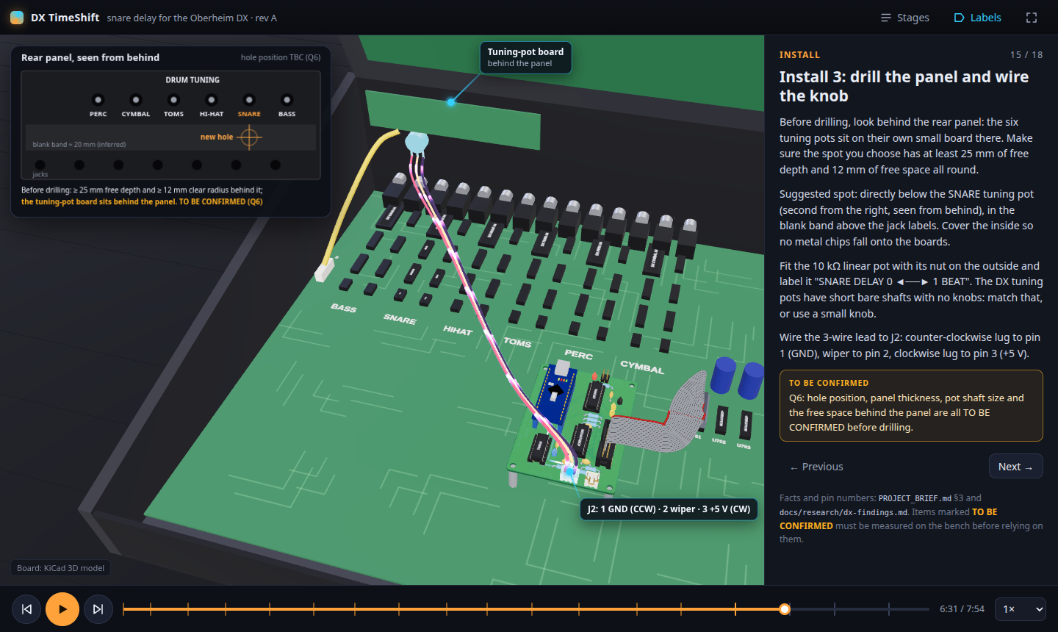
webapp/screenshots/15-install-pot.png
