sabrehagen/oberheim-dx-timeshift/webapp/screenshots/16-install-clock.png

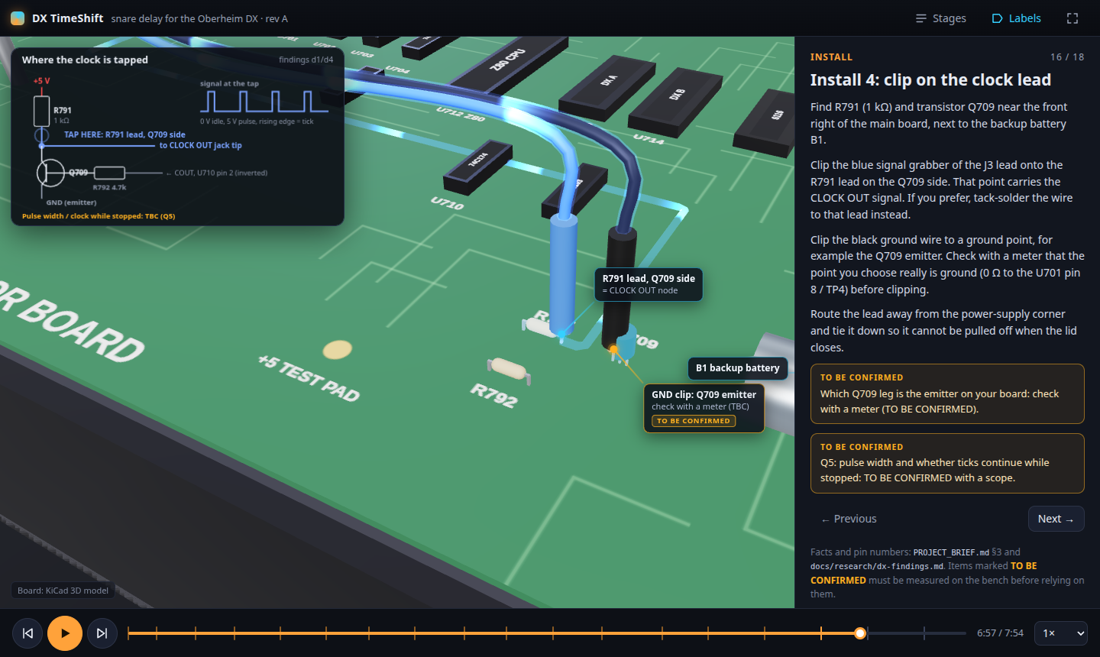
webapp/screenshots/16-install-clock.png
