sabrehagen/oberheim-dx-timeshift/webapp/screenshots/v2-13-install-model.png

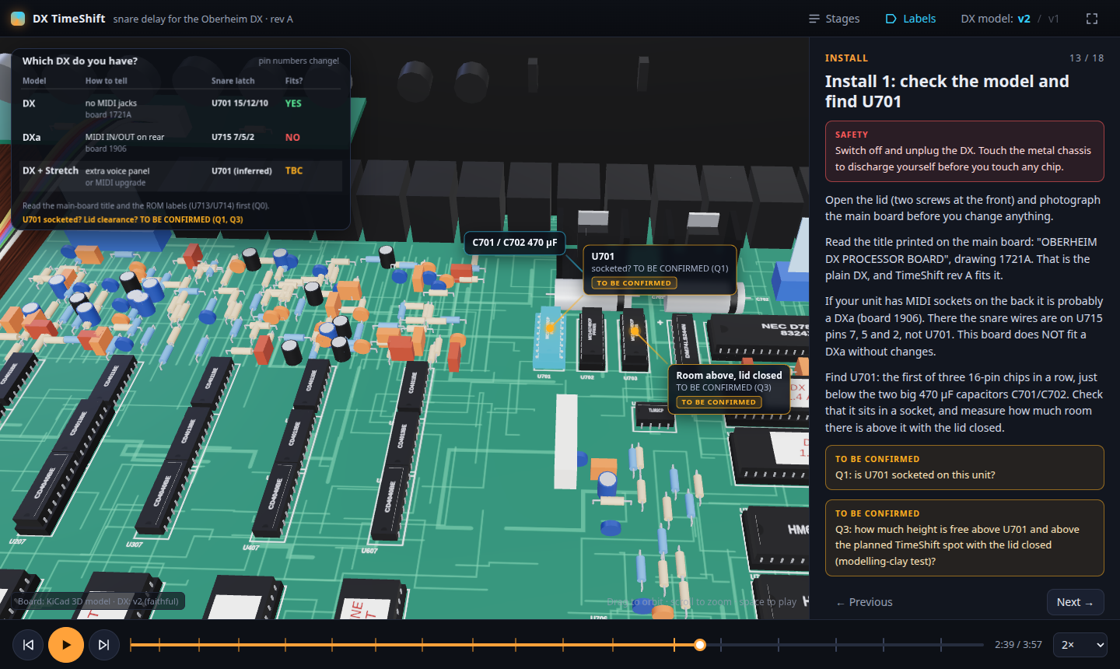
webapp/screenshots/v2-13-install-model.png
