sabrehagen/oberheim-dx-timeshift/webapp/screenshots/v2-15-install-pot.png

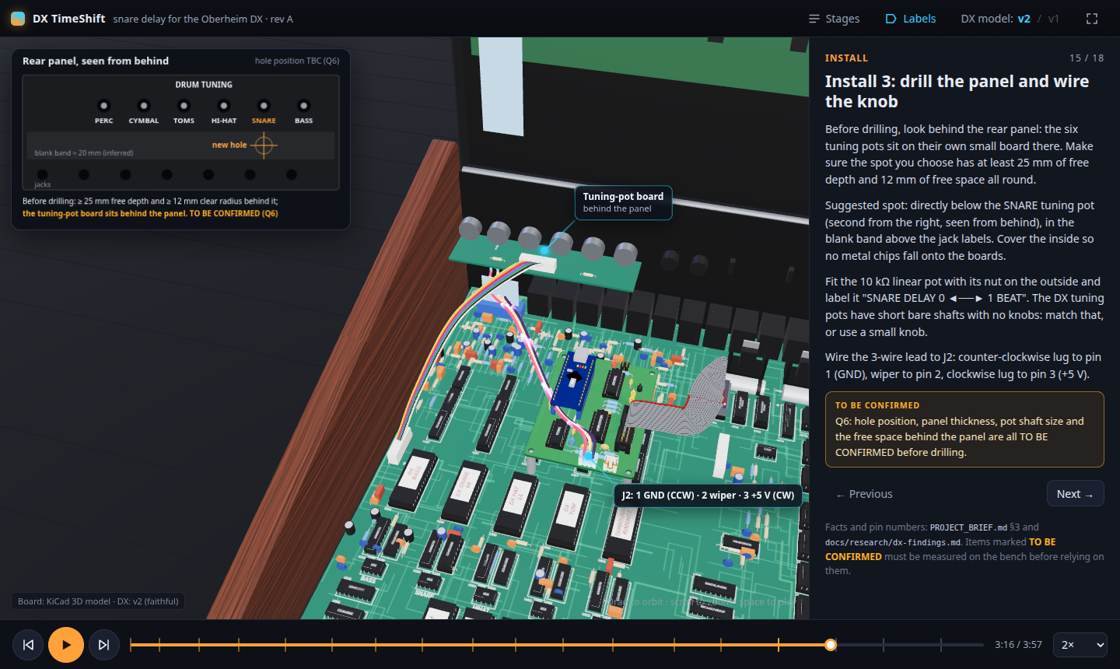
webapp/screenshots/v2-15-install-pot.png
