sabrehagen/oberheim-dx-timeshift/webapp/screenshots/v2-16-install-clock.png

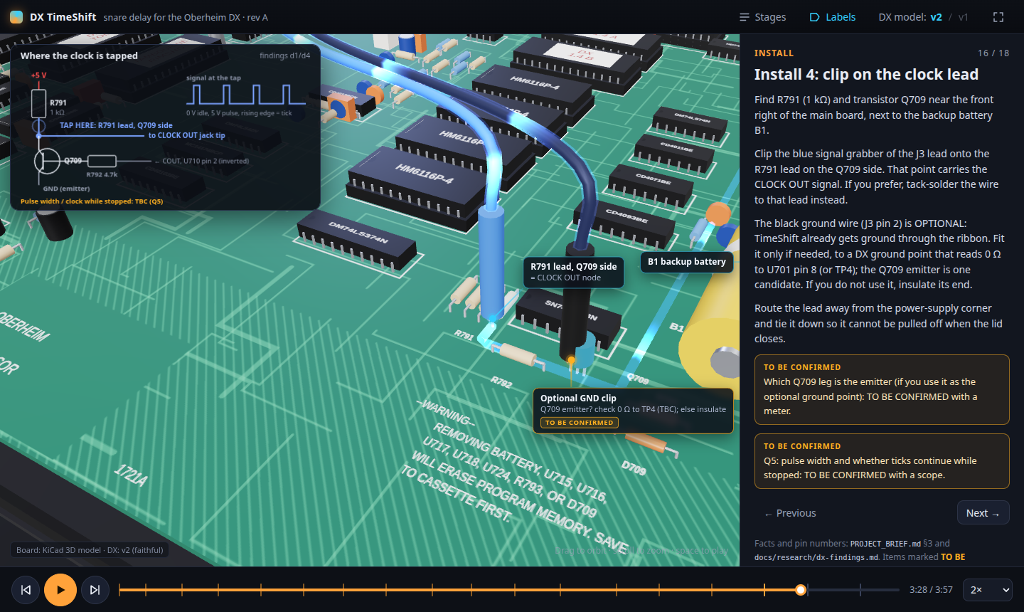
webapp/screenshots/v2-16-install-clock.png
