sabrehagen/oberheim-dx-timeshift/webapp/screenshots/17-test.png

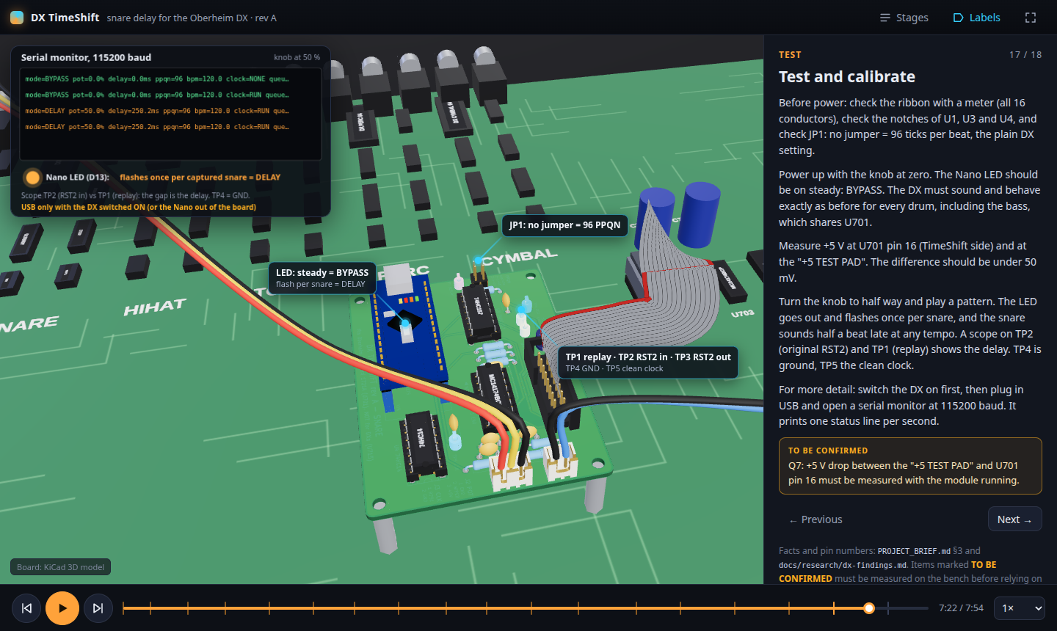
webapp/screenshots/17-test.png
