sabrehagen/oberheim-dx-timeshift/hardware/exports/fab-assembly-top.pdf

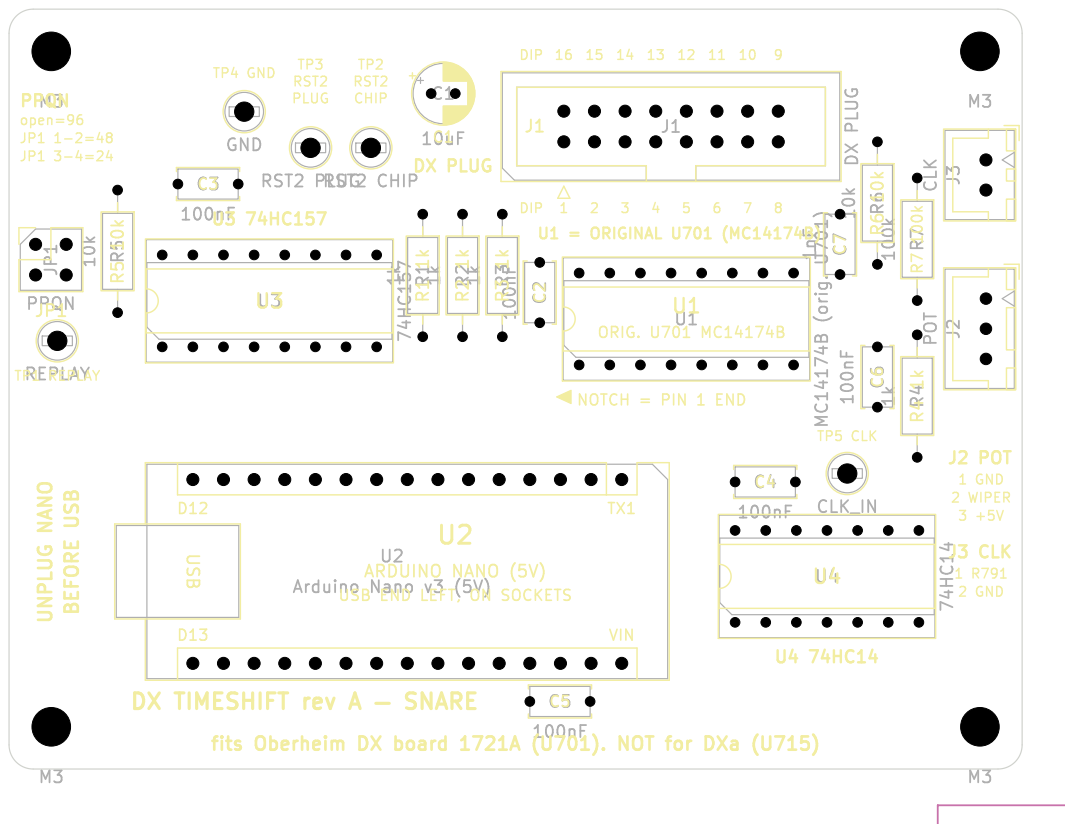
[picture p97: page 1]

2 GND NOTCH = PIN 1 END
