sabrehagen/oberheim-dx-timeshift/hardware/exports/schematic.pdf

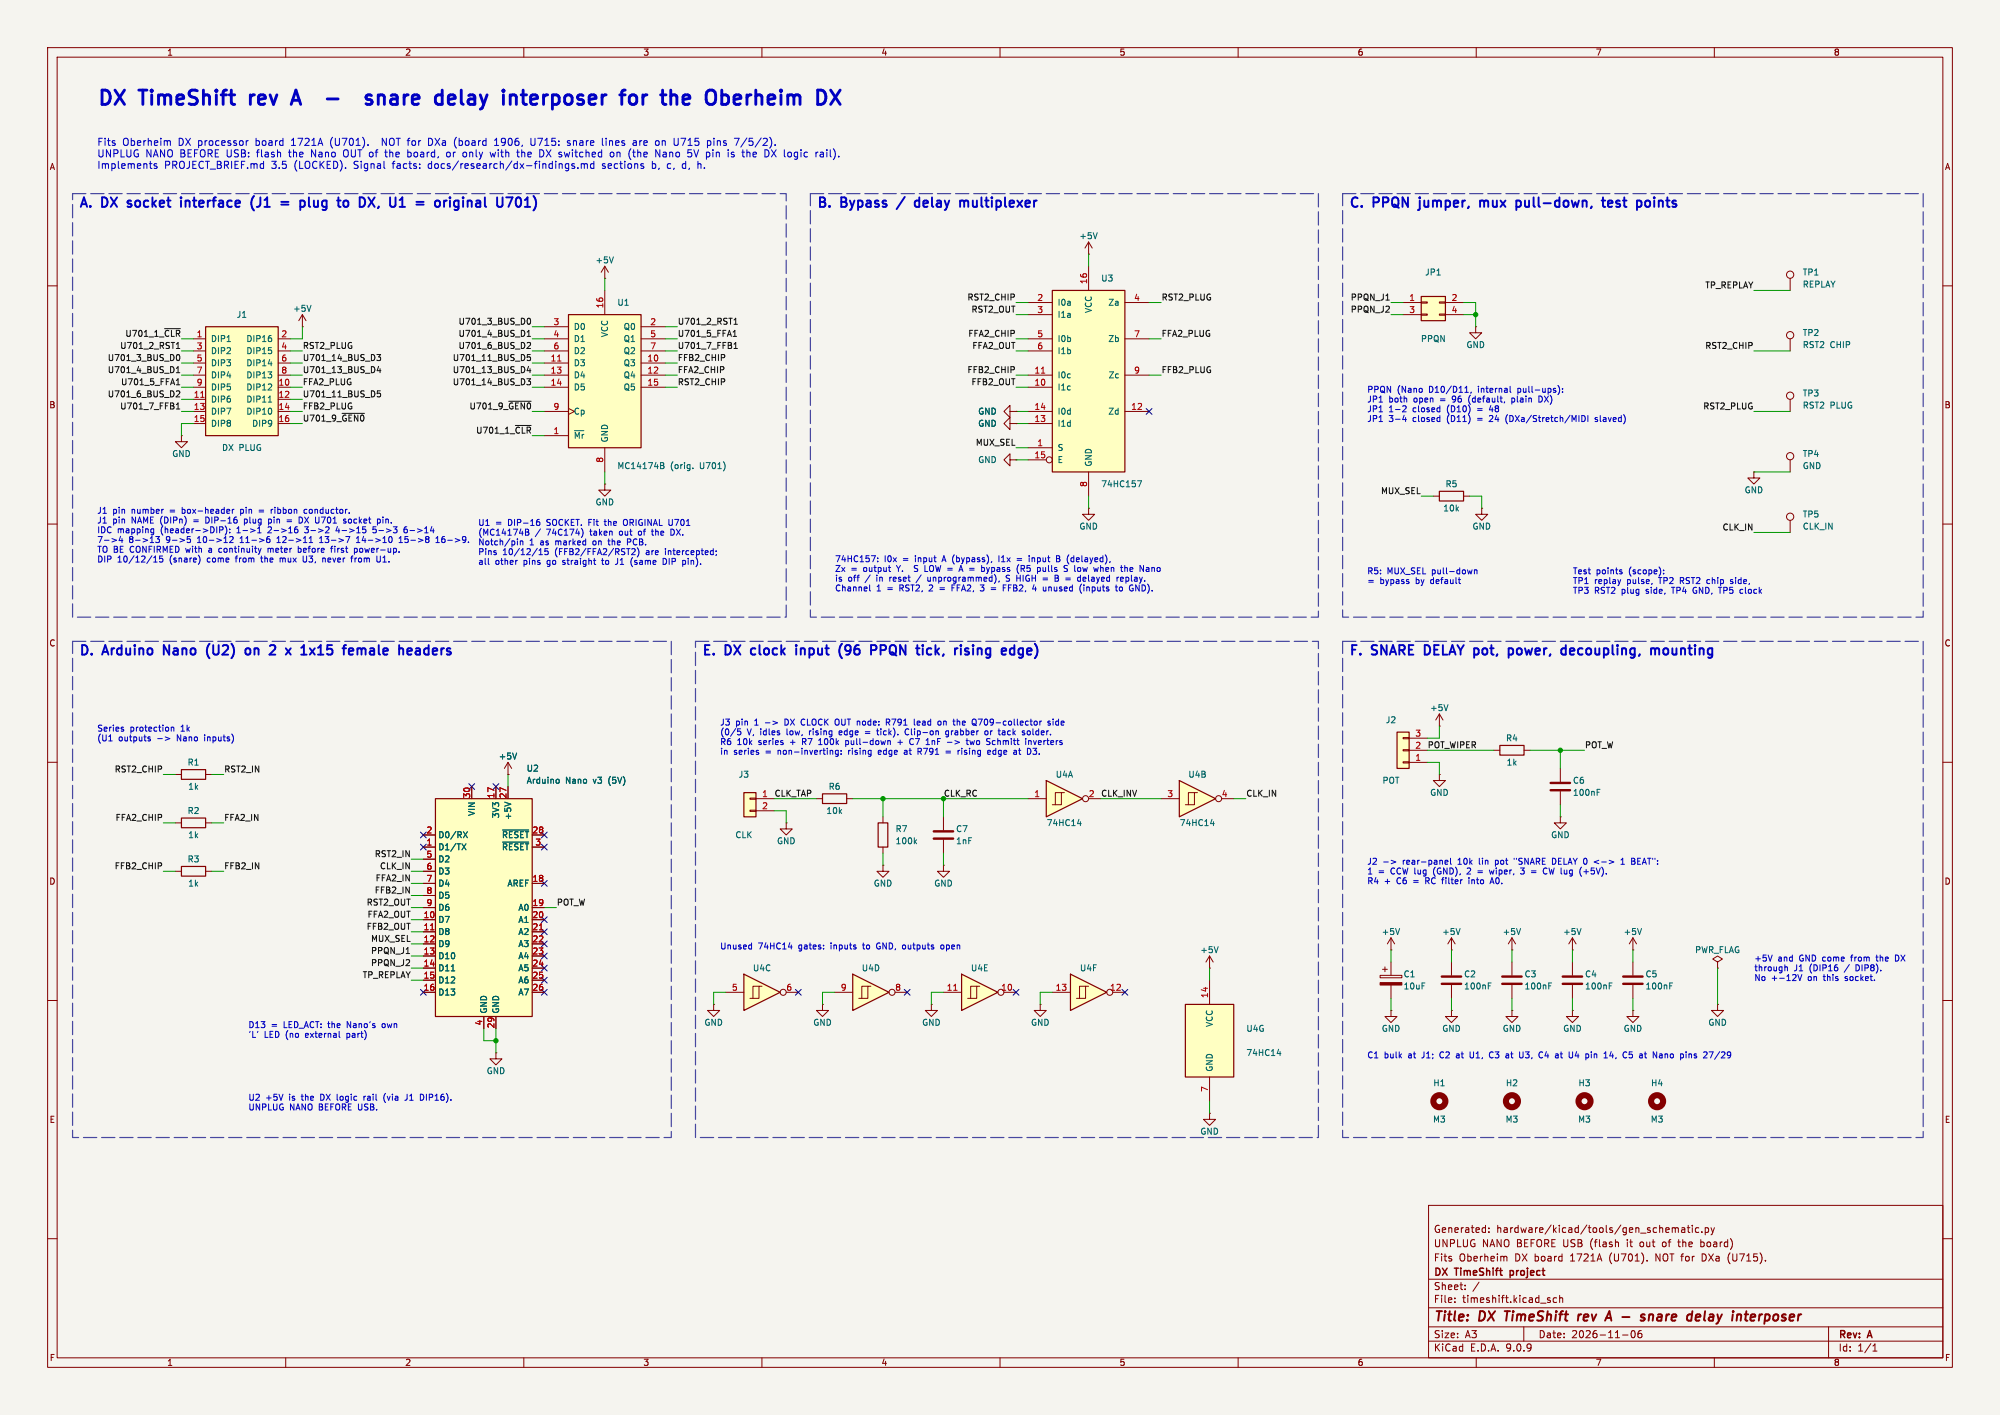
[picture p98: page 1]

A. DX socket interface (J1 = plug to DX, U1 = original U701)

~{RESET} 28 ~{RESET}3 AREF 18 A0 19 A1 20 A2 21 A3 22 A4 23 A5 24 A6 25 A7 26 U2Arduino Nano v3 (5V) R3

+5V and GND come from the DX

U2 +5V is the DX logic rail (via J1 DIP16). UNPLUG NANO BEFORE USB. D13 = LED_ACT: the Nano's own
