sabrehagen/oberheim-dx-timeshift/hardware/kicad/timeshift/timeshift.kicad_pcb

## KiCad design hardware/kicad/timeshift/timeshift.kicad_pcb (2026-11-06)

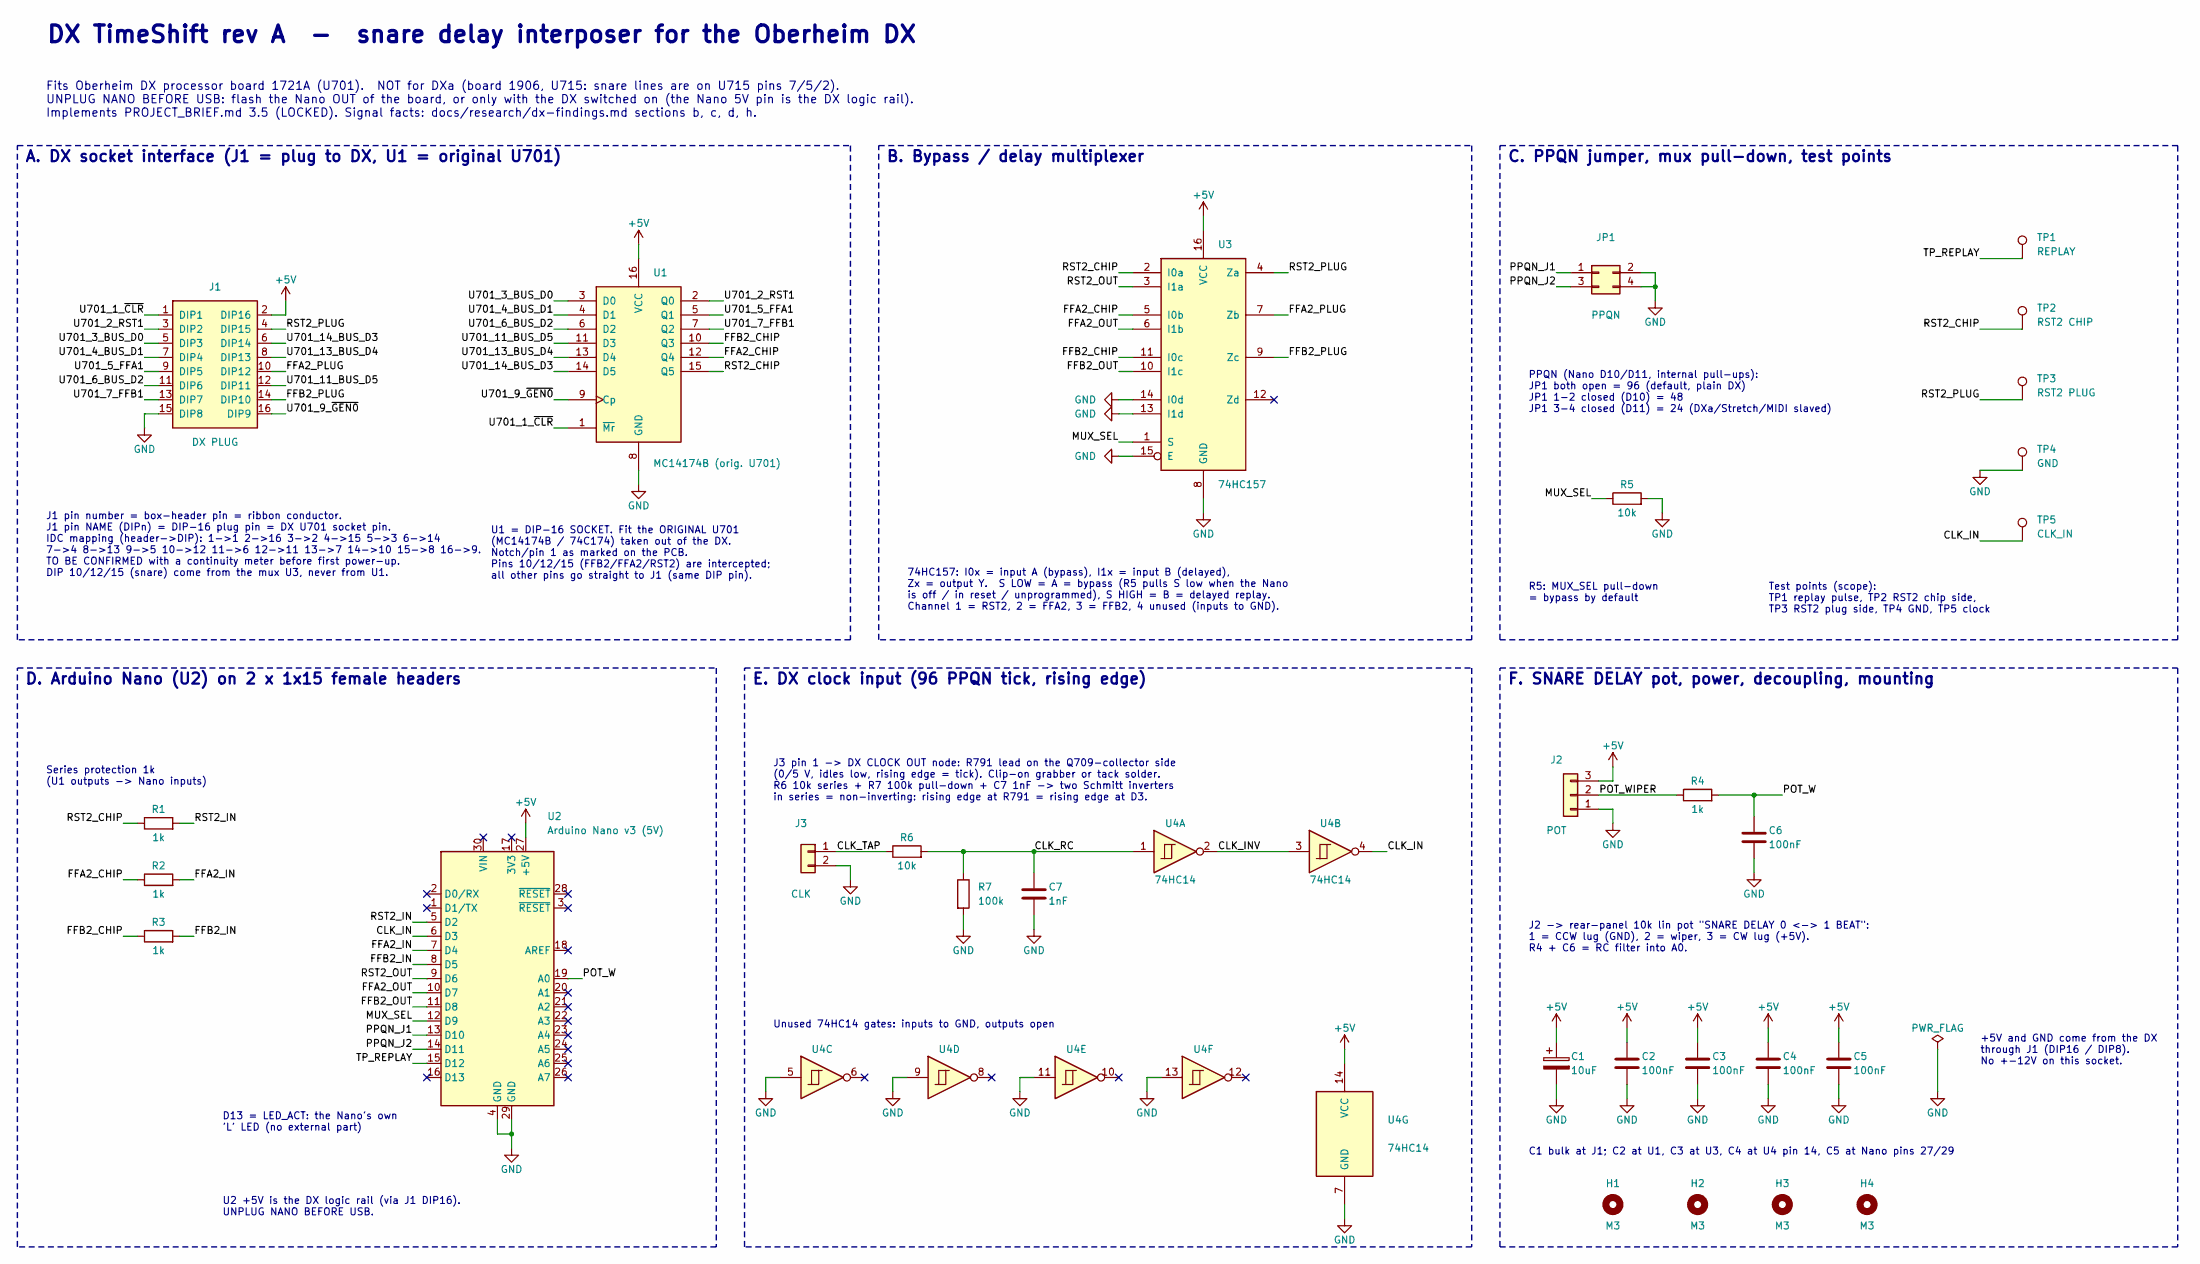
[picture p99: schematic timeshift.kicad_sch, DX TimeShift rev A - snare delay interposer]

Parts:
C1: 10uF; CP_Radial_D5.0mm_P2.00mm
C2, C3, C4, C5, C6: 100nF; C_Disc_D5.0mm_W2.5mm_P5.00mm
C7: 1nF; C_Disc_D5.0mm_W2.5mm_P5.00mm
H1, H2, H3, H4: M3; MountingHole_3.2mm_M3
J1: DX PLUG; IDC-Header_2x08_P2.54mm_Vertical; MPN 2x8 shrouded box header 2.54 mm, e.g. W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
J2: POT; JST_XH_B3B-XH-A_1x03_P2.50mm_Vertical; MPN JST B3B-XH-A (housing XHP-3, crimps SXH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
J3: CLK; JST_XH_B2B-XH-A_1x02_P2.50mm_Vertical; MPN JST B2B-XH-A (housing XHP-2, crimps SXH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
JP1: PPQN; PinHeader_2x02_P2.54mm_Vertical; MPN 2x2 pin header 2.54 mm + 1 jumper shunt
R1, R2, R3, R4: 1k; R_Axial_DIN0207_L6.3mm_D2.5mm_P10.16mm_Horizontal
R5, R6: 10k; R_Axial_DIN0207_L6.3mm_D2.5mm_P10.16mm_Horizontal
R7: 100k; R_Axial_DIN0207_L6.3mm_D2.5mm_P10.16mm_Horizontal
TP1: REPLAY; TestPoint_Keystone_5005-5009_Compact; MPN Keystone 5005 (red)
TP2: RST2 CHIP; TestPoint_Keystone_5005-5009_Compact; MPN Keystone 5005 (red)
TP3: RST2 PLUG; TestPoint_Keystone_5005-5009_Compact; MPN Keystone 5005 (red)
TP4: GND; TestPoint_Keystone_5005-5009_Compact; MPN Keystone 5006 (black)
TP5: CLK_IN; TestPoint_Keystone_5005-5009_Compact; MPN Keystone 5005 (red)
U1: MC14174B (orig. U701); DIP-16_W7.62mm_Socket; MPN DIP-16 IC socket, 7.62 mm (e.g. TE 1-21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
U2: Arduino Nano v3 (5V); Arduino_Nano_Socketed; MPN Arduino Nano v3 (A000005) or ATmega328P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
U3: 74HC157; DIP-16_W7.62mm_Socket; MPN 74HC157N (DIP-16), e.g. TI SN74HC157N
U4: 74HC14; DIP-14_W7.62mm_Socket; MPN 74HC14N (DIP-14), e.g. TI SN74HC14N

Connections:
+5V: C1.1, C2.1, C3.1, C4.1, C5.1, J1.2 (DIP16), J2.3, U1.16 (VCC), U2.27 (+5V), U3.16 (VCC), U4.14 (VCC)
/CLK_IN: TP5.1, U2.6 (D3), U4.4
/CLK_INV: U4.2, U4.3
/CLK_RC: C7.1, R6.2, R7.1, U4.1
/CLK_TAP: J3.1, R6.1
/FFA2_CHIP: R2.1, U1.12 (Q4), U3.5 (I0b)
/FFA2_IN: R2.2, U2.7 (D4)
/FFA2_OUT: U2.10 (D7), U3.6 (I1b)
/FFA2_PLUG: J1.10 (DIP12), U3.7 (Zb)
/FFB2_CHIP: R3.1, U1.10 (Q3), U3.11 (I0c)
/FFB2_IN: R3.2, U2.8 (D5)
/FFB2_OUT: U2.11 (D8), U3.10 (I1c)
/FFB2_PLUG: J1.14 (DIP10), U3.9 (Zc)
/MUX_SEL: R5.1, U2.12 (D9), U3.1 (S)
/POT_W: C6.1, R4.2, U2.19 (A0)
/POT_WIPER: J2.2, R4.1
/PPQN_J1: JP1.1, U2.13 (D10)
/PPQN_J2: JP1.3, U2.14 (D11)
/RST2_CHIP: R1.1, TP2.1, U1.15 (Q5), U3.2 (I0a)
/RST2_IN: R1.2, U2.5 (D2)
/RST2_OUT: U2.9 (D6), U3.3 (I1a)
/RST2_PLUG: J1.4 (DIP15), TP3.1, U3.4 (Za)
/TP_REPLAY: TP1.1, U2.15 (D12)
/U701_1_~CLR: J1.1 (DIP1), U1.1 (~Mr)
/U701_2_RST1: J1.3 (DIP2), U1.2 (Q0)
/U701_3_BUS_D0: J1.5 (DIP3), U1.3 (D0)
/U701_4_BUS_D1: J1.7 (DIP4), U1.4 (D1)
/U701_5_FFA1: J1.9 (DIP5), U1.5 (Q1)
/U701_6_BUS_D2: J1.11 (DIP6), U1.6 (D2)
/U701_7_FFB1: J1.13 (DIP7), U1.7 (Q2)
/U701_9_~GEN0: J1.16 (DIP9), U1.9 (Cp)
/U701_11_BUS_D5: J1.12 (DIP11), U1.11 (D3)
/U701_13_BUS_D4: J1.8 (DIP13), U1.13 (D4)
/U701_14_BUS_D3: J1.6 (DIP14), U1.14 (D5)
GND: C1.2, C2.2, C3.2, C4.2, C5.2, C6.2, C7.2, J1.15 (DIP8), J2.1, J3.2, JP1.2, JP1.4, R5.2, R7.2, TP4.1, U1.8 (GND), U2.4 (GND), U2.29 (GND), U3.8 (GND), U3.13 (I1d), U3.14 (I0d), U3.15 (E), U4.5, U4.7 (GND), U4.9, U4.11, U4.13

Notes on the sheet:
DX TimeShift rev A - snare delay interposer for the Oberheim DX
Fits Oberheim DX processor board 1721A (U701). NOT for DXa (board 1906, U715: snare lines are on U715 pins 7/5/2). UNPLUG NANO BEFORE USB: flash the Nano OUT of the board, or only with the DX switched on (the Nano 5V pin is the DX logic rail). Implements PROJECT_BRIEF.md 3.5 (LOCKED). Signal facts: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
A. DX socket interface (J1 = plug to DX, U1 = original U701)
J1 pin number = box-header pin = ribbon conductor. J1 pin NAME (DIPn) = DIP-16 plug pin = DX U701 socket pin. IDC mapping (header->DIP): 1->1 2->16 3->2 4->15 5->3 6->14 7->4 8->13 9->5 10->12 11->6 12->11 13->7 14->10 15->8 16->9. TO BE CONFIRMED with a continuity meter before first power-up. DIP 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
U1 = DIP-16 SOCKET. Fit the ORIGINAL U701 (MC14174B / 74C174) taken out of the DX. Notch/pin 1 as marked on the PCB. Pins 10/12/15 (FFB2/FFA2/RST2) are intercepted; all other pins go straight to J1 (same DIP pin).
B. Bypass / delay multiplexer
74HC157: I0x = input A (bypass), I1x = input B (delayed), Zx = output Y. S LOW = A = bypass (R5 pulls S low when the Nano is off / in reset / unprogrammed), S HIGH = B = delayed replay. Channel 1 = RST2, 2 = FFA2, 3 = FFB2, 4 unused (inputs to GND).
C. PPQN jumper, mux pull-down, test points
PPQN (Nano D10/D11, internal pull-ups): JP1 both open = 96 (default, plain DX) JP1 1-2 closed (D10) = 48 JP1 3-4 closed (D11) = 24 (DXa/Stretch/MIDI slaved)
R5: MUX_SEL pull-down = bypass by default
Test points (scope): TP1 replay pulse, TP2 RST2 chip side, TP3 RST2 plug side, TP4 GND, TP5 clock
D. Arduino Nano (U2) on 2 x 1x15 female headers
D13 = LED_ACT: the Nano's own 'L' LED (no external part)
U2 +5V is the DX logic rail (via J1 DIP16). UNPLUG NANO BEFORE USB.
Series protection 1k (U1 outputs -> Nano inputs)
E. DX clock input (96 PPQN tick, rising edge)
J3 pin 1 -> DX CLOCK OUT node: R791 lead on the Q709-collector side (0/5 V, idles low, rising edge = tick). Clip-on grabber or tack solder. R6 10k series + R7 100k pull-down + C7 1nF -> two Schmitt inverters in series = non-inverting: rising edge at R791 = rising edge at D3.
Unused 74HC14 gates: inputs to GND, outputs open
F. SNARE DELAY pot, power, decoupling, mounting
J2 -> rear-panel 10k lin pot "SNARE DELAY 0 <-> 1 BEAT": 1 = CCW lug (GND), 2 = wiper, 3 = CW lug (+5V). R4 + C6 = RC filter into A0.
C1 bulk at J1; C2 at U1, C3 at U3, C4 at U4 pin 14, C5 at Nano pins 27/29
+5V and GND come from the DX through J1 (DIP16 / DIP8). No +-12V on this socket.

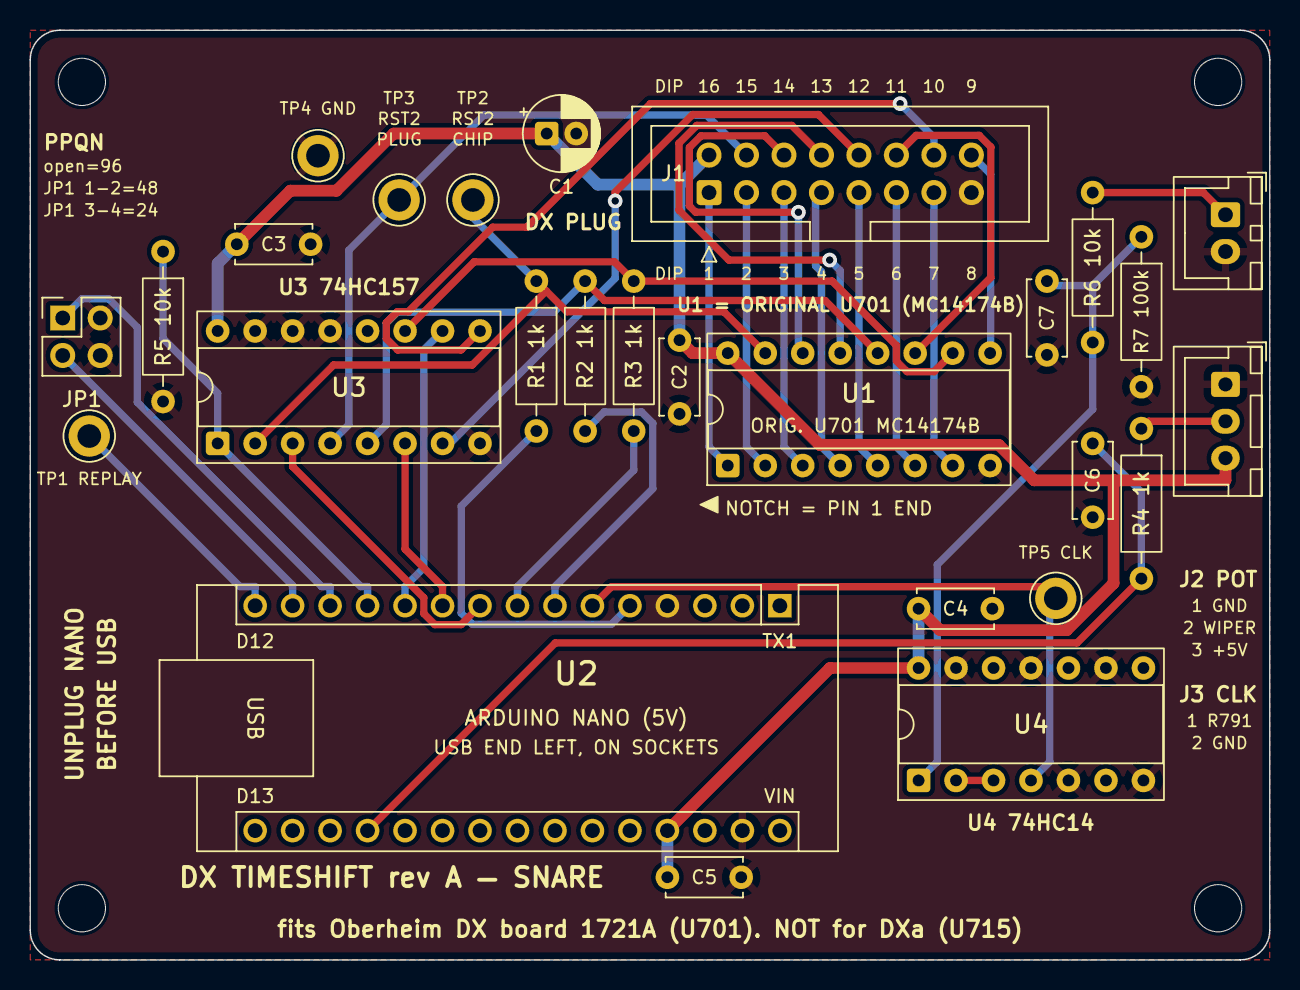
[picture p100: board timeshift.kicad_pcb from above]

Board: 2 copper layers, 84.0 x 63.0 mm, 31 parts (0 on the bottom side), 35 nets.
