sabrehagen/oberheim-dx-timeshift/(commit log)

2026-11-06 DX TimeShift rev A: snare trigger delay mod for the Oberheim DX
    Complete design package for a plug-in interposer that delays the Oberheim
    DX snare trigger by 0 to 1 beat from a rear-panel pot, tempo-synced to the
    DX 96 PPQN clock.
    - docs/: technician handover (start here, theory, build, install, test,
    bench verification), BOM with Digi-Key/Mouser numbers, research findings
    with citations, collected reference manuals, independent design review
    - hardware/: KiCad 9 project (ERC/DRC clean), Gerbers, STEP/GLB, renders,
    assembly diagram, rear-panel drill template, wiring diagrams
    - firmware/: Arduino Nano sketch, host-side simulation tests (150 pass),
    prebuilt hex
    - webapp/: Three.js sta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
    [Arduino_Nano_v3_on_sockets.step, board.step, bom.csv, positions.csv, rear-panel-drill-template.dxf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]
2026-11-06 Docs: record owner's note that the voice chips were socketed (Q1 context)
